IowaScaledEngineering/ckt-dingdong/doc/uss-teardrop.odt

Union Switch & Signal

Teardrop (Mechanical)

uss-teardrop.hex

Union Switch & Signal

Teardrop (Mechanical)

uss-teardrop.hex

Union Switch & Signal

Teardrop (Mechanical)

uss-teardrop.hex

Union Switch & Signal

Teardrop (Mechanical)

uss-teardrop.hex

Union Switch & Signal

Teardrop (Mechanical)

uss-teardrop.hex

Union Switch & Signal

Teardrop (Mechanical)

uss-teardrop.hex

Union Switch & Signal

Teardrop (Mechanical)

uss-teardrop.hex

Union Switch & Signal

Teardrop (Mechanical)

uss-teardrop.hex

Union Switch & Signal

Teardrop (Mechanical)

uss-teardrop.hex

Union Switch & Signal

Teardrop (Mechanical)

uss-teardrop.hex

Union Switch & Signal

Teardrop (Mechanical)

uss-teardrop.hex

Union Switch & Signal

Teardrop (Mechanical)

uss-teardrop.hex

Union Switch & Signal

Teardrop (Mechanical)

uss-teardrop.hex

Union Switch & Signal

Teardrop (Mechanical)

uss-teardrop.hex

Union Switch & Signal

Teardrop (Mechanical)

uss-teardrop.hex

Union Switch & Signal

Teardrop (Mechanical)

uss-teardrop.hex

Union Switch & Signal

Teardrop (Mechanical)

uss-teardrop.hex

Union Switch & Signal

Teardrop (Mechanical)

uss-teardrop.hex

Union Switch & Signal

Teardrop (Mechanical)

uss-teardrop.hex

Union Switch & Signal

Teardrop (Mechanical)

uss-teardrop.hex

Union Switch & Signal

Teardrop (Mechanical)

uss-teardrop.hex

Union Switch & Signal

Teardrop (Mechanical)

uss-teardrop.hex

Union Switch & Signal

Teardrop (Mechanical)

uss-teardrop.hex

Union Switch & Signal

Teardrop (Mechanical)

uss-teardrop.hex

Union Switch & Signal

Teardrop (Mechanical)

uss-teardrop.hex

Union Switch & Signal

Teardrop (Mechanical)

uss-teardrop.hex

Union Switch & Signal

Teardrop (Mechanical)

uss-teardrop.hex

Union Switch & Signal

Teardrop (Mechanical)

uss-teardrop.hex

Union Switch & Signal

Teardrop (Mechanical)

uss-teardrop.hex

Union Switch & Signal

Teardrop (Mechanical)

uss-teardrop.hex
