IowaScaledEngineering/ckt-dingdong/doc/wrs-222.odt

Western Railroad Supply

Type 222 (Mechanical)

wrs-222.hex

Western Railroad Supply

Type 222 (Mechanical)

wrs-222.hex

Western Railroad Supply

Type 222 (Mechanical)

wrs-222.hex

Western Railroad Supply

Type 222 (Mechanical)

wrs-222.hex

Western Railroad Supply

Type 222 (Mechanical)

wrs-222.hex

Western Railroad Supply

Type 222 (Mechanical)

wrs-222.hex

Western Railroad Supply

Type 222 (Mechanical)

wrs-222.hex

Western Railroad Supply

Type 222 (Mechanical)

wrs-222.hex

Western Railroad Supply

Type 222 (Mechanical)

wrs-222.hex

Western Railroad Supply

Type 222 (Mechanical)

wrs-222.hex

Western Railroad Supply

Type 222 (Mechanical)

wrs-222.hex

Western Railroad Supply

Type 222 (Mechanical)

wrs-222.hex

Western Railroad Supply

Type 222 (Mechanical)

wrs-222.hex

Western Railroad Supply

Type 222 (Mechanical)

wrs-222.hex

Western Railroad Supply

Type 222 (Mechanical)

wrs-222.hex

Western Railroad Supply

Type 222 (Mechanical)

wrs-222.hex

Western Railroad Supply

Type 222 (Mechanical)

wrs-222.hex

Western Railroad Supply

Type 222 (Mechanical)

wrs-222.hex

Western Railroad Supply

Type 222 (Mechanical)

wrs-222.hex

Western Railroad Supply

Type 222 (Mechanical)

wrs-222.hex

Western Railroad Supply

Type 222 (Mechanical)

wrs-222.hex

Western Railroad Supply

Type 222 (Mechanical)

wrs-222.hex

Western Railroad Supply

Type 222 (Mechanical)

wrs-222.hex

Western Railroad Supply

Type 222 (Mechanical)

wrs-222.hex

Western Railroad Supply

Type 222 (Mechanical)

wrs-222.hex

Western Railroad Supply

Type 222 (Mechanical)

wrs-222.hex

Western Railroad Supply

Type 222 (Mechanical)

wrs-222.hex

Western Railroad Supply

Type 222 (Mechanical)

wrs-222.hex

Western Railroad Supply

Type 222 (Mechanical)

wrs-222.hex

Western Railroad Supply

Type 222 (Mechanical)

wrs-222.hex
