IowaScaledEngineering/ckt-dingdong/doc/datasheets/drawing-13x18.png

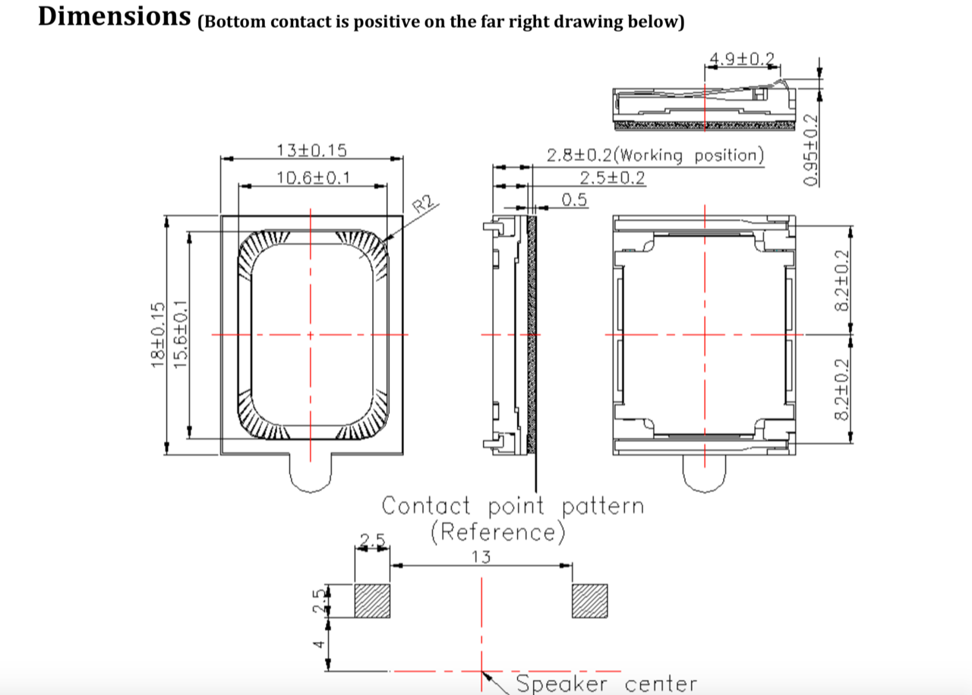
doc/datasheets/drawing-13x18.png
