IowaScaledEngineering/ckt-dingdong/doc/soundbytes-wiring.png

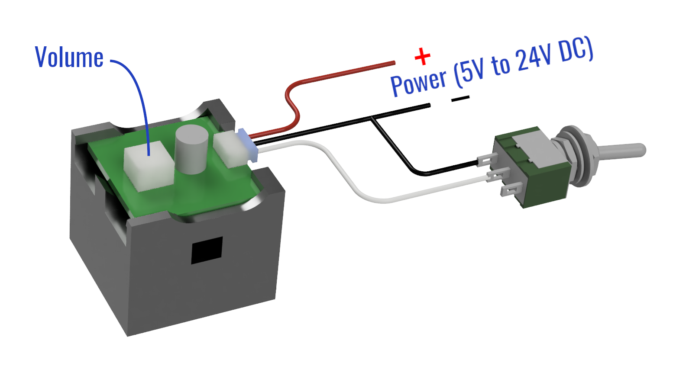
doc/soundbytes-wiring.png
