IowaScaledEngineering/ckt-dingdong/pg/ckt-dingdong-spk-array-v2.0-9ae124d/ckt-dingdong-spk.pdf

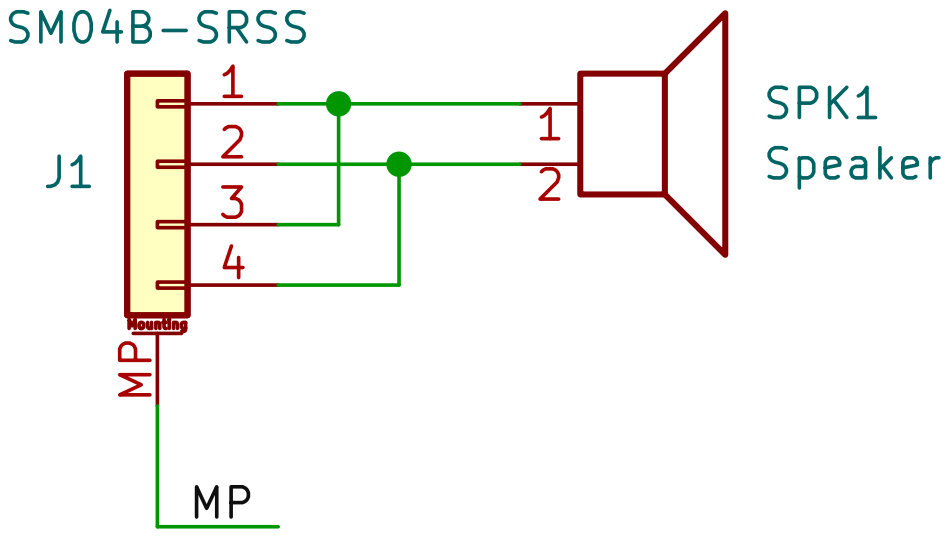
[picture p14: page 1]

File: ckt-dingdong-spk.kicad_sch Sheet: /
Id: 1/1 Title:
