IowaScaledEngineering/ckt-dingdong/pg/ckt-dingdong-prog-v1.2-79bff29/ckt-dingdong-prog.pdf

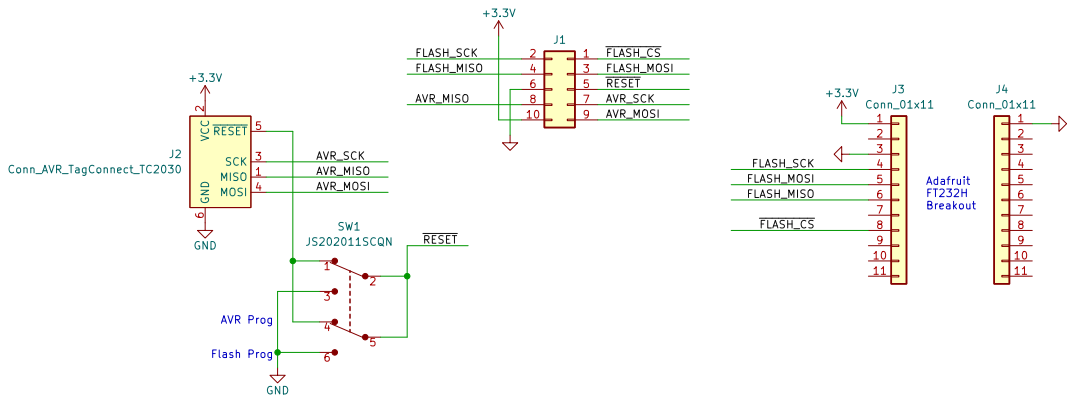
[picture p15: page 1]

2 SCK 3 MOSI 4 ~{RESET} 5 GND

File: ckt-dingdong-prog.kicad_sch Sheet: /
Id: 1/1 Title:
