IowaScaledEngineering/ckt-dingdong/pg/ckt-dingdong-flash-array-v1.0-cea9687/ckt-dingdong-flash.pdf

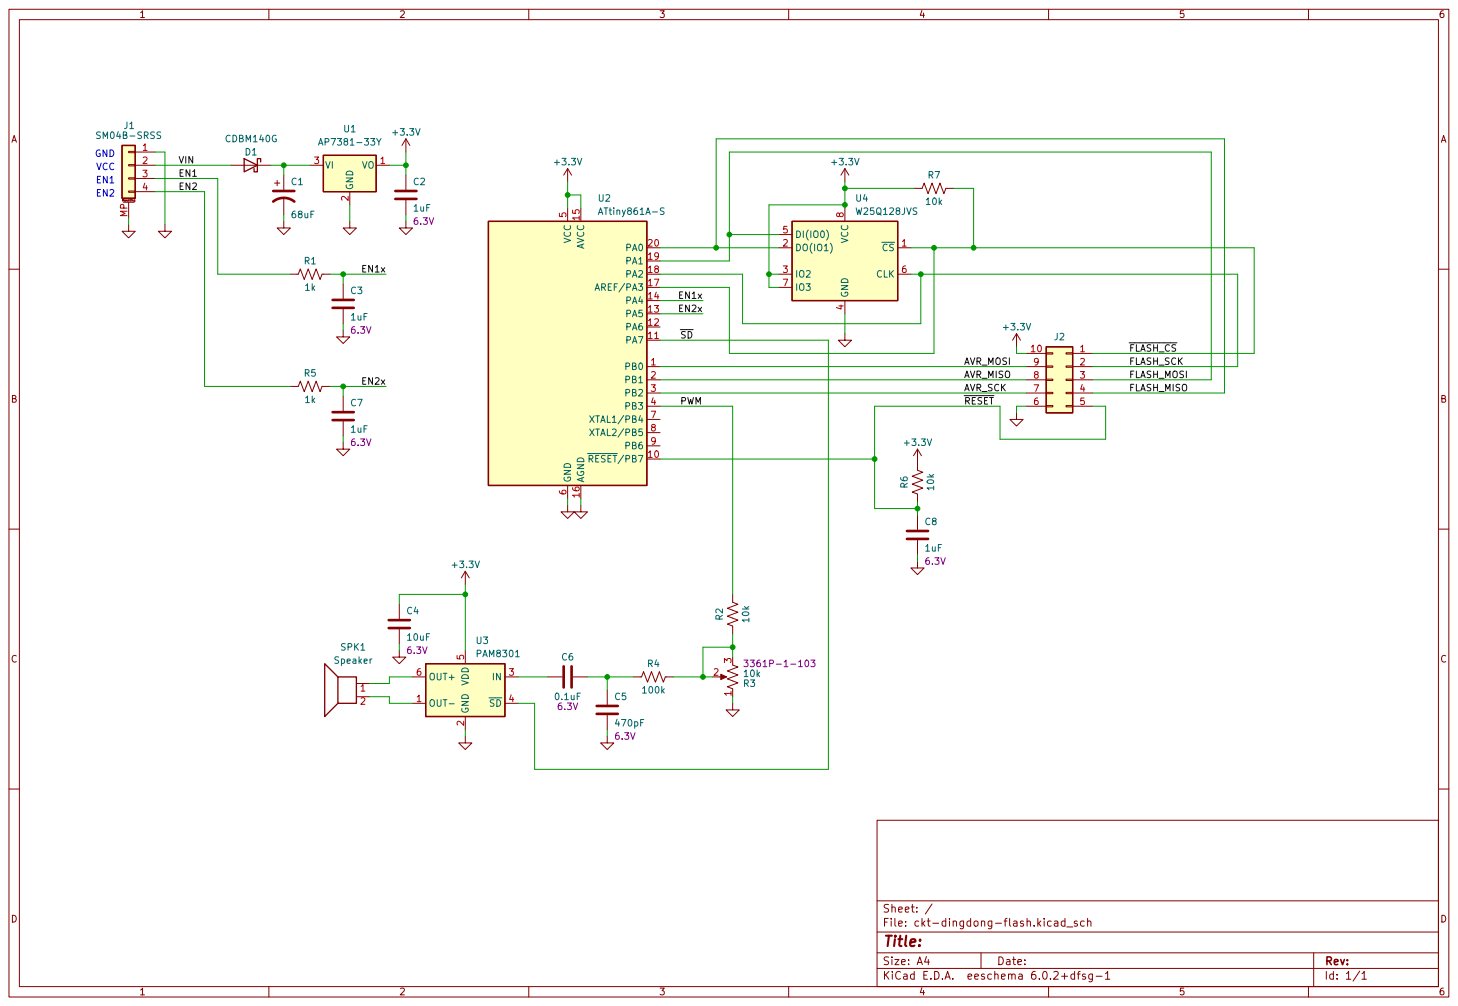
[picture p16: page 1]

AVR_MOSI AVR_SCK AVR_MISO 8 | 3

File: ckt-dingdong-flash.kicad_sch Sheet: / +3.3V C4
