IowaScaledEngineering/ckt-dingdong/pg/ckt-dingdong-v2.0-0ca3188/ckt-dingdong.pdf

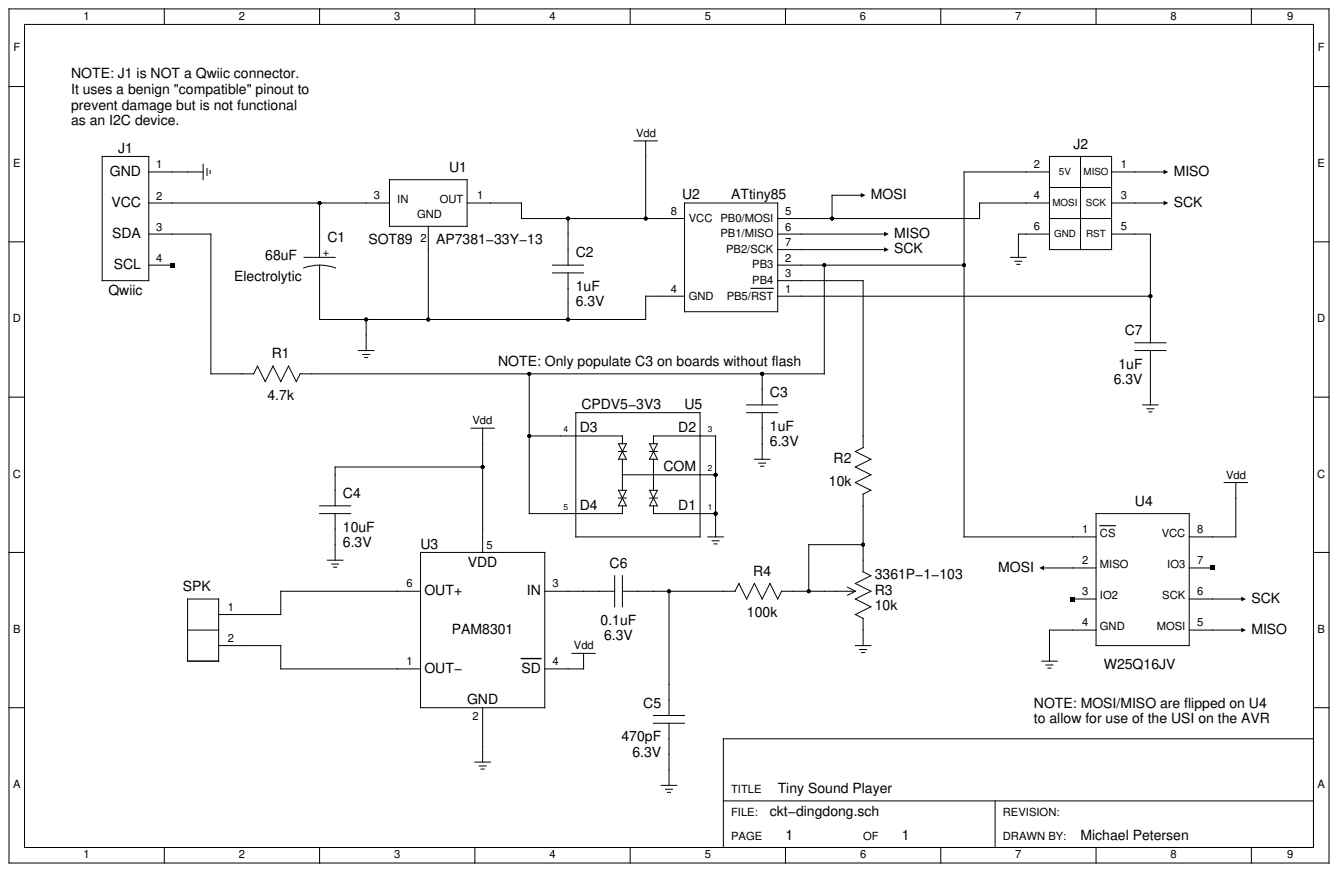
[picture p17: page 1]

NOTE: J1 is NOT a Qwiic connector.
It uses a benign "compatible" pinout to
prevent damage but is not functional
as an I2C device.

3 PB4
1 PB5/RST

NOTE: Only populate C3 on boards without flash

NOTE: MOSI/MISO are flipped on U4
to allow for use of the USI on the AVR
