IowaScaledEngineering/ckt-dingdong/pg/ckt-dingdong-flash-v1.0-e6c6ba8/ckt-dingdong-flash.pdf

AVR_MOSI AVR_SCK AVR_MISO 8 | 3

File: ckt-dingdong-flash.kicad_sch Sheet: / +3.3V C4
