IowaScaledEngineering/ckt-dingdong/pg/ckt-dingdong-array-v1.1-d16e484/ckt-dingdong-array-pcb.pdf

# ckt-dingdong-array.pcb

# 1. Table of Contents (This Page) Created on Sat May 14 21:11:04 2022

# 2. top 3. bottom 4. outline 5. plated-drill 6. unplated-drill 7. componentmask 8. soldermask 9. topsilk 10. bottomsilk 11. toppaste 12. bottompaste 13. topassembly 14. bottomassembly 15. fab

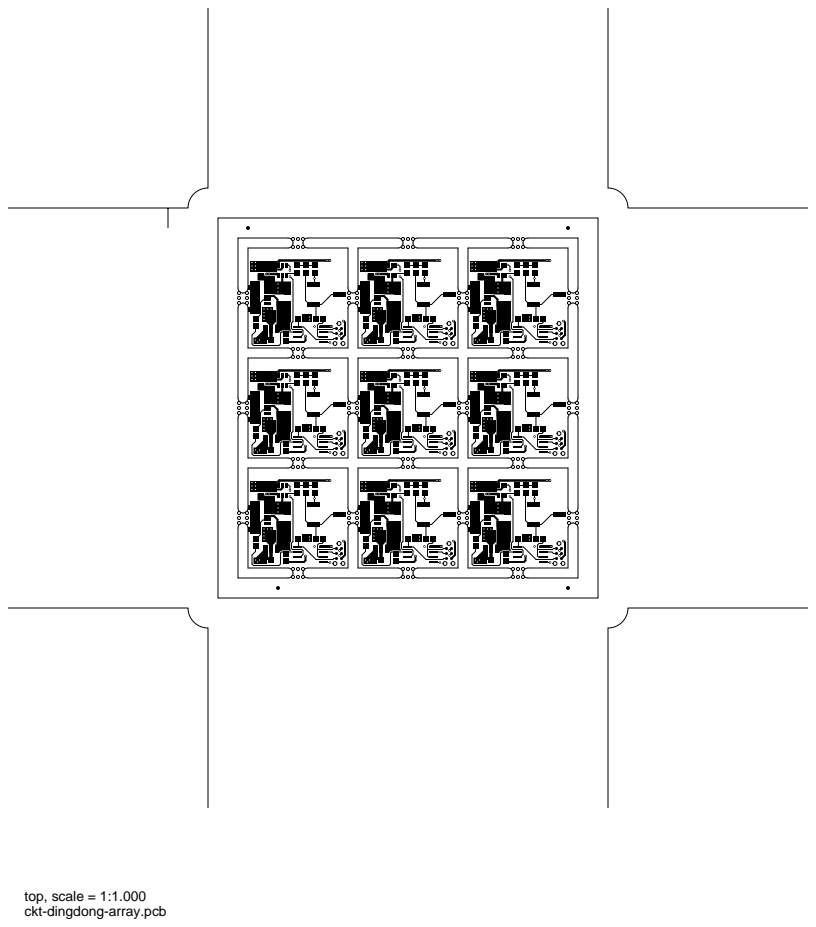
[picture p18: page 2]
top, scale = 1:1.000

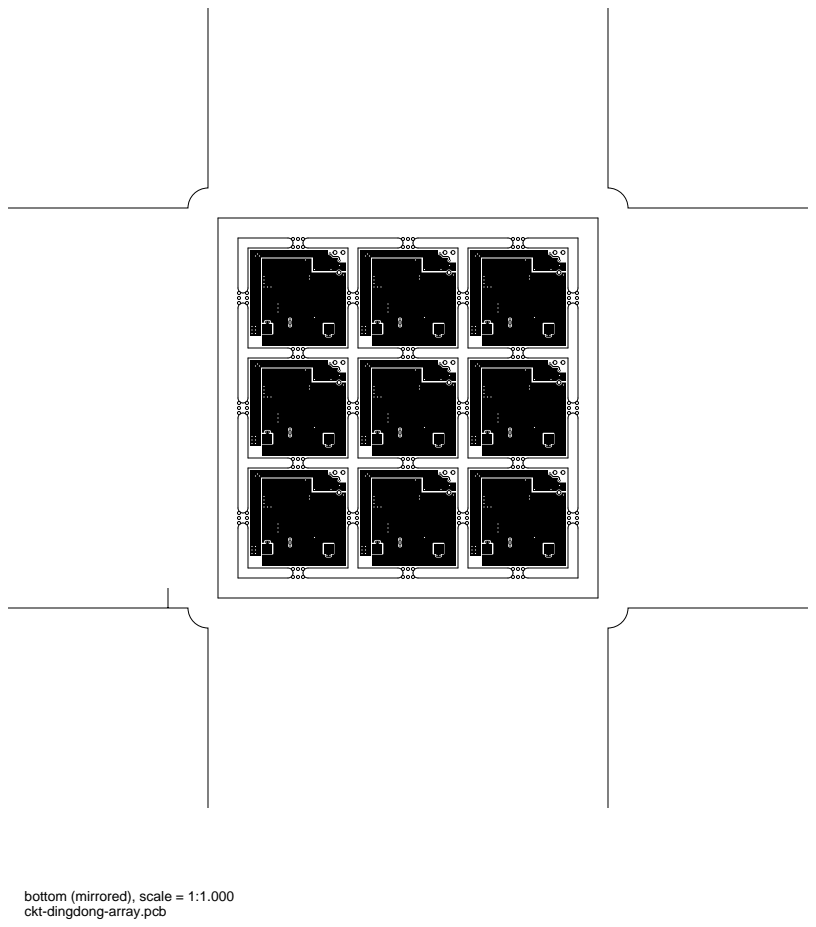
[picture p19: page 3]

bottom (mirrored), scale = 1:1.000

outline, scale = 1:1.000

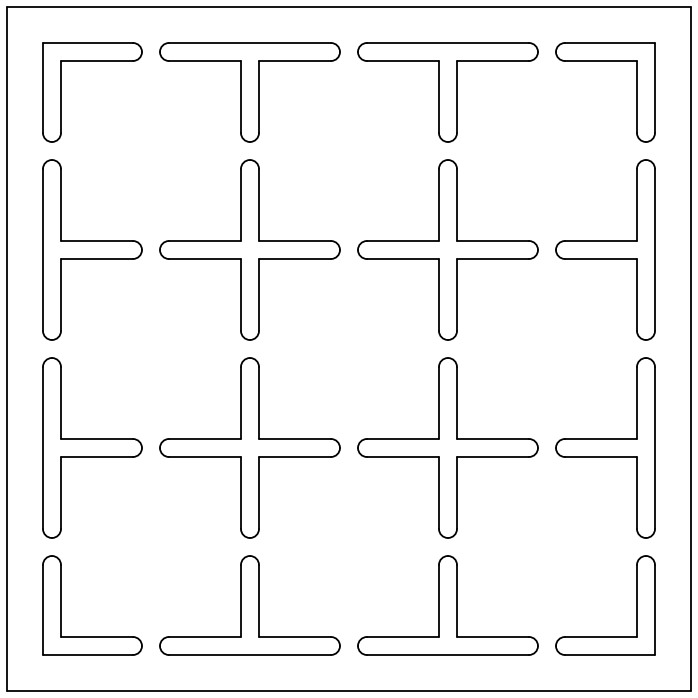
[picture p20: figure]
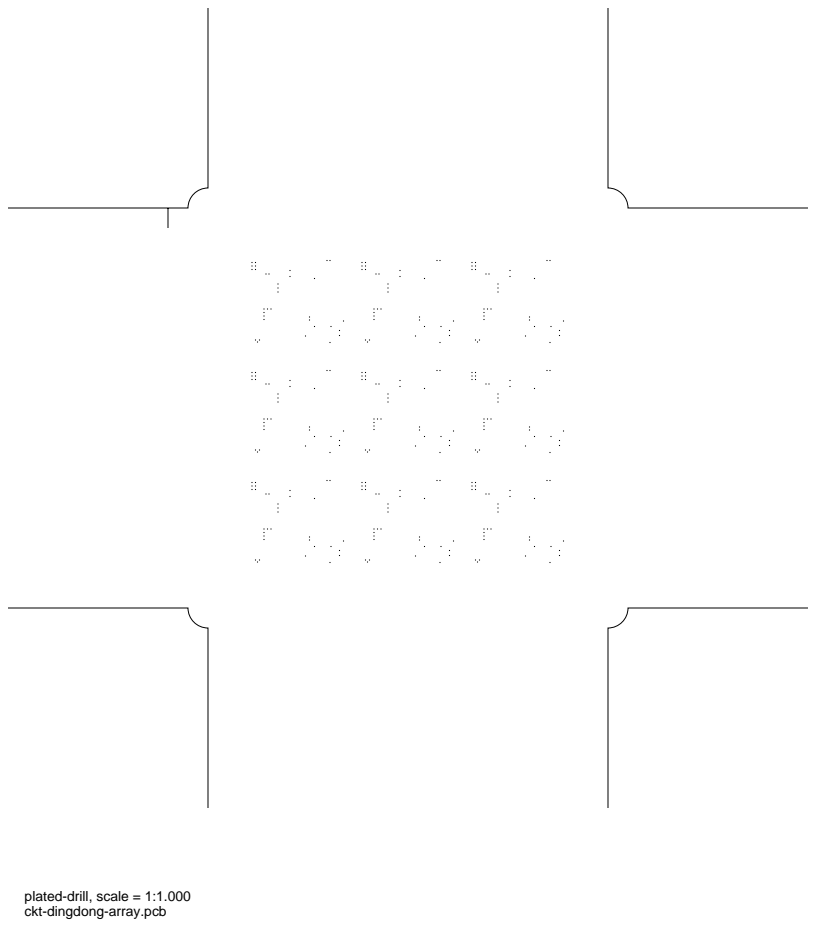
[picture p21: page 5]

plated-drill, scale = 1:1.000

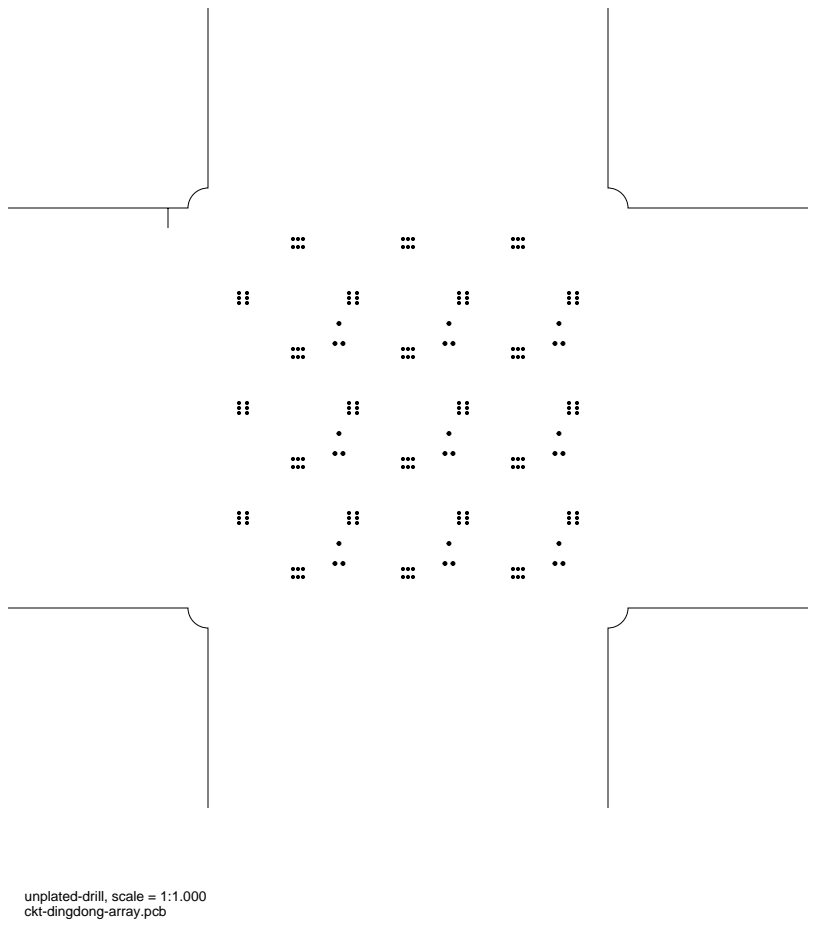
[picture p22: page 6]

unplated-drill, scale = 1:1.000

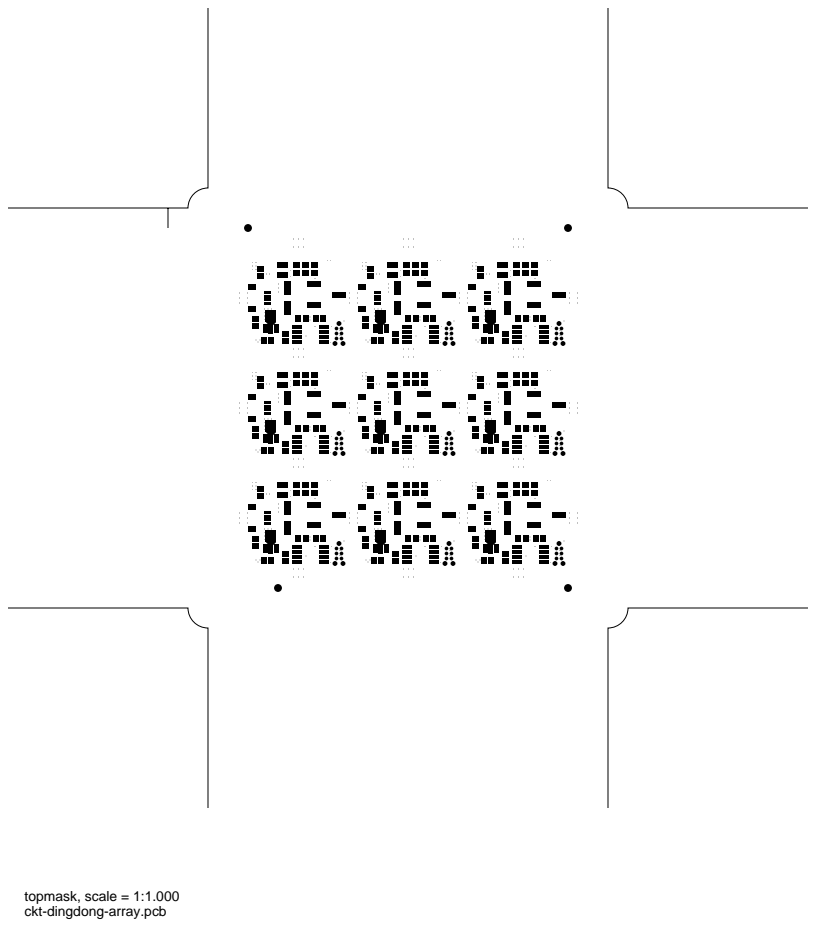
[picture p23: page 7]
topmask, scale = 1:1.000

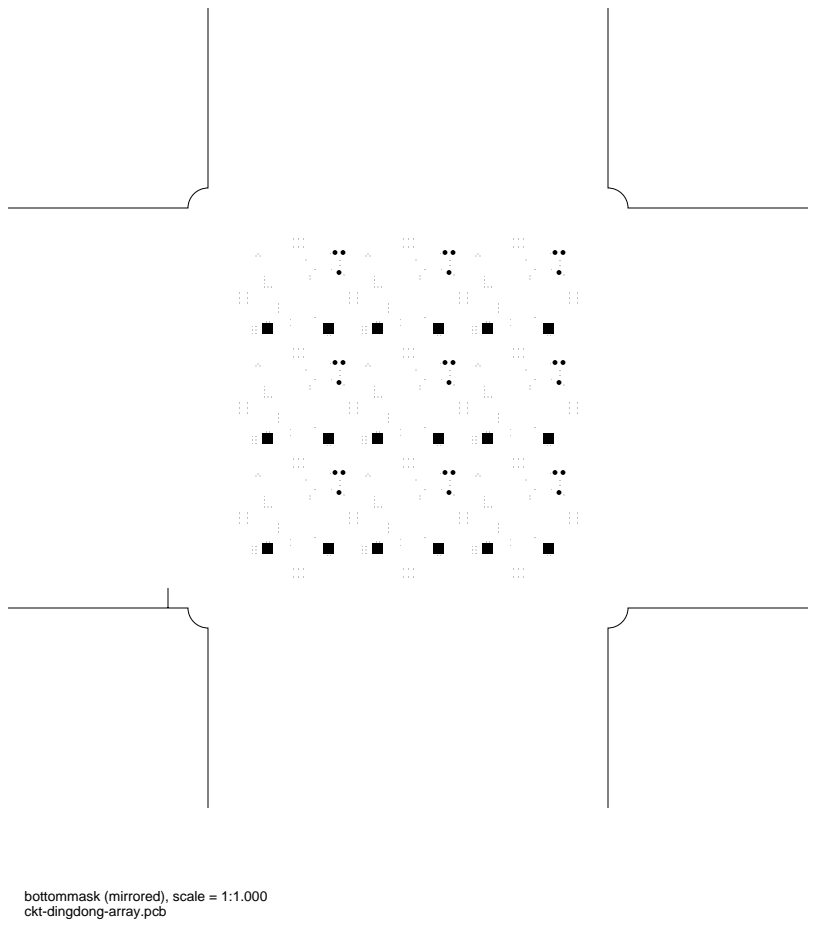
[picture p24: page 8]

bottommask (mirrored), scale = 1:1.000

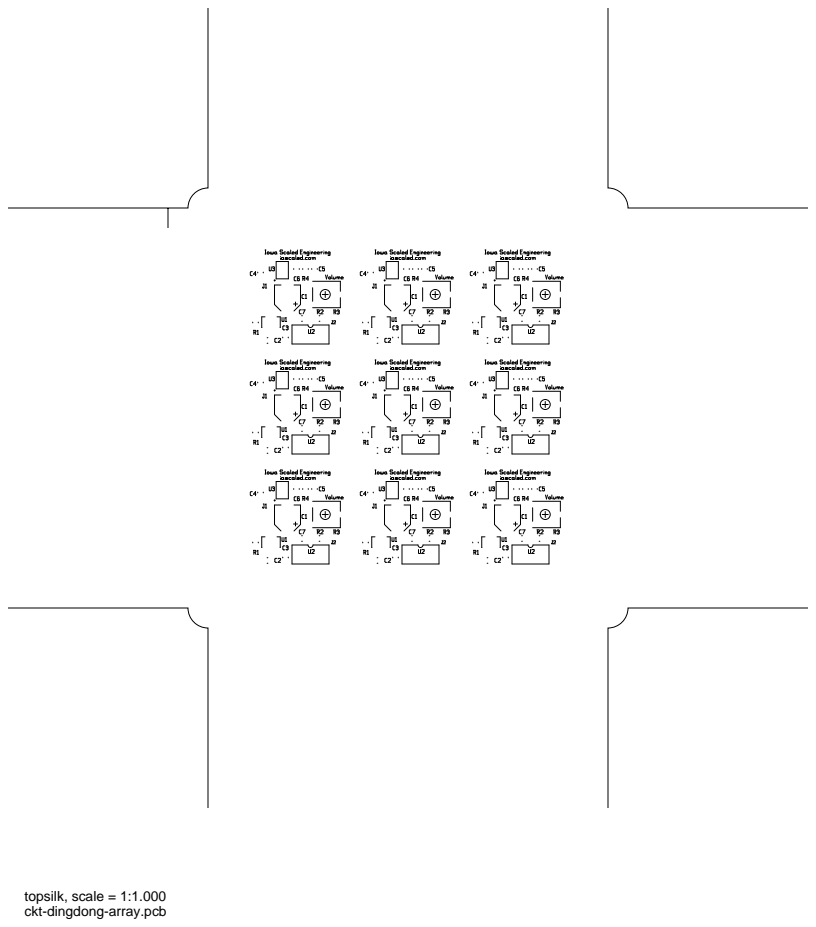
[picture p25: page 9]
topsilk, scale = 1:1.000

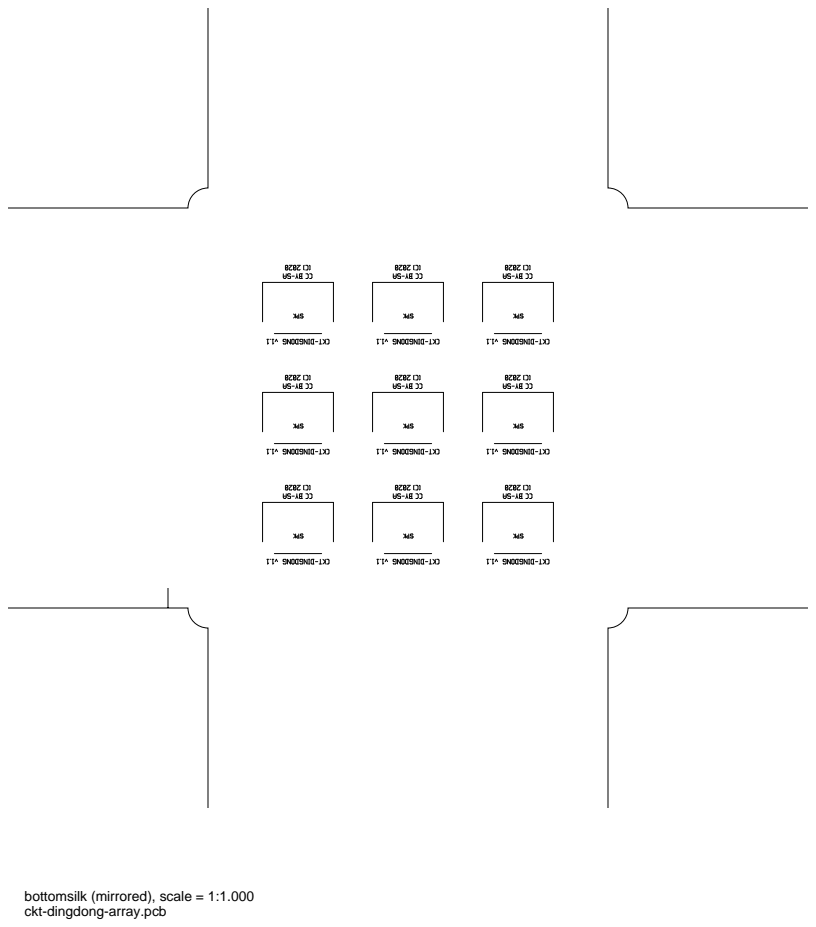
[picture p26: page 10]

bottomsilk (mirrored), scale = 1:1.000

toppaste, scale = 1:1.000 bottompaste (mirrored), scale = 1:1.000

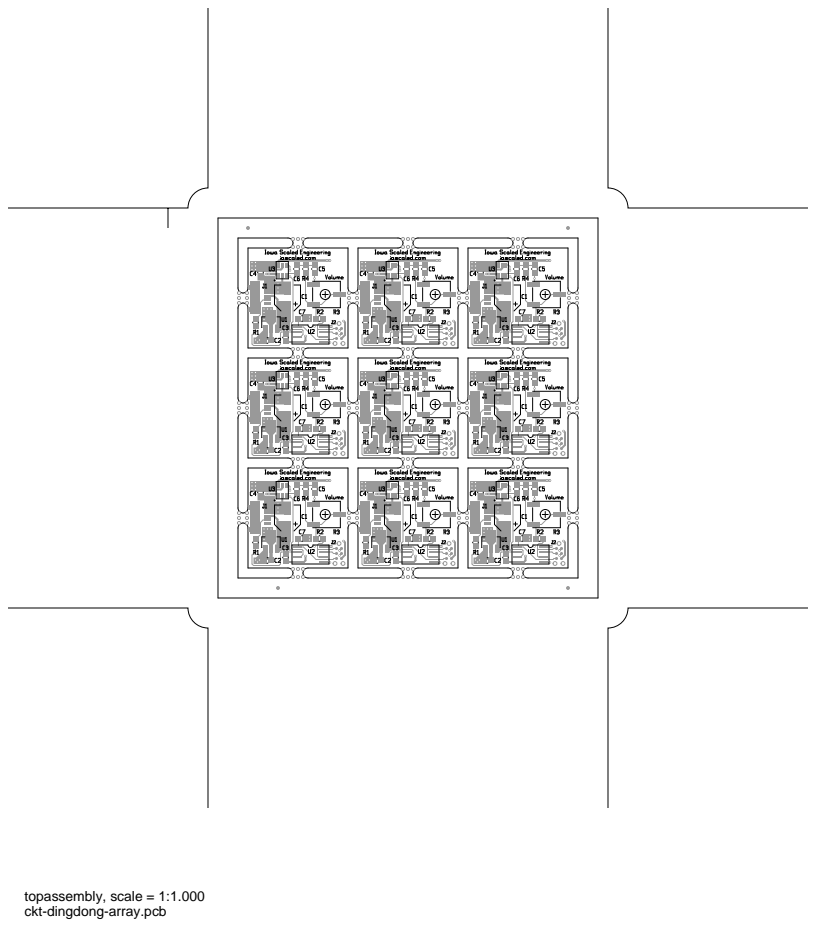
[picture p27: page 13]
topassembly, scale = 1:1.000

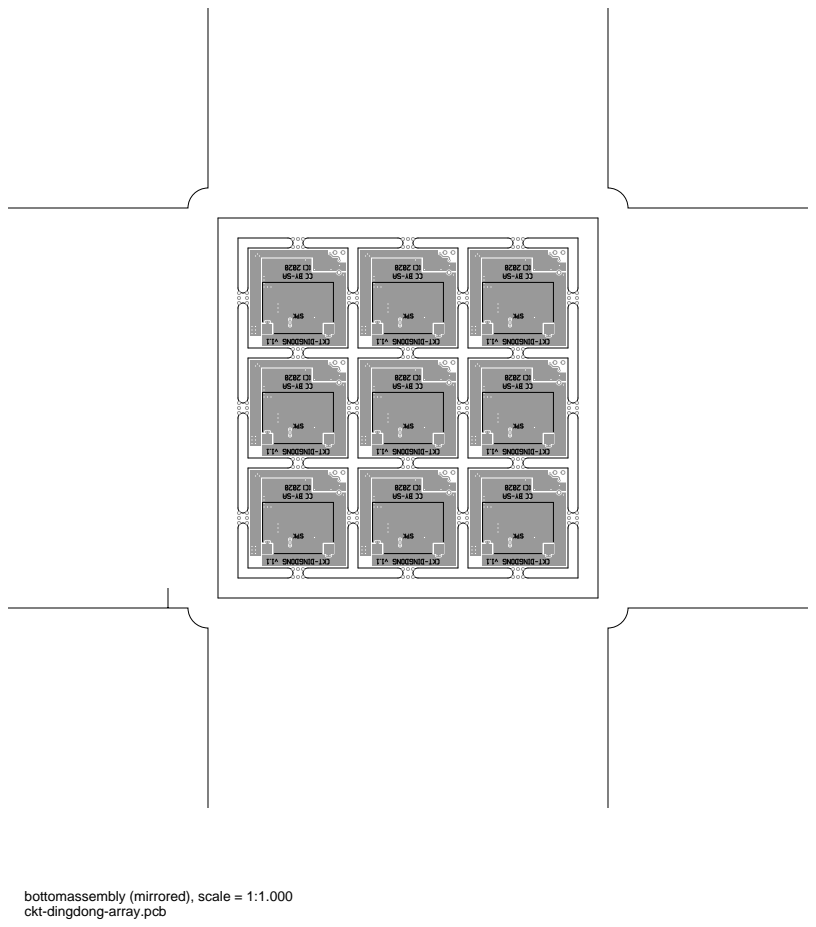
[picture p28: page 14]

bottomassembly (mirrored), scale = 1:1.000

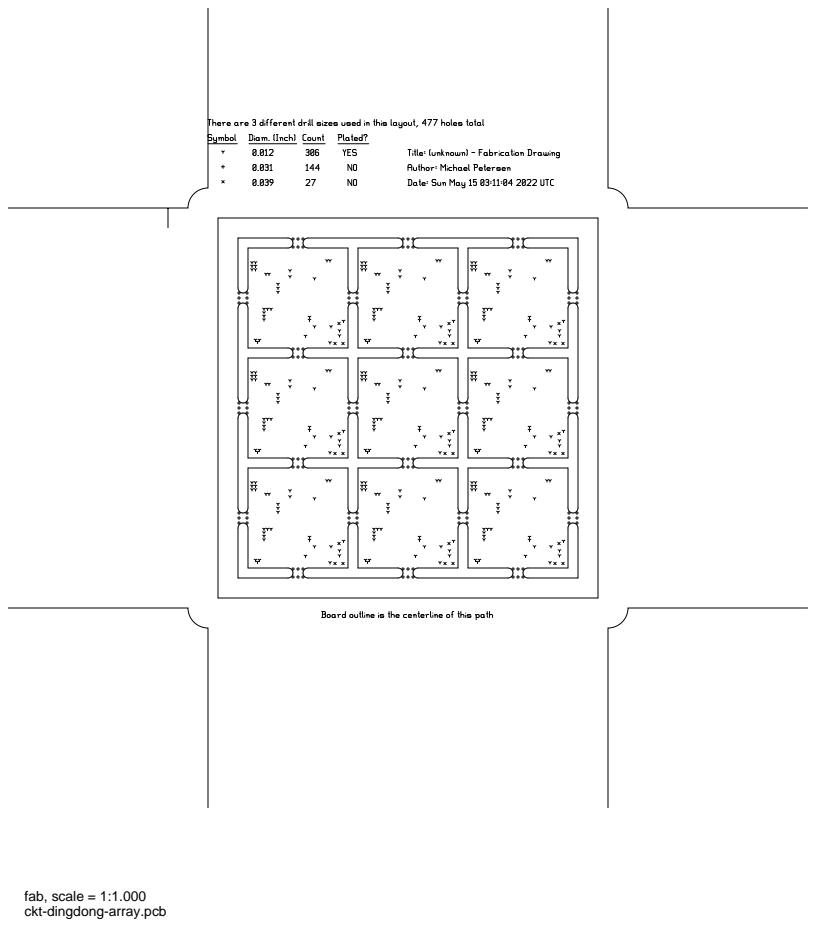
[picture p29: page 15]
fab, scale = 1:1.000
