IowaScaledEngineering/ckt-dingdong/pg/dingdong-demo-v1.0-1e173cf/dingdong-demo-pcb.pdf

# dingdong-demo.pcb

# 1. Table of Contents (This Page) Created on Tue Jun 15 20:35:32 2021

# 2. top 3. bottom 4. outline 5. plated-drill 6. componentmask 7. soldermask 8. topsilk 9. bottomsilk 10. bottompaste 11. topassembly 12. bottomassembly 13. fab

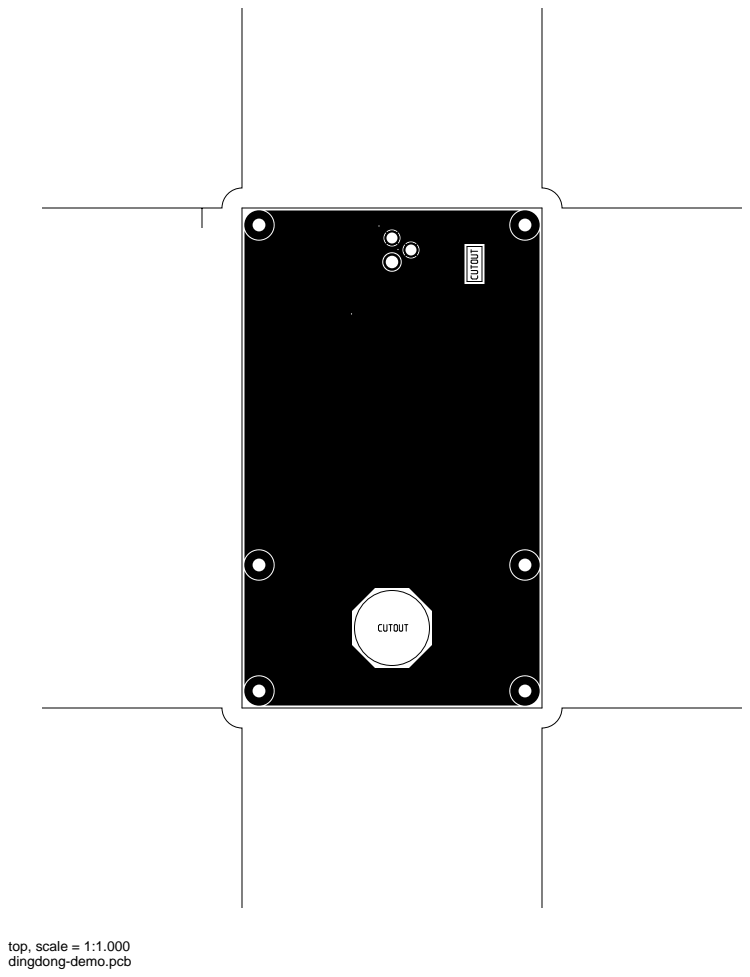
[picture p30: page 2]
top, scale = 1:1.000

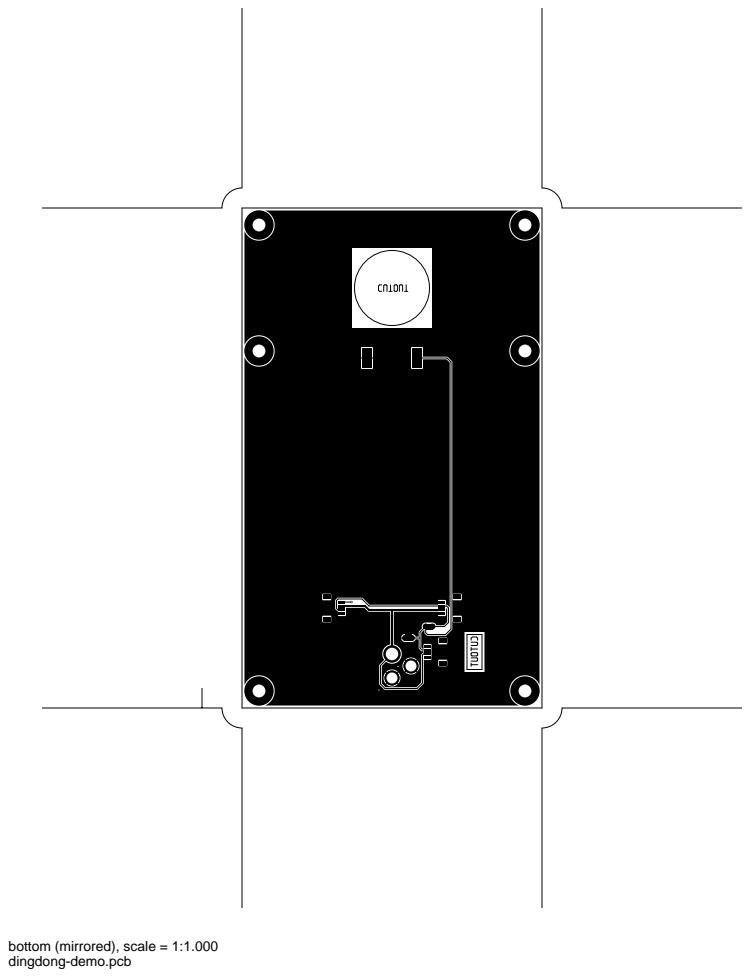
[picture p31: page 3]

bottom (mirrored), scale = 1:1.000

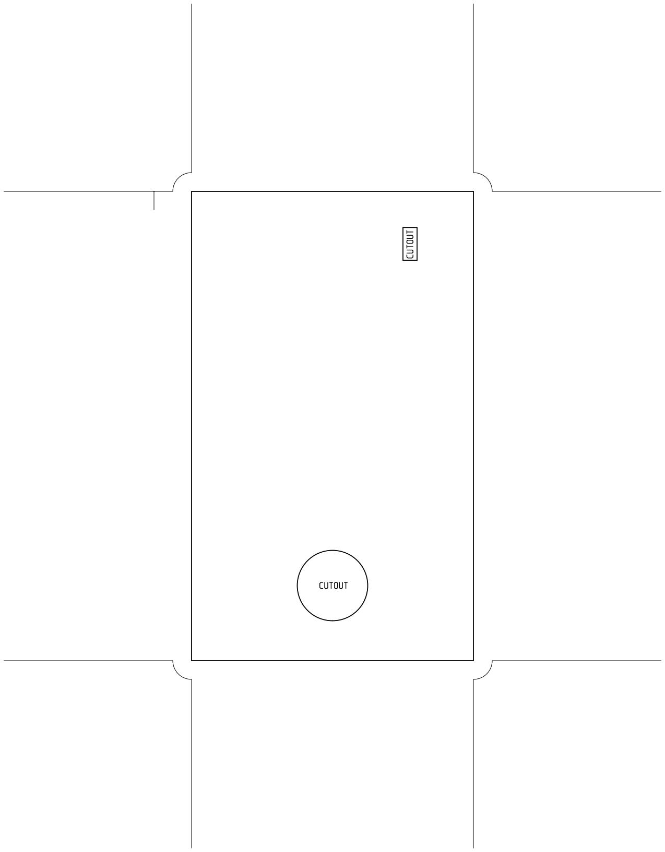
[picture p32: figure]

outline, scale = 1:1.000 plated-drill, scale = 1:1.000

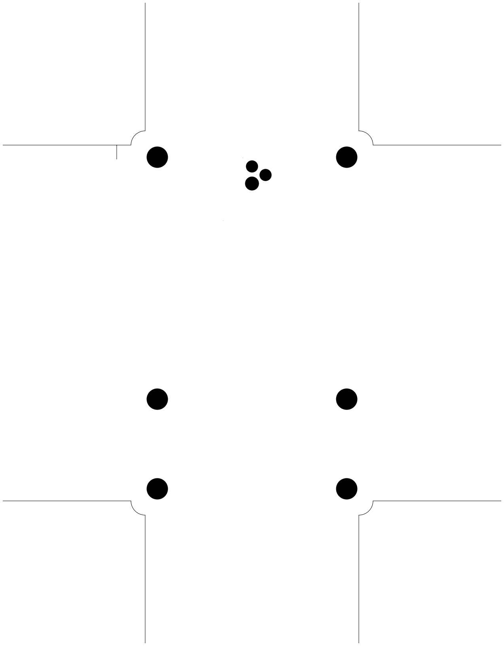
[picture p33: figure]

topmask, scale = 1:1.000

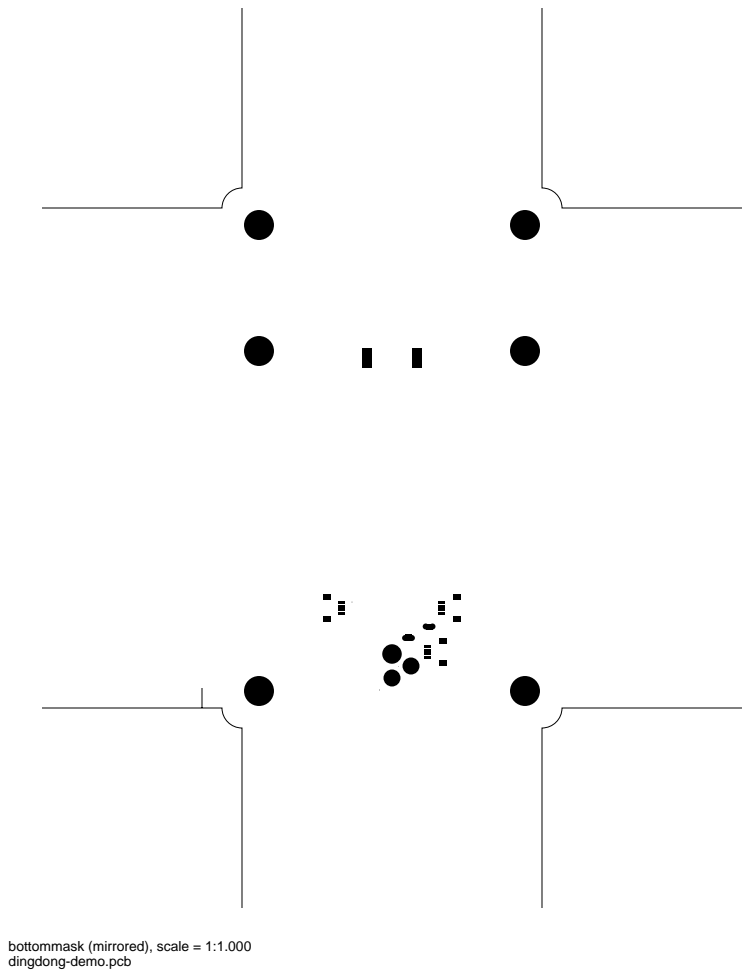
[picture p34: page 7]

bottommask (mirrored), scale = 1:1.000

topsilk, scale = 1:1.000

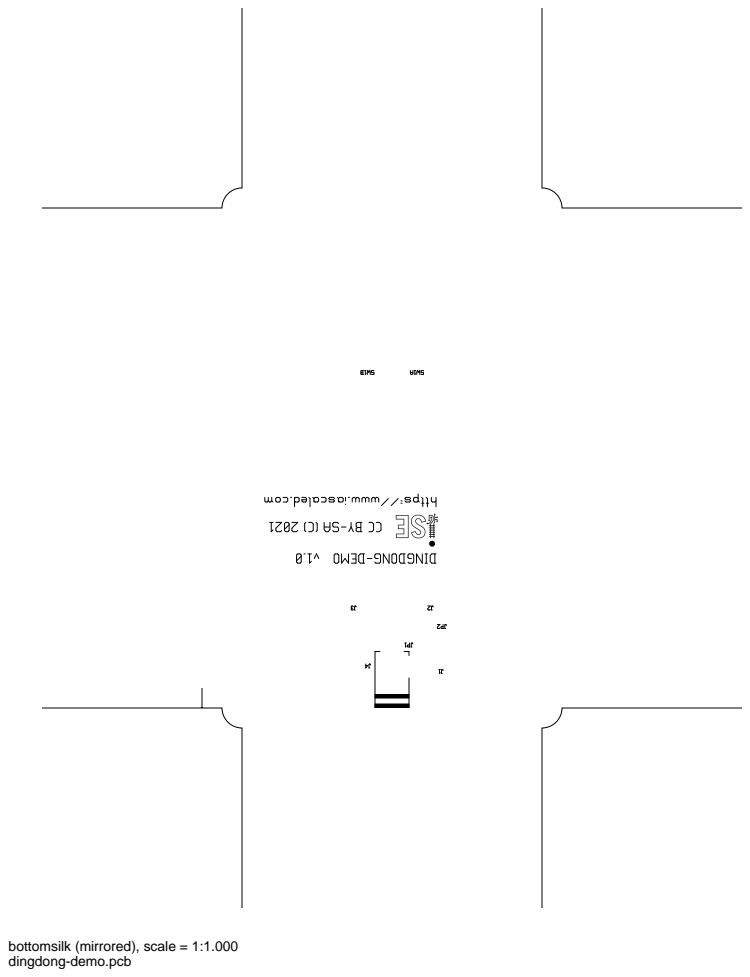
[picture p35: page 9]

bottomsilk (mirrored), scale = 1:1.000

bottompaste (mirrored), scale = 1:1.000

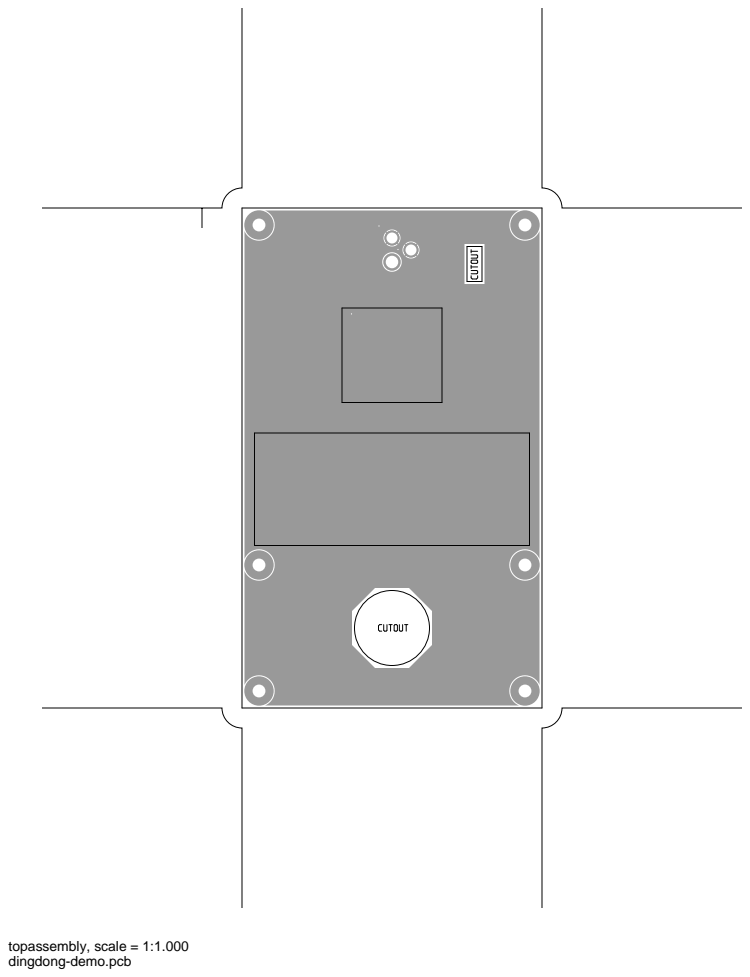
[picture p36: page 11]
topassembly, scale = 1:1.000

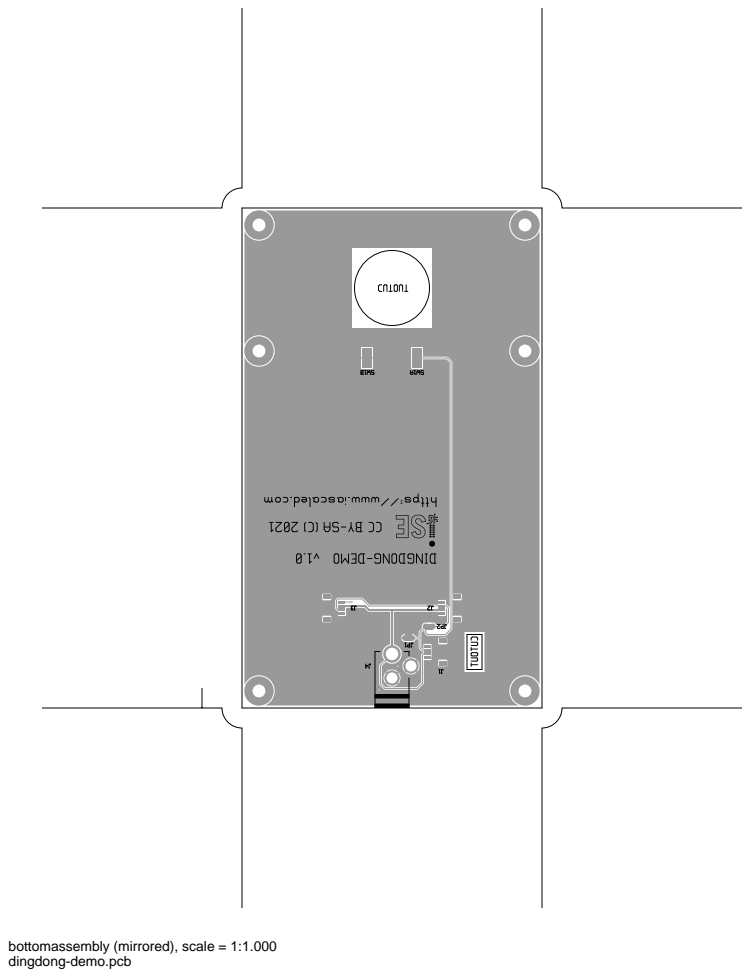
[picture p37: page 12]

bottomassembly (mirrored), scale = 1:1.000

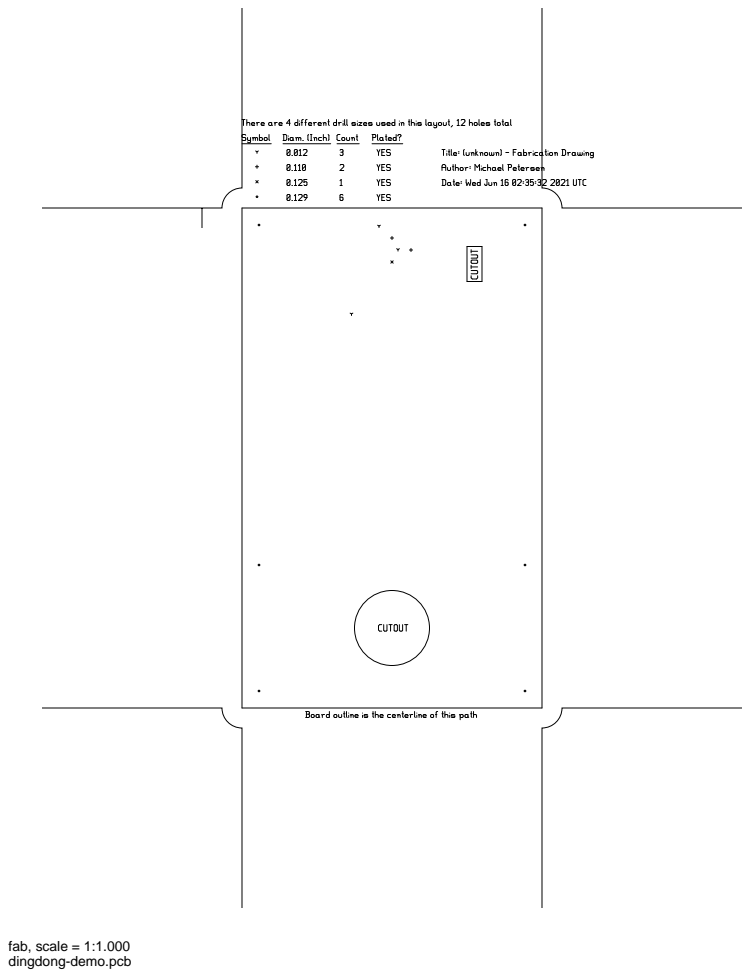
[picture p38: page 13]
fab, scale = 1:1.000
