IowaScaledEngineering/ckt-dingdong/pg/ckt-dingdong-panel-v1.1-abdfc51/ckt-dingdong-panel-pcb.pdf

# ckt-dingdong-panel.pcb

# 1. Table of Contents (This Page) Created on Sun Sep 13 11:46:48 2020

# 2. top 3. bottom 4. outline 5. plated-drill 6. unplated-drill 7. componentmask 8. soldermask 9. topsilk 10. bottomsilk 11. toppaste 12. bottompaste 13. topassembly 14. bottomassembly 15. fab

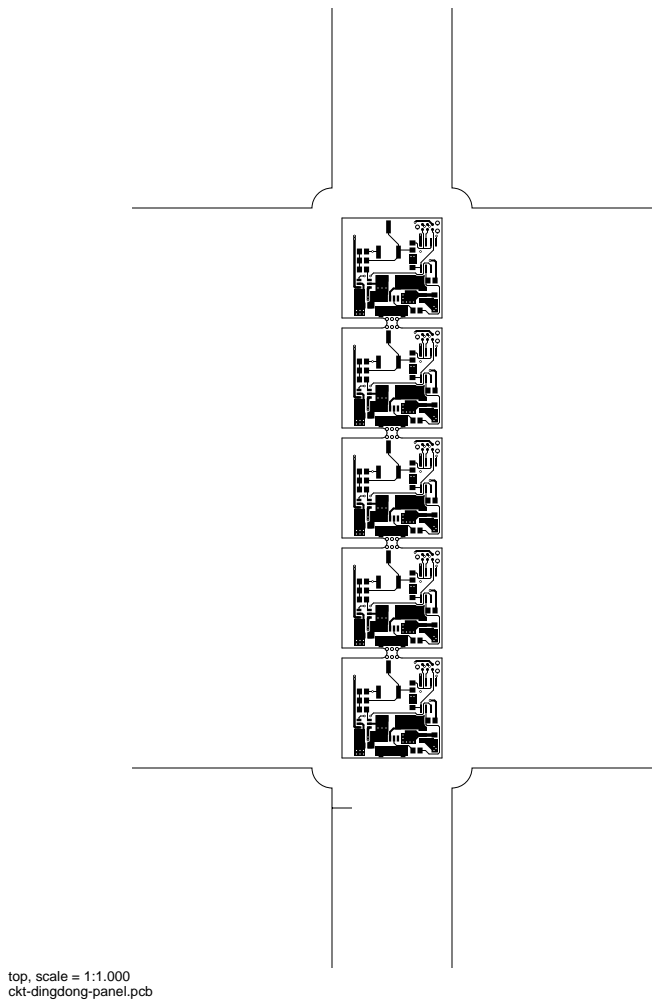
[picture p39: page 2]
top, scale = 1:1.000

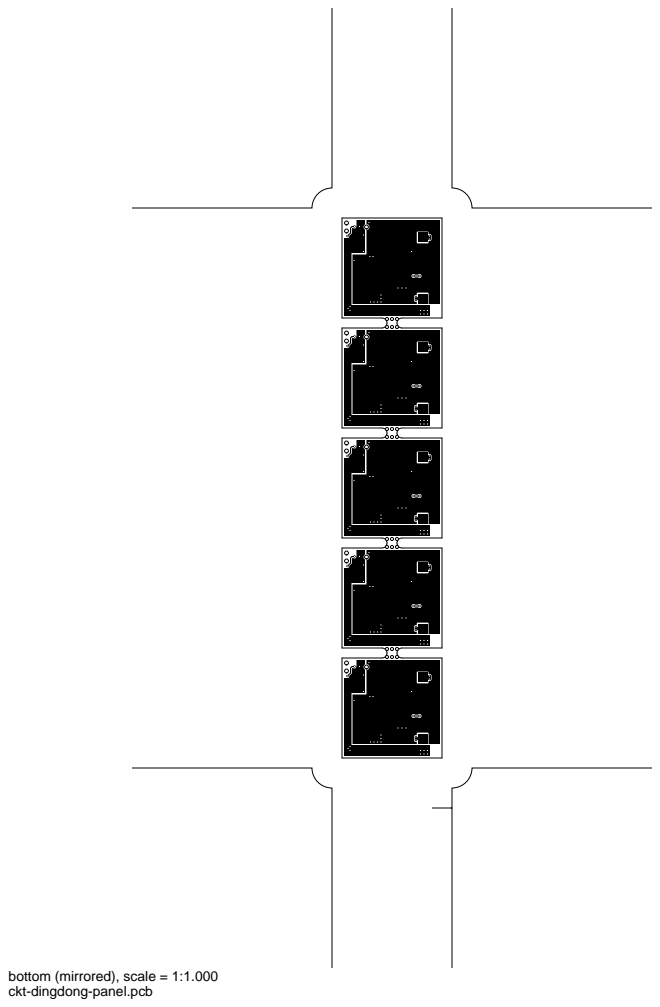
[picture p40: page 3]

bottom (mirrored), scale = 1:1.000

outline, scale = 1:1.000

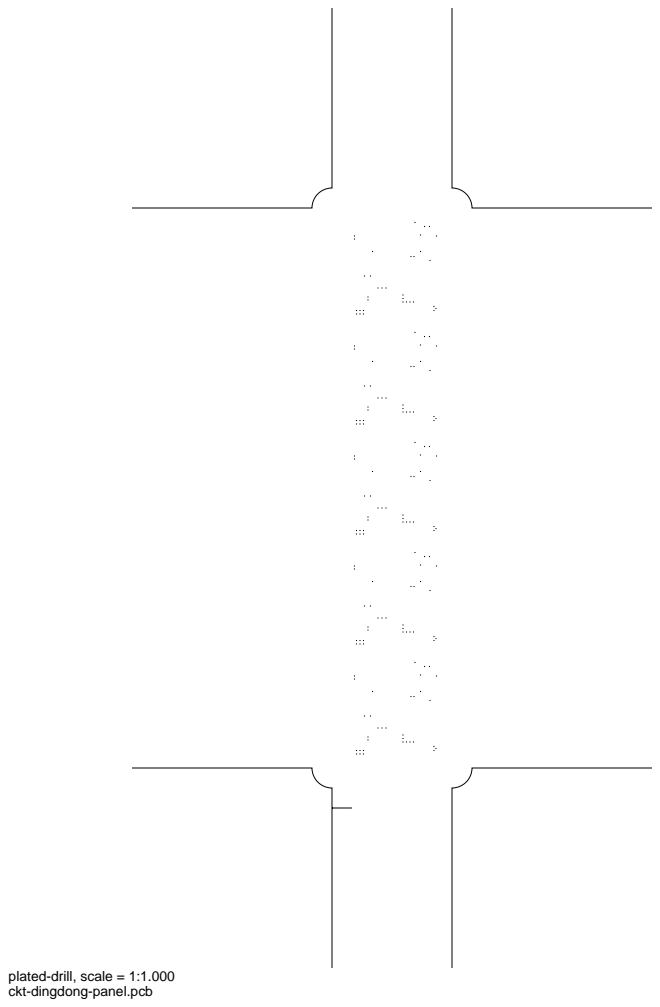
[picture p41: page 5]

plated-drill, scale = 1:1.000

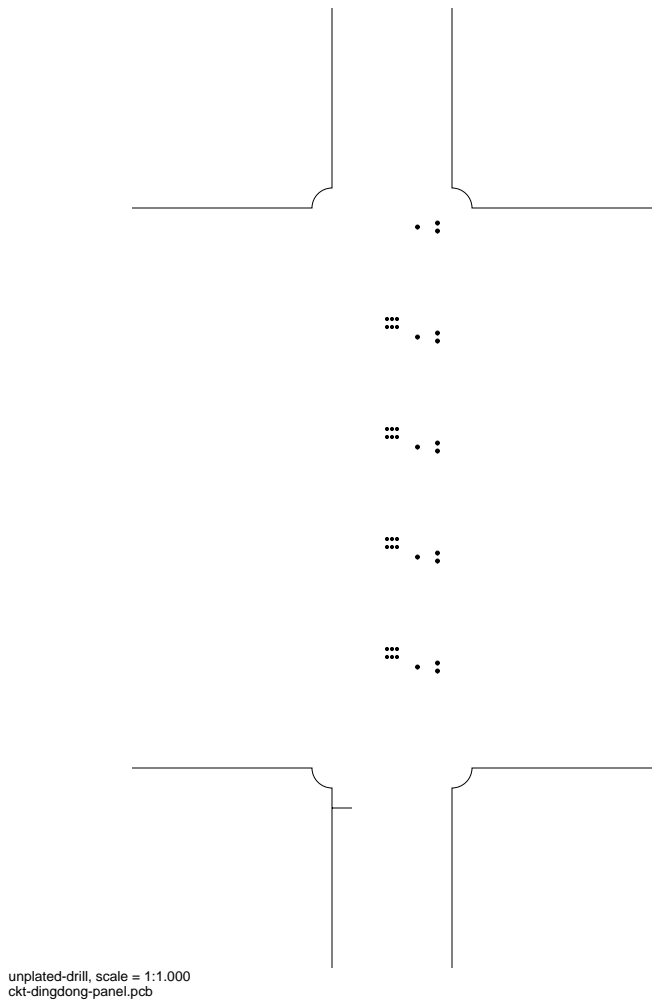
[picture p42: page 6]

unplated-drill, scale = 1:1.000

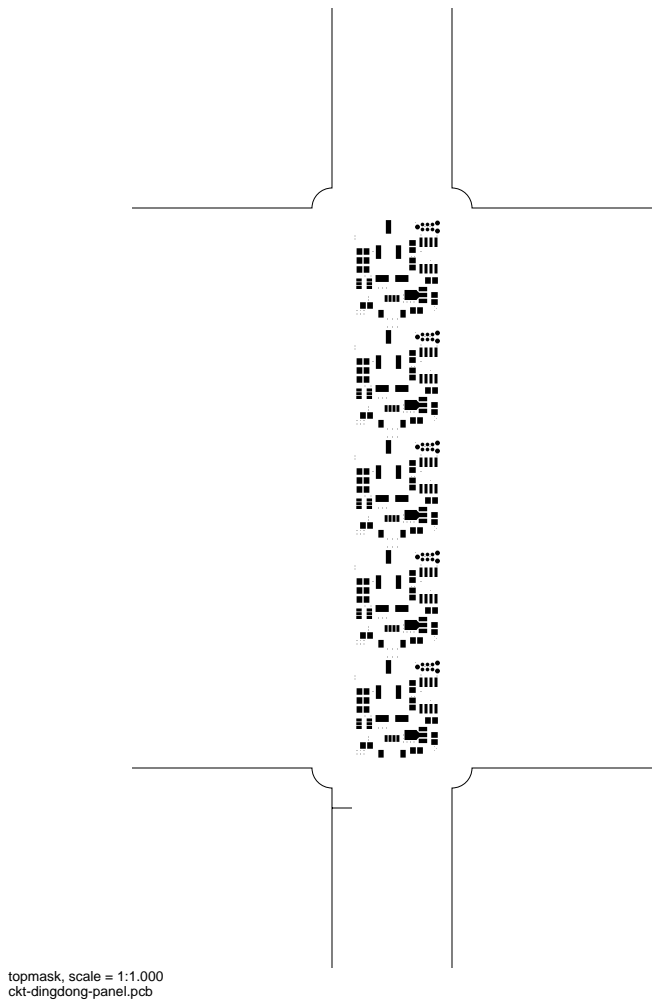
[picture p43: page 7]
topmask, scale = 1:1.000

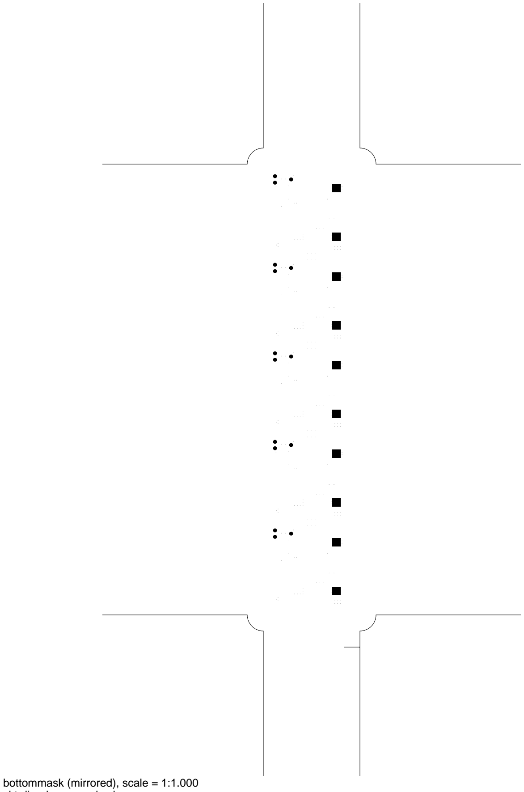
[picture p44: figure]
bottommask (mirrored), scale = 1:1.000
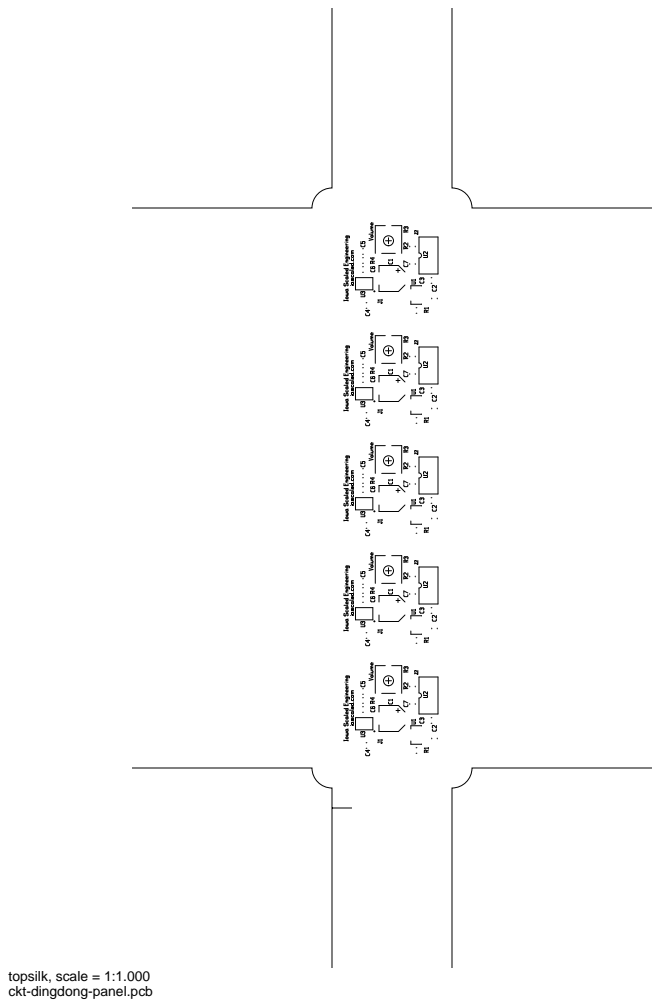
[picture p45: page 9]
topsilk, scale = 1:1.000

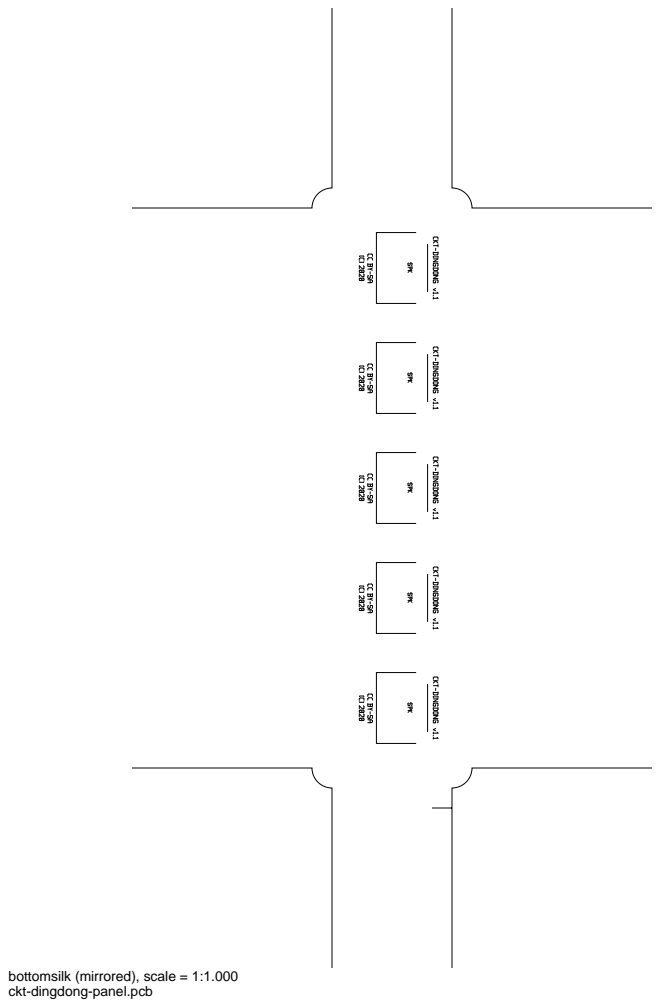
[picture p46: page 10]

bottomsilk (mirrored), scale = 1:1.000

toppaste, scale = 1:1.000 bottompaste (mirrored), scale = 1:1.000

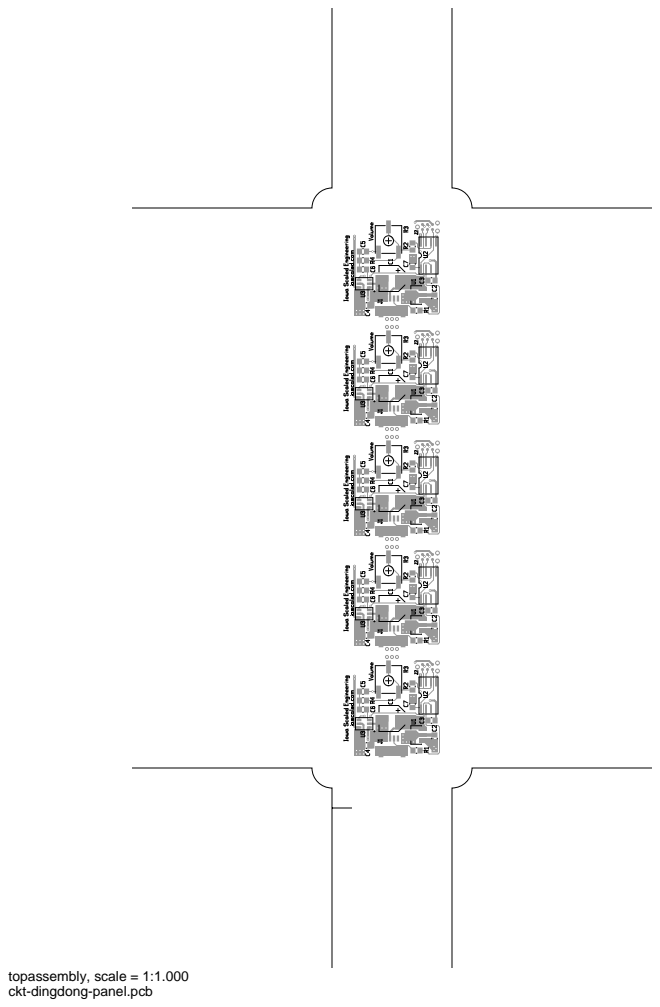
[picture p47: page 13]
topassembly, scale = 1:1.000

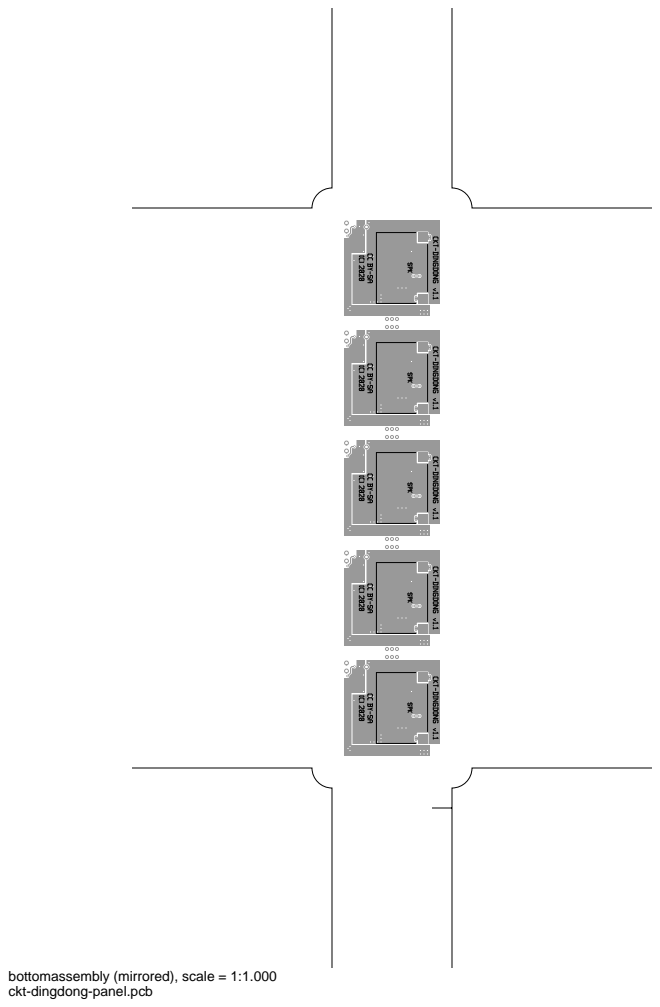
[picture p48: page 14]

bottomassembly (mirrored), scale = 1:1.000

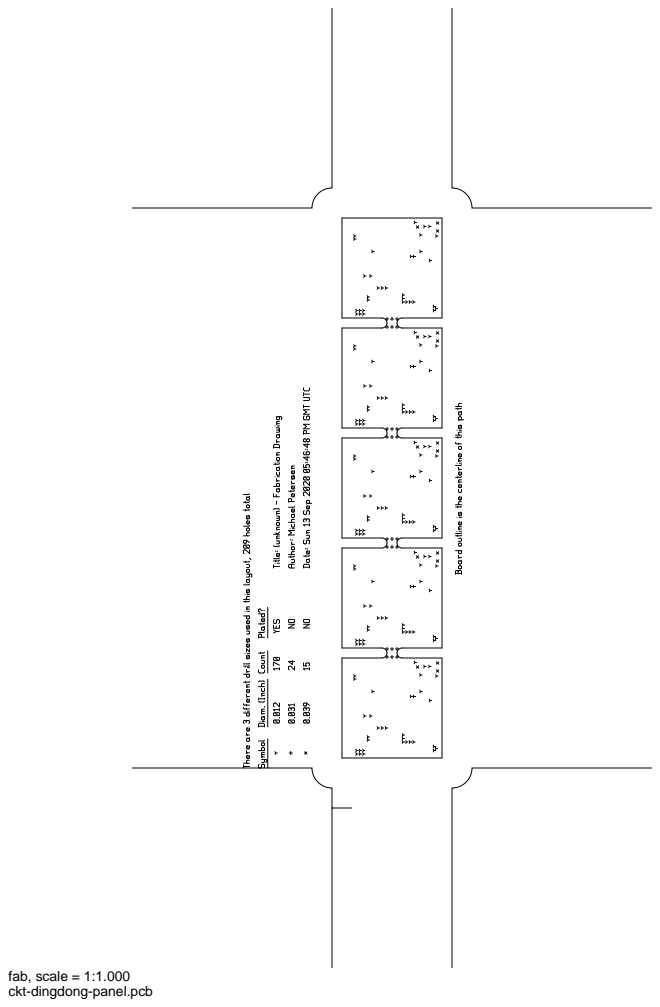
[picture p49: page 15]
fab, scale = 1:1.000
