IowaScaledEngineering/ckt-dingdong/pg/ckt-dingdong-spk-array-v2.0-9c060c7/ckt-dingdong-spk.pdf

File: ckt-dingdong-spk.kicad_sch Sheet: /
Id: 1/1 Title:
