IowaScaledEngineering/ckt-dingdong/pg/ckt-dingdong-spk-array-v1.0/ckt-dingdong-spk.pdf

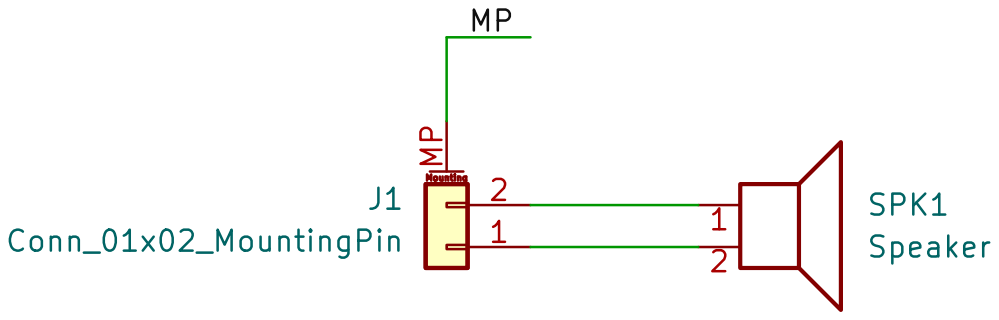
[picture p50: page 1]

File: ckt-dingdong-spk.kicad_sch Sheet: /
Id: 1/1 Title:
