IowaScaledEngineering/ckt-dingdong/pg/ckt-dingdong-panel-v1.0-f0d33bb/ckt-dingdong-panel-pcb.pdf

# ckt-dingdong-panel.pcb

# 1. Table of Contents (This Page) Created on Wed Aug 19 21:04:09 2020

# 2. top 3. bottom 4. outline 5. plated-drill 6. unplated-drill 7. componentmask 8. soldermask 9. topsilk 10. bottomsilk 11. toppaste 12. bottompaste 13. topassembly 14. bottomassembly 15. fab

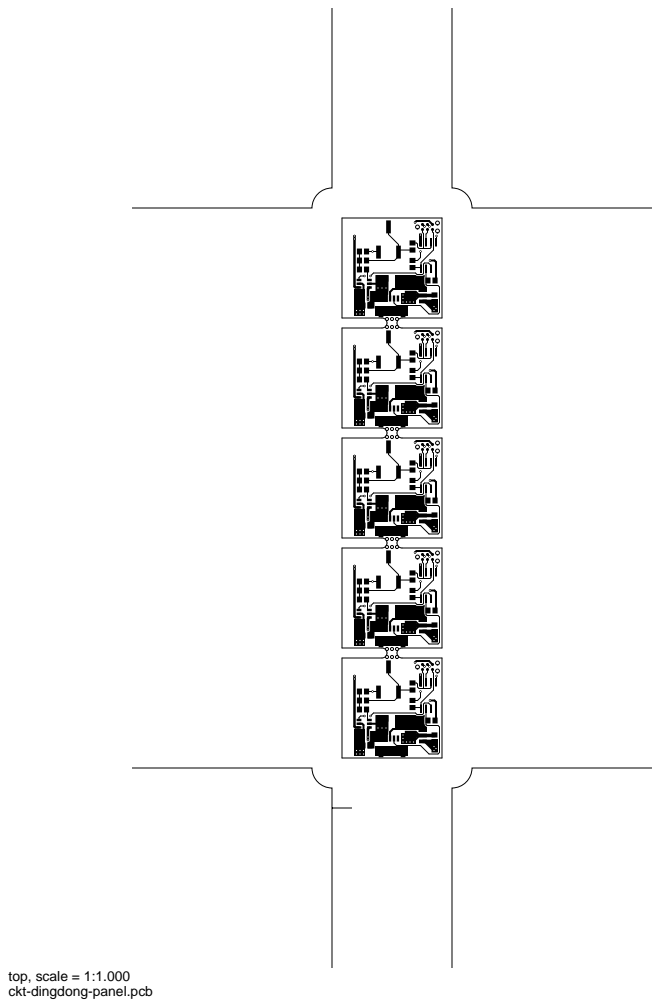
[picture p51: page 2]
top, scale = 1:1.000

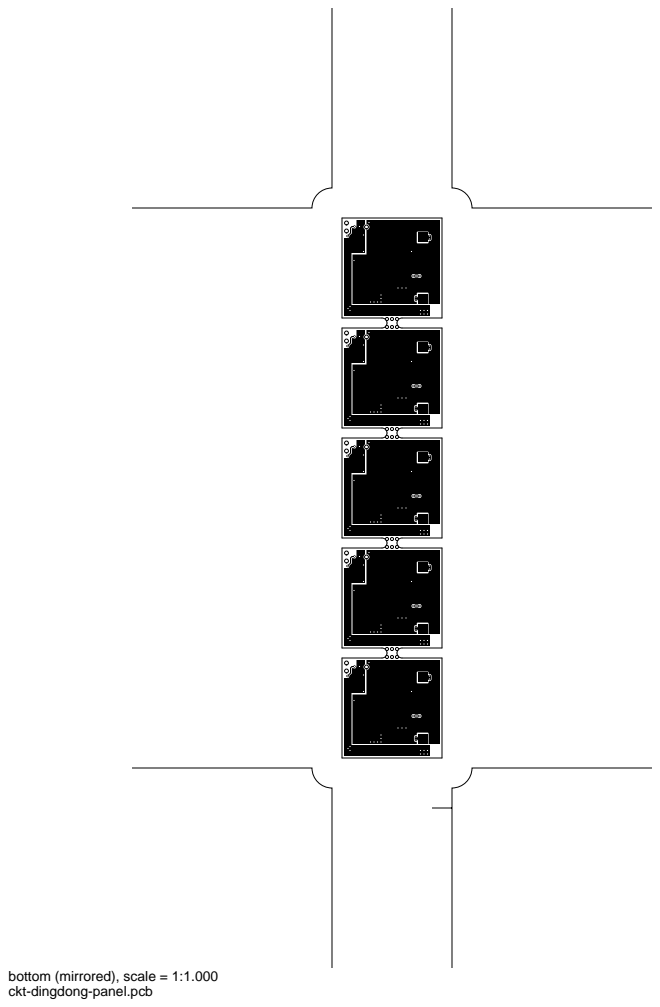
[picture p52: page 3]

bottom (mirrored), scale = 1:1.000

outline, scale = 1:1.000

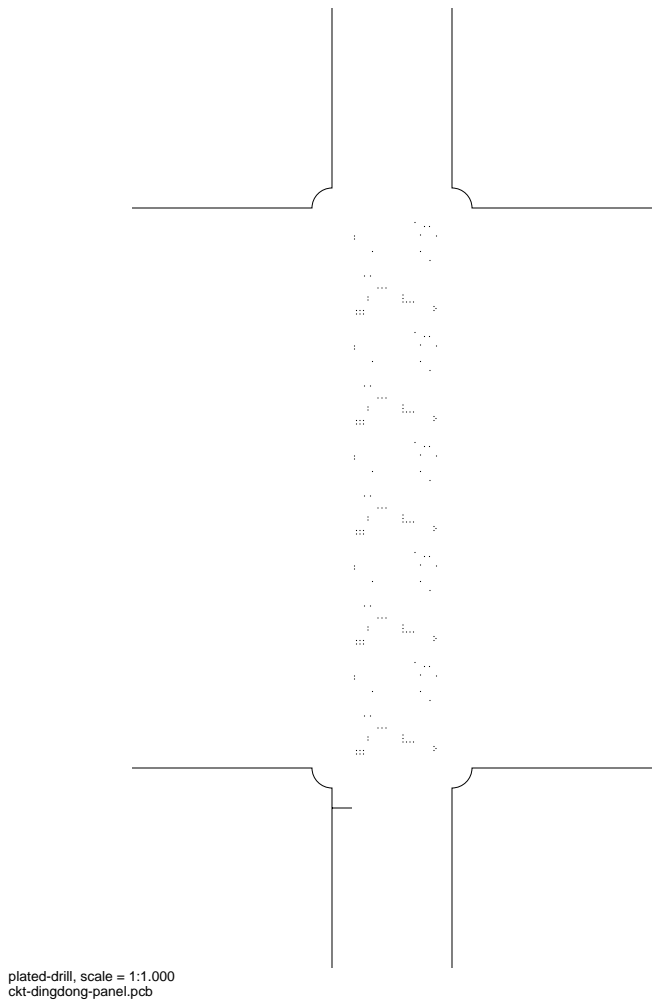
[picture p53: page 5]

plated-drill, scale = 1:1.000


unplated-drill, scale = 1:1.000

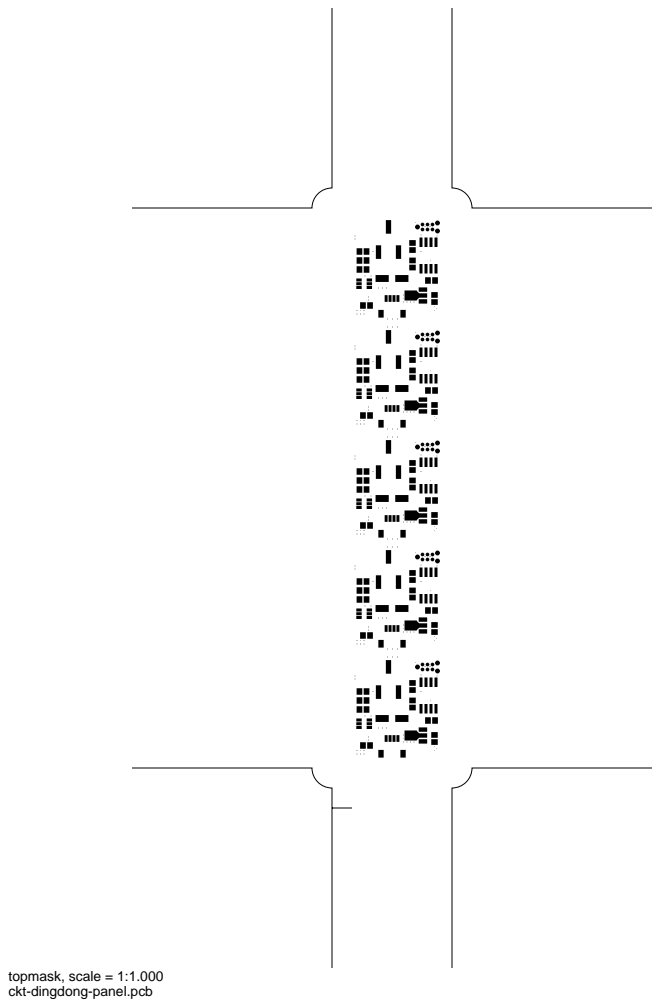
[picture p54: page 7]
topmask, scale = 1:1.000

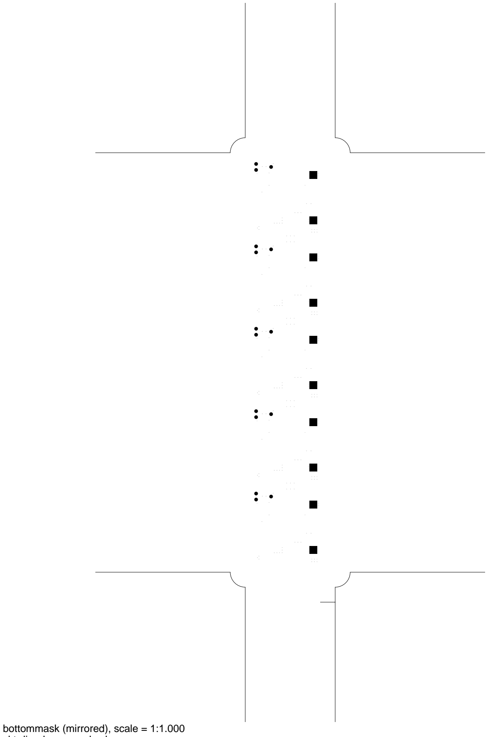
[picture p55: figure]
bottommask (mirrored), scale = 1:1.000
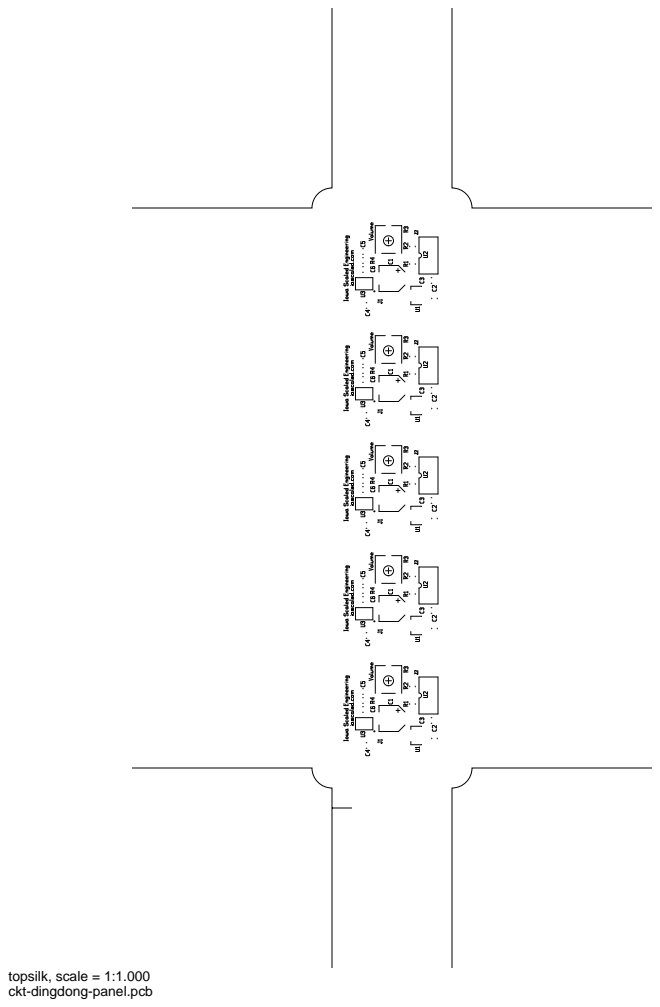
[picture p56: page 9]
topsilk, scale = 1:1.000

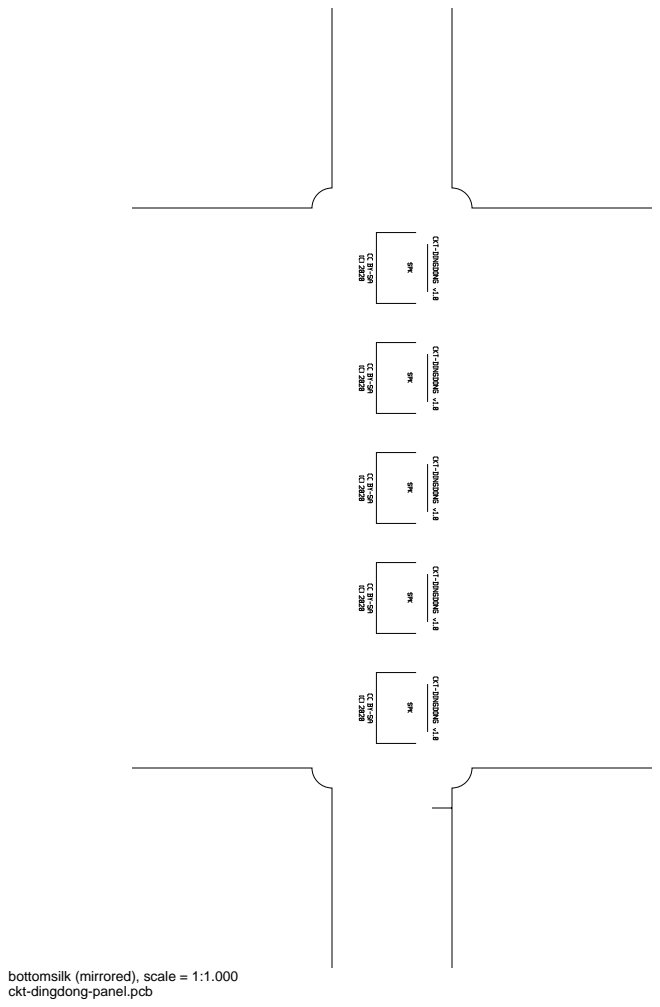
[picture p57: page 10]

bottomsilk (mirrored), scale = 1:1.000

toppaste, scale = 1:1.000 bottompaste (mirrored), scale = 1:1.000

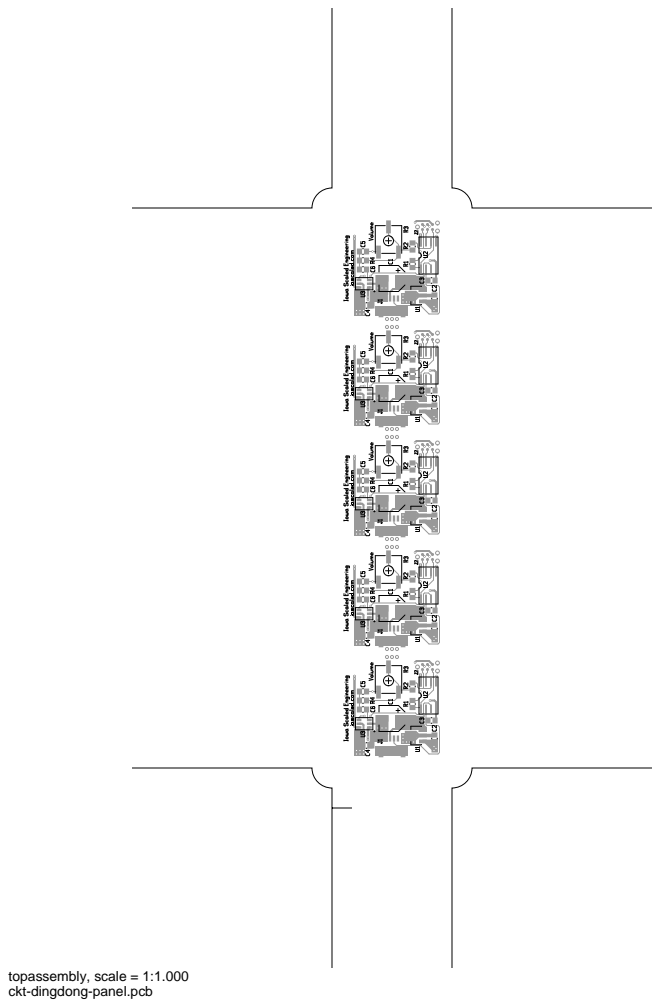
[picture p58: page 13]
topassembly, scale = 1:1.000

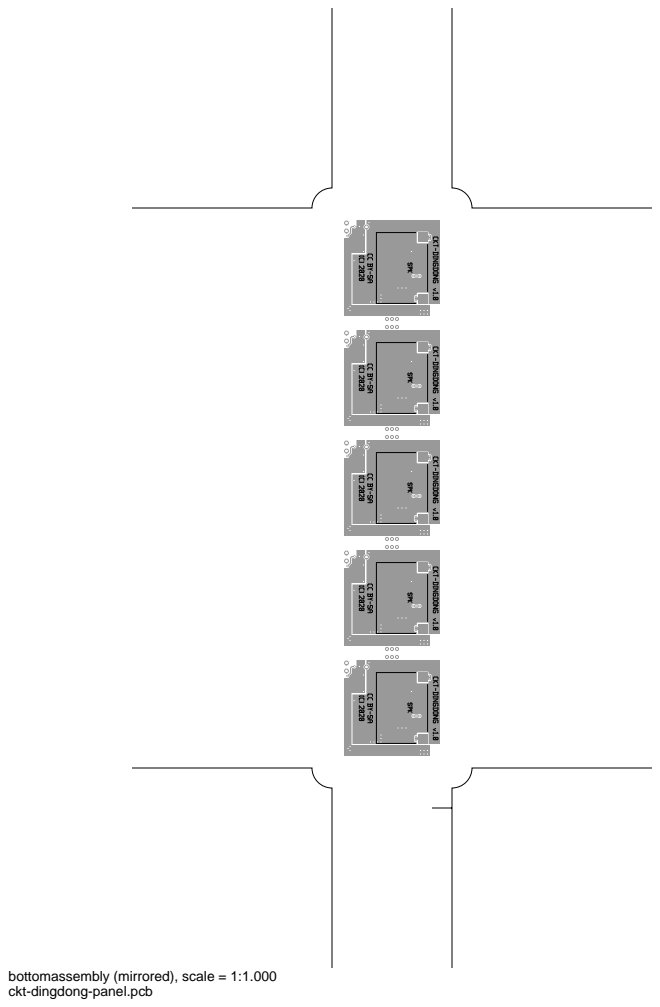
[picture p59: page 14]

bottomassembly (mirrored), scale = 1:1.000

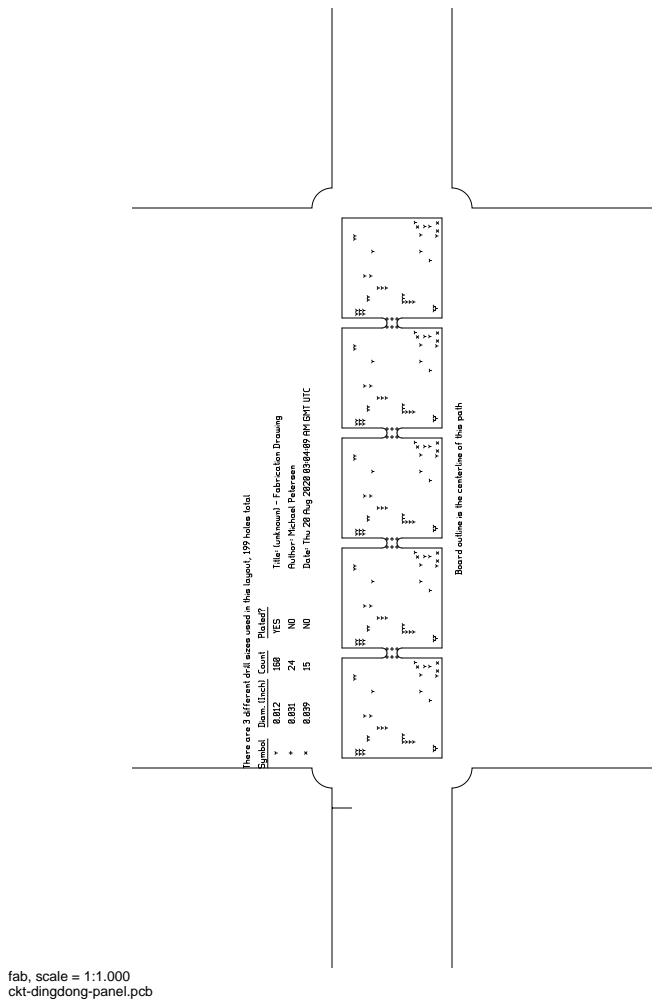
[picture p60: page 15]
fab, scale = 1:1.000
