IowaScaledEngineering/ckt-dingdong/(list of files, drawings)

Other design files:
pcb/ckt-dingdong-array.pcb
pcb/ckt-dingdong-panel.pcb
pcb/ckt-dingdong.pcb
pcb/dingdong-demo.pcb
pcb/spiflash-prog.pcb
