IowaScaledEngineering/ckt-dingdong/src/hum/hum-18k.h

#include <avr/pgmspace.h>

const uint8_t wav[] PROGMEM = {
  0x81, 0x83, 0x85, 0x88, 0x8a, 0x8c, 0x8f, 0x91, 0x93, 0x96, 0x98, 0x9b,
  0x9d, 0xa0, 0xa2, 0xa5, 0xa7, 0xaa, 0xac, 0xaf, 0xb2, 0xb4, 0xb7, 0xba,
  0xbc, 0xbf, 0xc2, 0xc4, 0xc7, 0xca, 0xcd, 0xcf, 0xd2, 0xd5, 0xd8, 0xdb,
  0xdd, 0xe0, 0xe3, 0xe6, 0xe9, 0xec, 0xef, 0xf2, 0xea, 0xe3, 0xdb, 0xd4,
  0xce, 0xc7, 0xc1, 0xbb, 0xb5, 0xaf, 0xa9, 0xa4, 0x9f, 0x9a, 0x95, 0x90,
  0x8c, 0x87, 0x83, 0x7f, 0x7b, 0x77, 0x74, 0x70, 0x6d, 0x6a, 0x67, 0x64,
  0x61, 0x5f, 0x5c, 0x5a, 0x58, 0x56, 0x53, 0x52, 0x50, 0x4e, 0x4c, 0x4b,
  0x4a, 0x48, 0x47, 0x46, 0x45, 0x44, 0x43, 0x43, 0x42, 0x41, 0x41, 0x41,
  0x40, 0x40, 0x40, 0x40, 0x40, 0x40, 0x40, 0x40, 0x40, 0x41, 0x41, 0x41,
  0x42, 0x43, 0x43, 0x44, 0x45, 0x45, 0x46, 0x47, 0x48, 0x49, 0x4a, 0x4b,
  0x4c, 0x4e, 0x4f, 0x50, 0x51, 0x53, 0x54, 0x56, 0x57, 0x59, 0x5a, 0x5c,
  0x5e, 0x5f, 0x61, 0x63, 0x65, 0x66, 0x68, 0x6a, 0x6c, 0x6e, 0x70, 0x72,
  0x74, 0x76, 0x78, 0x7a, 0x7d, 0x7f, 0x81, 0x83, 0x85, 0x88, 0x8a, 0x8c,
  0x8f, 0x91, 0x93, 0x96, 0x98, 0x9b, 0x9d, 0xa0, 0xa2, 0xa5, 0xa7, 0xaa,
  0xac, 0xaf, 0xb2, 0xb4, 0xb7, 0xba, 0xbc, 0xbf, 0xc2, 0xc4, 0xc7, 0xca,
  0xcd, 0xcf, 0xd2, 0xd5, 0xd8, 0xdb, 0xdd, 0xe0, 0xe3, 0xe6, 0xe9, 0xec,
  0xef, 0xf2, 0xea, 0xe3, 0xdb, 0xd4, 0xce, 0xc7, 0xc1, 0xbb, 0xb5, 0xaf,
  0xa9, 0xa4, 0x9f, 0x9a, 0x95, 0x90, 0x8c, 0x87, 0x83, 0x7f, 0x7b, 0x77,
  0x74, 0x70, 0x6d, 0x6a, 0x67, 0x64, 0x61, 0x5f, 0x5c, 0x5a, 0x58, 0x56,
  0x53, 0x52, 0x50, 0x4e, 0x4c, 0x4b, 0x4a, 0x48, 0x47, 0x46, 0x45, 0x44,
  0x43, 0x43, 0x42, 0x41, 0x41, 0x41, 0x40, 0x40, 0x40, 0x40, 0x40, 0x40,
  0x40, 0x40, 0x40, 0x41, 0x41, 0x41, 0x42, 0x43, 0x43, 0x44, 0x45, 0x45,
  0x46, 0x47, 0x48, 0x49, 0x4a, 0x4b, 0x4c, 0x4e, 0x4f, 0x50, 0x52, 0x53,
  0x54, 0x56, 0x57, 0x59, 0x5a, 0x5c, 0x5e, 0x5f, 0x61, 0x63, 0x65, 0x66,
  0x68, 0x6a, 0x6c, 0x6e, 0x70, 0x72, 0x74, 0x76, 0x78, 0x7a, 0x7d, 0x7f,
  0x81, 0x83, 0x85, 0x88, 0x8a, 0x8c, 0x8f, 0x91, 0x93, 0x96, 0x98, 0x9b,
  0x9d, 0xa0, 0xa2, 0xa5, 0xa7, 0xaa, 0xac, 0xaf, 0xb2, 0xb4, 0xb7, 0xba,
  0xbc, 0xbf, 0xc2, 0xc4, 0xc7, 0xca, 0xcd, 0xcf, 0xd2, 0xd5, 0xd8, 0xdb,
  0xdd, 0xe0, 0xe3, 0xe6, 0xe9, 0xec, 0xef, 0xf2, 0xea, 0xe3, 0xdb, 0xd4,
  0xce, 0xc7, 0xc1, 0xbb, 0xb5, 0xaf, 0xa9, 0xa4, 0x9f, 0x9a, 0x95, 0x90,
  0x8c, 0x87, 0x83, 0x7f, 0x7b, 0x77, 0x74, 0x70, 0x6d, 0x6a, 0x67, 0x64,
  0x61, 0x5f, 0x5c, 0x5a, 0x58, 0x56, 0x53, 0x52, 0x50, 0x4e, 0x4c, 0x4b,
  0x4a, 0x48, 0x47, 0x46, 0x45, 0x44, 0x43, 0x43, 0x42, 0x41, 0x41, 0x41,
  0x40, 0x40, 0x40, 0x40, 0x40, 0x40, 0x40, 0x40, 0x40, 0x41, 0x41, 0x41,
  0x42, 0x43, 0x43, 0x44, 0x45, 0x45, 0x46, 0x47, 0x48, 0x49, 0x4a, 0x4b,
  0x4c, 0x4e, 0x4f, 0x50, 0x52, 0x53, 0x54, 0x56, 0x57, 0x59, 0x5a, 0x5c,
  0x5e, 0x5f, 0x61, 0x63, 0x65, 0x66, 0x68, 0x6a, 0x6c, 0x6e, 0x70, 0x72,
  0x74, 0x76, 0x78, 0x7a, 0x7d, 0x7f, 0x81, 0x83, 0x85, 0x88, 0x8a, 0x8c,
  0x8f, 0x91, 0x93, 0x96, 0x98, 0x9b, 0x9d, 0xa0, 0xa2, 0xa5, 0xa7, 0xaa,
  0xac, 0xaf, 0xb2, 0xb4, 0xb7, 0xba, 0xbc, 0xbf, 0xc2, 0xc4, 0xc7, 0xca,
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
};
const uint16_t wav_len = 7500;
