IowaScaledEngineering/ckt-dingdong/src/ctcbell/end.h

#include <avr/pgmspace.h>

const uint8_t wav_end[] PROGMEM = {
  0xa0, 0x92, 0x7f, 0x7b, 0x7a, 0x80, 0x7a, 0x63, 0x67, 0x7e, 0x8b, 0x90,
  0x87, 0x80, 0x90, 0x98, 0x85, 0x72, 0x68, 0x6d, 0x80, 0x7d, 0x6f, 0x78,
  0x8a, 0x98, 0x9b, 0x85, 0x77, 0x82, 0x84, 0x79, 0x6c, 0x61, 0x72, 0x8d,
  0x8c, 0x83, 0x84, 0x8b, 0x98, 0x93, 0x75, 0x68, 0x71, 0x79, 0x7d, 0x74,
  0x6c, 0x83, 0x9a, 0x97, 0x8c, 0x7e, 0x7c, 0x8a, 0x82, 0x69, 0x63, 0x6d,
  0x80, 0x8f, 0x83, 0x7b, 0x8c, 0x98, 0x95, 0x83, 0x6b, 0x6c, 0x7e, 0x7c,
  0x70, 0x6e, 0x77, 0x92, 0x9f, 0x8c, 0x7f, 0x83, 0x88, 0x89, 0x75, 0x5e,
  0x68, 0x7f, 0x87, 0x85, 0x7c, 0x81, 0x9a, 0x9d, 0x85, 0x73, 0x6e, 0x78,
  0x83, 0x73, 0x64, 0x74, 0x8a, 0x99, 0x95, 0x7f, 0x7e, 0x90, 0x8d, 0x7a,
  0x66, 0x60, 0x77, 0x8a, 0x80, 0x77, 0x80, 0x91, 0xa0, 0x93, 0x74, 0x70,
  0x7c, 0x80, 0x78, 0x66, 0x66, 0x85, 0x99, 0x91, 0x85, 0x7f, 0x8a, 0x97,
  0x83, 0x66, 0x63, 0x71, 0x83, 0x85, 0x74, 0x76, 0x91, 0x9f, 0x97, 0x80,
  0x6e, 0x7a, 0x87, 0x79, 0x66, 0x65, 0x77, 0x94, 0x97, 0x82, 0x7e, 0x8c,
  0x95, 0x8e, 0x71, 0x5e, 0x6f, 0x82, 0x80, 0x76, 0x71, 0x84, 0xa1, 0x9d,
  0x83, 0x76, 0x79, 0x85, 0x84, 0x68, 0x5d, 0x73, 0x8b, 0x94, 0x88, 0x79,
  0x87, 0x9c, 0x93, 0x79, 0x65, 0x67, 0x7f, 0x85, 0x72, 0x6d, 0x7f, 0x98,
  0xa2, 0x8c, 0x74, 0x7b, 0x89, 0x85, 0x71, 0x5d, 0x67, 0x88, 0x93, 0x85,
  0x7c, 0x83, 0x98, 0x9e, 0x81, 0x66, 0x6a, 0x7a, 0x84, 0x78, 0x66, 0x74,
  0x95, 0xa0, 0x92, 0x7c, 0x77, 0x8a, 0x8f, 0x74, 0x5f, 0x63, 0x7c, 0x93,
  0x89, 0x76, 0x7f, 0x97, 0x9f, 0x8e, 0x6d, 0x64, 0x7b, 0x85, 0x77, 0x67,
  0x6b, 0x8a, 0xa3, 0x96, 0x7d, 0x7a, 0x88, 0x92, 0x81, 0x60, 0x5d, 0x78,
  0x8c, 0x8a, 0x79, 0x76, 0x92, 0xa5, 0x93, 0x75, 0x68, 0x75, 0x88, 0x7d,
  0x64, 0x66, 0x81, 0x9b, 0x9c, 0x82, 0x76, 0x89, 0x96, 0x87, 0x6a, 0x5a,
  0x6e, 0x8b, 0x89, 0x76, 0x74, 0x88, 0xa3, 0x9f, 0x7c, 0x69, 0x76, 0x85,
  0x82, 0x6a, 0x5d, 0x76, 0x97, 0x9a, 0x87, 0x78, 0x82, 0x9a, 0x93, 0x70,
  0x5d, 0x68, 0x82, 0x8c, 0x78, 0x6c, 0x82, 0x9e, 0xa2, 0x8a, 0x6d, 0x71,
  0x88, 0x87, 0x6e, 0x5d, 0x69, 0x8d, 0x9e, 0x8a, 0x78, 0x81, 0x96, 0x9b,
  0x7f, 0x5e, 0x62, 0x7d, 0x89, 0x7d, 0x6b, 0x75, 0x99, 0xa7, 0x90, 0x75,
  0x70, 0x83, 0x8e, 0x76, 0x5b, 0x63, 0x82, 0x99, 0x91, 0x78, 0x7a, 0x96,
  0x9f, 0x89, 0x67, 0x5e, 0x77, 0x8b, 0x7d, 0x69, 0x6e, 0x8d, 0xa7, 0x9a,
  0x79, 0x71, 0x84, 0x8f, 0x7f, 0x60, 0x59, 0x7a, 0x95, 0x90, 0x7b, 0x77,
  0x8f, 0xa5, 0x93, 0x6e, 0x60, 0x71, 0x88, 0x83, 0x68, 0x65, 0x86, 0xa2,
  0x9f, 0x82, 0x70, 0x81, 0x95, 0x86, 0x65, 0x58, 0x6e, 0x90, 0x93, 0x7a,
  0x73, 0x8a, 0xa3, 0x9d, 0x79, 0x60, 0x6f, 0x87, 0x84, 0x6c, 0x60, 0x78,
  0x9e, 0xa2, 0x87, 0x74, 0x7e, 0x95, 0x91, 0x6d, 0x56, 0x67, 0x87, 0x92,
  0x7f, 0x6e, 0x82, 0xa2, 0xa3, 0x84, 0x67, 0x6a, 0x85, 0x89, 0x6e, 0x5d,
  0x6e, 0x93, 0xa4, 0x8e, 0x75, 0x7d, 0x94, 0x97, 0x79, 0x59, 0x5f, 0x81,
  0x90, 0x80, 0x6e, 0x79, 0x9b, 0xaa, 0x8e, 0x6c, 0x6a, 0x80, 0x8c, 0x76,
  0x5a, 0x64, 0x8a, 0xa1, 0x94, 0x79, 0x78, 0x93, 0x9e, 0x83, 0x5f, 0x5a,
  0x77, 0x90, 0x83, 0x6b, 0x71, 0x93, 0xaa, 0x9a, 0x74, 0x68, 0x7f, 0x8f,
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
};
const uint16_t wav_len_end = 2432;
