IowaScaledEngineering/ckt-dingdong/src/ctcbell/start.h

#include <avr/pgmspace.h>

const uint8_t wav_start[] PROGMEM = {
  0x7b, 0x85, 0x76, 0x8c, 0x66, 0xb6, 0x4a, 0x7a, 0xd3, 0x0c, 0xb1, 0xbd,
  0x1e, 0xb1, 0xa1, 0x39, 0xb5, 0x65, 0x57, 0xc6, 0x6b, 0x53, 0xc3, 0x6f,
  0x5a, 0xc4, 0x55, 0x63, 0xb1, 0x5b, 0x80, 0xb2, 0x3b, 0x94, 0xb8, 0x3b,
  0x97, 0xa9, 0x4a, 0x92, 0x9b, 0x46, 0x84, 0x9b, 0x5b, 0x90, 0x98, 0x4a,
  0xa8, 0xa6, 0x4a, 0xa6, 0x7b, 0x4d, 0xb3, 0x7f, 0x52, 0xad, 0x75, 0x56,
  0xba, 0x6a, 0x56, 0xc0, 0x68, 0x69, 0xbe, 0x4a, 0x6c, 0xb2, 0x55, 0x7e,
  0xb6, 0x51, 0x85, 0xb1, 0x44, 0x90, 0x98, 0x3f, 0x96, 0x94, 0x48, 0xa4,
  0x9b, 0x58, 0x9f, 0x8d, 0x57, 0xa9, 0x89, 0x52, 0xa1, 0x7a, 0x5d, 0xa5,
  0x6d, 0x59, 0xaf, 0x7a, 0x72, 0xb4, 0x6c, 0x72, 0xb3, 0x5d, 0x68, 0xa6,
  0x56, 0x7c, 0xb3, 0x58, 0x80, 0xaa, 0x51, 0x8e, 0xa2, 0x43, 0x93, 0x9b,
  0x46, 0x94, 0x8f, 0x49, 0xa7, 0x92, 0x57, 0xa9, 0x85, 0x58, 0xa8, 0x75,
  0x53, 0xaa, 0x70, 0x61, 0xac, 0x6d, 0x6a, 0xb7, 0x66, 0x6f, 0xaa, 0x53,
  0x76, 0xab, 0x53, 0x81, 0xa9, 0x55, 0x8c, 0x9e, 0x52, 0x90, 0x9e, 0x57,
  0x94, 0x8e, 0x50, 0x93, 0x8e, 0x55, 0x9d, 0x90, 0x5f, 0xa8, 0x8a, 0x5b,
  0xa5, 0x82, 0x5c, 0xa8, 0x75, 0x63, 0xae, 0x74, 0x6b, 0xab, 0x69, 0x72,
  0xa8, 0x5f, 0x73, 0xa1, 0x60, 0x7c, 0xa3, 0x5b, 0x86, 0xa4, 0x60, 0x8b,
  0x95, 0x54, 0x90, 0x8e, 0x4e, 0x93, 0x85, 0x55, 0xa7, 0x87, 0x54, 0xa9,
  0x78, 0x56, 0xab, 0x69, 0x59, 0xb4, 0x68, 0x66, 0xb0, 0x5c, 0x76, 0xbb,
  0x5f, 0x7f, 0xad, 0x54, 0x87, 0xa2, 0x46, 0x89, 0xa1, 0x54, 0x9e, 0x9c,
  0x54, 0xa2, 0x99, 0x50, 0x9e, 0x80, 0x4d, 0xaf, 0x7d, 0x50, 0xb5, 0x77,
  0x61, 0xbe, 0x64, 0x5d, 0xb8, 0x5d, 0x6a, 0xb0, 0x4a, 0x77, 0xbb, 0x50,
  0x85, 0xb7, 0x4e, 0x96, 0xb1, 0x3d, 0x8c, 0xa0, 0x3f, 0xa2, 0x98, 0x3c,
  0xb4, 0x9d, 0x46, 0xba, 0x80, 0x3c, 0xc7, 0x77, 0x3f, 0xbb, 0x61, 0x4f,
  0xd0, 0x5d, 0x59, 0xcd, 0x5c, 0x6b, 0xc7, 0x3f, 0x67, 0xc3, 0x40, 0x75,
  0xb8, 0x3d, 0x92, 0xc3, 0x3b, 0x94, 0xae, 0x3b, 0xa1, 0x9a, 0x26, 0xa7,
  0x9b, 0x3f, 0xba, 0x8c, 0x3c, 0xcc, 0x8c, 0x41, 0xbb, 0x67, 0x46, 0xc8,
  0x5d, 0x45, 0xc9, 0x5d, 0x68, 0xd2, 0x4b, 0x66, 0xd0, 0x47, 0x71, 0xb9,
  0x32, 0x84, 0xc8, 0x3b, 0x8e, 0xb7, 0x3c, 0xac, 0xaf, 0x29, 0x9f, 0xa0,
  0x34, 0xb0, 0x88, 0x2f, 0xc2, 0x95, 0x46, 0xc3, 0x76, 0x4a, 0xd0, 0x67,
  0x3f, 0xbb, 0x5a, 0x5d, 0xcd, 0x4b, 0x63, 0xd2, 0x57, 0x78, 0xbe, 0x36,
  0x81, 0xc5, 0x3a, 0x84, 0xaa, 0x38, 0xaa, 0xb7, 0x32, 0xa6, 0xa7, 0x40,
  0xb6, 0x89, 0x27, 0xb8, 0x8d, 0x42, 0xbf, 0x72, 0x48, 0xdb, 0x7b, 0x4d,
  0xc6, 0x5b, 0x59, 0xcb, 0x48, 0x52, 0xc7, 0x51, 0x79, 0xc7, 0x3b, 0x7d,
  0xcb, 0x3f, 0x80, 0xab, 0x2c, 0x99, 0xb3, 0x2e, 0x98, 0xa4, 0x3e, 0xbc,
  0x9b, 0x2c, 0xb2, 0x92, 0x3c, 0xb5, 0x6d, 0x37, 0xcf, 0x82, 0x50, 0xc8,
  0x68, 0x5d, 0xda, 0x59, 0x50, 0xc0, 0x51, 0x70, 0xc8, 0x39, 0x71, 0xcd,
  0x4d, 0x8b, 0xb7, 0x34, 0x99, 0xbd, 0x2d, 0x8c, 0x9a, 0x35, 0xb6, 0xa5,
  0x31, 0xb3, 0x9b, 0x46, 0xbc, 0x73, 0x2d, 0xc1, 0x7e, 0x48, 0xbd, 0x60,
  0x57, 0xdc, 0x68, 0x58, 0xc6, 0x58, 0x6f, 0xc4, 0x3b, 0x63, 0xbf, 0x4b,
  0x87, 0xb7, 0x37, 0x96, 0xc5, 0x40, 0x8f, 0x9c, 0x34, 0xab, 0xa2, 0x2f,
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
};
const uint16_t wav_len_start = 3958;
