IowaScaledEngineering/ckt-dingdong/src/bell/safetran-mechanical-16k.h

#include <avr/pgmspace.h>

const uint8_t wav[] PROGMEM = {
  0x7e, 0x81, 0x7c, 0x80, 0x7a, 0x7e, 0x78, 0x7e, 0x78, 0x80, 0xa5, 0x7c,
  0xad, 0x4d, 0x64, 0x9b, 0x4f, 0x6f, 0x8c, 0x6f, 0x9b, 0x81, 0x6c, 0x85,
  0x52, 0x99, 0x64, 0xab, 0x85, 0x4d, 0x81, 0x71, 0x97, 0x40, 0x97, 0x7c,
  0x7c, 0xf8, 0x12, 0x9e, 0x93, 0x30, 0x8a, 0x8e, 0x8a, 0x34, 0xcb, 0x2b,
  0xb7, 0xa5, 0x15, 0xb2, 0x85, 0xb0, 0x4d, 0x6d, 0x93, 0x42, 0xbf, 0x40,
  0x52, 0xbb, 0x76, 0xa2, 0x1e, 0xea, 0x5f, 0x63, 0xcf, 0x42, 0xb0, 0x81,
  0x75, 0x6d, 0xd8, 0x61, 0x51, 0xe6, 0x4f, 0xa9, 0x99, 0x61, 0xd6, 0x46,
  0xc6, 0x6d, 0x63, 0xb9, 0x42, 0x8e, 0x9c, 0xa4, 0x64, 0xb6, 0x7f, 0x32,
  0xc9, 0x2d, 0x64, 0xc8, 0x5a, 0xb4, 0x64, 0x89, 0x7e, 0x7f, 0x54, 0x66,
  0xb2, 0x48, 0xc0, 0x7e, 0x6c, 0xae, 0x25, 0xc4, 0x93, 0x48, 0xc2, 0x5d,
  0x6f, 0x73, 0xa0, 0x52, 0xbb, 0xa0, 0x32, 0xd1, 0x4f, 0x64, 0x9c, 0x3d,
  0xa4, 0x80, 0x73, 0x93, 0x93, 0x66, 0x56, 0x6f, 0x27, 0xdd, 0x66, 0x5d,
  0xae, 0x49, 0xad, 0x66, 0x46, 0xa9, 0x71, 0x83, 0x63, 0x83, 0x6a, 0x9e,
  0x83, 0x3b, 0xe8, 0x54, 0x73, 0x95, 0x63, 0x81, 0x90, 0x76, 0x75, 0xc9,
  0x8e, 0x51, 0xa0, 0x4b, 0xa2, 0x64, 0x58, 0xb9, 0x54, 0xd6, 0x5a, 0x58,
  0xad, 0x6f, 0x6d, 0x78, 0x8c, 0x6f, 0x87, 0x93, 0x52, 0xad, 0x6a, 0x75,
  0x71, 0x78, 0x95, 0x39, 0xa7, 0x71, 0x8e, 0xa5, 0x5a, 0x95, 0x6c, 0x99,
  0x6f, 0x48, 0xc9, 0x58, 0xb7, 0x73, 0x71, 0x92, 0x81, 0x83, 0x64, 0xa7,
  0x58, 0xbf, 0x64, 0x71, 0xc6, 0x30, 0xad, 0x92, 0x64, 0xbf, 0x40, 0xa2,
  0x61, 0xa2, 0x7e, 0x52, 0xad, 0x6d, 0xab, 0x58, 0x87, 0x7c, 0x5f, 0xb6,
  0x5d, 0x78, 0x89, 0x87, 0x6c, 0x80, 0xb0, 0x0e, 0xe6, 0x6a, 0x5a, 0xc0,
  0x37, 0x9c, 0x7e, 0x78, 0x78, 0x78, 0x9c, 0x66, 0x90, 0x5f, 0x89, 0x7e,
  0x63, 0xd8, 0x34, 0xc0, 0x63, 0x63, 0xbd, 0x5a, 0x81, 0x66, 0xa7, 0x7a,
  0x78, 0x9b, 0x34, 0xb7, 0x78, 0x61, 0x9e, 0x6a, 0xa5, 0x5a, 0xb2, 0x54,
  0x83, 0x8c, 0x5b, 0xad, 0x6f, 0x7a, 0x6d, 0x6d, 0xa0, 0x5a, 0x8e, 0x7c,
  0x83, 0x90, 0x6a, 0x8e, 0x48, 0xbd, 0x52, 0x75, 0x9b, 0x5b, 0x97, 0x75,
  0x6f, 0x83, 0x68, 0x92, 0x73, 0x9c, 0x5f, 0x75, 0x8c, 0x4f, 0xc4, 0x58,
  0x7e, 0x93, 0x7e, 0x73, 0x81, 0x6d, 0x76, 0x89, 0x92, 0x6a, 0x97, 0x6a,
  0x99, 0x6c, 0x75, 0xa7, 0x36, 0xcd, 0x61, 0x75, 0x9b, 0x68, 0x76, 0x99,
  0x90, 0x76, 0x6d, 0x90, 0x63, 0x99, 0x66, 0x85, 0x81, 0x80, 0xbd, 0x30,
  0x9c, 0x85, 0x64, 0x7a, 0x9b, 0x76, 0x73, 0xb4, 0x66, 0x63, 0xb7, 0x39,
  0x9e, 0x76, 0x8c, 0x83, 0x4f, 0xb2, 0x6a, 0x95, 0x71, 0x83, 0x71, 0x99,
  0x89, 0x52, 0x92, 0x8a, 0x5f, 0xad, 0x64, 0x99, 0x66, 0x89, 0x73, 0x76,
  0xa2, 0x3d, 0xc0, 0x64, 0x9b, 0x7a, 0x51, 0xbb, 0x6c, 0x6a, 0x9c, 0x63,
  0x95, 0x7c, 0x87, 0x4f, 0xae, 0x83, 0x5f, 0xab, 0x61, 0x99, 0x4f, 0x87,
  0x93, 0x63, 0x85, 0x7c, 0x8c, 0x85, 0x80, 0x75, 0x37, 0xdb, 0x54, 0x78,
  0x9c, 0x5d, 0xa5, 0x76, 0x75, 0x63, 0x9e, 0x6d, 0x80, 0x76, 0x7c, 0xa0,
  0x5d, 0x89, 0xb0, 0x4d, 0xb2, 0x61, 0x76, 0xa0, 0x6d, 0x61, 0x7a, 0xad,
  0x6f, 0x95, 0x6a, 0x7a, 0x9b, 0x6a, 0x7c, 0x7c, 0x71, 0xb0, 0x54, 0x7c,
  0x90, 0x7e, 0x58, 0x99, 0x85, 0x68, 0xa0, 0x49, 0x8a, 0x92, 0x5d, 0x7e,
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
};
const uint16_t wav_len = 7860;

// 8MHz / 8 / 63 = 15.87kHz
#define OCR0A_DEFAULT 63
