IowaScaledEngineering/ckt-dingdong/src/bell/uss-teardrop-20k.h

#include <avr/pgmspace.h>

const uint8_t wav[] PROGMEM = {
  0x80, 0x7d, 0x80, 0x7d, 0x7f, 0x7d, 0x7f, 0x7d, 0x7f, 0x80, 0x7d, 0x80,
  0x7d, 0x7f, 0x7d, 0x7f, 0x7d, 0x80, 0x7d, 0x80, 0x7d, 0x80, 0x7d, 0x80,
  0x7d, 0x80, 0x7d, 0x80, 0x7d, 0x80, 0x7d, 0x7d, 0x80, 0x7d, 0x7d, 0x79,
  0x7d, 0x73, 0x7d, 0x6d, 0xba, 0x61, 0x2c, 0xeb, 0x90, 0x08, 0xa8, 0xd3,
  0x8c, 0x49, 0x5d, 0x96, 0x2a, 0xb6, 0x9a, 0x5b, 0xb8, 0x98, 0xb8, 0xa8,
  0x8c, 0x5f, 0x12, 0x63, 0x5f, 0x32, 0x80, 0xac, 0x61, 0x3e, 0xe3, 0xa8,
  0x53, 0x71, 0xd1, 0x69, 0x69, 0xef, 0xc9, 0xb4, 0x6f, 0xa4, 0x5d, 0x7b,
  0x9a, 0x5b, 0x75, 0x71, 0xae, 0xac, 0xac, 0x79, 0x02, 0x98, 0xb0, 0x0a,
  0x32, 0x9e, 0x98, 0x34, 0xae, 0xe1, 0x69, 0x30, 0x75, 0x73, 0x49, 0xbe,
  0xb2, 0x7d, 0x6f, 0xb0, 0xa0, 0x4b, 0x53, 0x5d, 0x2e, 0x36, 0xaa, 0x9c,
  0x6b, 0x8a, 0x7d, 0x79, 0x5b, 0x4b, 0x8a, 0x63, 0x63, 0x75, 0x90, 0xc1,
  0xae, 0x6d, 0x6b, 0xae, 0x57, 0x59, 0xbc, 0xa4, 0x36, 0x4b, 0xff, 0xb2,
  0x22, 0x5d, 0x98, 0x53, 0x4d, 0xb0, 0x69, 0x73, 0xbe, 0x9a, 0x65, 0x7f,
  0x84, 0x43, 0x75, 0x8e, 0x88, 0x88, 0x9c, 0xb6, 0x63, 0x5b, 0xc5, 0xaa,
  0x4b, 0x5d, 0x79, 0x67, 0x9a, 0xdb, 0xa8, 0x43, 0x8e, 0xb2, 0x5f, 0x67,
  0x86, 0xa6, 0x5b, 0x92, 0xb2, 0x5d, 0x9a, 0xac, 0x61, 0x2a, 0xa2, 0xa4,
  0xaa, 0x8c, 0x59, 0xb2, 0xa2, 0x96, 0x6f, 0x67, 0x3e, 0x88, 0x90, 0x5d,
  0xa8, 0x86, 0x86, 0x9a, 0x6f, 0x49, 0x67, 0x82, 0x5f, 0x49, 0x86, 0x8c,
  0x82, 0x88, 0x5d, 0x55, 0x63, 0xba, 0x69, 0x32, 0x86, 0x8c, 0x82, 0x98,
  0x88, 0x5b, 0x90, 0x4d, 0x63, 0x67, 0x5b, 0xb0, 0x9a, 0x6d, 0x79, 0xcf,
  0x6d, 0x77, 0x88, 0x32, 0x6b, 0xac, 0xac, 0x65, 0x8c, 0x8a, 0x9a, 0xb4,
  0x73, 0x6b, 0x92, 0xa4, 0x84, 0x77, 0x90, 0xbc, 0x98, 0x43, 0x61, 0x80,
  0x82, 0xa0, 0x8c, 0x67, 0x6f, 0xdd, 0xdb, 0x4d, 0x51, 0x8c, 0x6f, 0x61,
  0x80, 0x80, 0x6d, 0x9c, 0x9a, 0x6b, 0x6d, 0x79, 0x86, 0x59, 0x6d, 0x6d,
  0x69, 0x96, 0xa2, 0x73, 0x20, 0x6d, 0xb6, 0x4d, 0x43, 0x9c, 0x57, 0x9a,
  0xeb, 0x73, 0x5b, 0x9a, 0x96, 0x6b, 0x5b, 0x5d, 0x88, 0x8c, 0x84, 0x8c,
  0x6f, 0x86, 0xbc, 0x84, 0x4f, 0x71, 0x8a, 0x98, 0x80, 0x57, 0x5f, 0xa4,
  0xc7, 0x77, 0x49, 0x75, 0x98, 0x86, 0x6b, 0xae, 0xb6, 0x65, 0xa6, 0xb4,
  0x24, 0x5f, 0xa6, 0x63, 0x49, 0x49, 0x92, 0xa8, 0x9a, 0x8a, 0x71, 0x67,
  0x92, 0x96, 0x4f, 0x61, 0x79, 0x65, 0x7d, 0xa2, 0x67, 0x88, 0x8e, 0x6d,
  0x63, 0x73, 0xbe, 0x96, 0x75, 0x7d, 0x9c, 0x73, 0x65, 0x86, 0x38, 0x3e,
  0xa6, 0x8e, 0x6d, 0xa6, 0x86, 0x90, 0xcb, 0x86, 0x65, 0x84, 0x59, 0x6d,
  0xa2, 0x8e, 0x88, 0x94, 0x73, 0x5f, 0x7d, 0x71, 0x86, 0x98, 0x57, 0x73,
  0xb4, 0xa6, 0x88, 0x65, 0x47, 0x45, 0x63, 0x86, 0x77, 0x51, 0x96, 0xe3,
  0x9a, 0x77, 0x9a, 0x7f, 0x61, 0x5f, 0x5b, 0x73, 0x88, 0x8e, 0x90, 0x65,
  0x67, 0x96, 0x86, 0x65, 0x61, 0x5f, 0x9c, 0xe3, 0x73, 0x53, 0xae, 0x88,
  0x55, 0x65, 0x75, 0x53, 0x9a, 0xaa, 0x7b, 0xbc, 0xae, 0xa8, 0xa0, 0x59,
  0x3c, 0x7d, 0x8e, 0x6d, 0x86, 0x59, 0x7b, 0xaa, 0x88, 0x61, 0x57, 0x7b,
  0x7d, 0x92, 0x7d, 0x8e, 0x92, 0x84, 0x7d, 0x5d, 0x6b, 0x71, 0x63, 0x63,
  0x92, 0x7d, 0xa2, 0xd3, 0xa2, 0x4d, 0x55, 0x98, 0x86, 0x4b, 0x22, 0x90,
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
};
const uint16_t wav_len = 7524;

// 8MHz / 8 / 50 = 20kHz
#define OCR0A_DEFAULT 50
