IowaScaledEngineering/ckt-dingdong/src/bell/wchayes-333-25k.h

#include <avr/pgmspace.h>

const uint8_t wav[] PROGMEM = {
  0x7e, 0x7e, 0x81, 0x80, 0x7d, 0x7e, 0x7f, 0x80, 0x7e, 0x80, 0x7f, 0x7d,
  0x7c, 0x7f, 0x81, 0x81, 0x7e, 0x7c, 0x7c, 0x7e, 0x80, 0x7f, 0x7e, 0x7e,
  0x80, 0x81, 0x7e, 0x7c, 0x7d, 0x7f, 0x7e, 0x7e, 0x80, 0x7f, 0x80, 0x7e,
  0x7d, 0x7e, 0x82, 0x83, 0x7f, 0x7a, 0x7d, 0x81, 0x83, 0x87, 0x85, 0x81,
  0x80, 0x7f, 0x73, 0x74, 0x97, 0x9c, 0x70, 0x5e, 0x75, 0x94, 0x9d, 0x8b,
  0x70, 0x67, 0x83, 0x90, 0x86, 0x94, 0x94, 0x8c, 0x8b, 0x6f, 0x60, 0x74,
  0x8a, 0x94, 0x7d, 0x70, 0x7e, 0x8c, 0x8c, 0x7c, 0x70, 0x68, 0x63, 0x71,
  0x80, 0x86, 0x87, 0x89, 0x92, 0x95, 0x8e, 0x7f, 0x6a, 0x63, 0x73, 0x75,
  0x7e, 0x94, 0x90, 0x83, 0x79, 0x68, 0x64, 0x75, 0x8a, 0x87, 0x74, 0x78,
  0x8b, 0x7a, 0x6d, 0x81, 0x80, 0x6c, 0x6c, 0x75, 0x79, 0x85, 0x8e, 0x8f,
  0x8e, 0x86, 0x76, 0x7e, 0x8a, 0x85, 0x86, 0x86, 0x86, 0x86, 0x7d, 0x76,
  0x6d, 0x6d, 0x7e, 0x90, 0x9f, 0x97, 0x8a, 0x8a, 0x74, 0x66, 0x78, 0x80,
  0x8f, 0x9f, 0x7e, 0x6b, 0x85, 0x8e, 0x80, 0x6f, 0x70, 0x8b, 0x81, 0x6d,
  0x82, 0x82, 0x75, 0x7a, 0x81, 0x7d, 0x6c, 0x76, 0x9b, 0x98, 0x89, 0x7e,
  0x6d, 0x7d, 0x83, 0x5d, 0x41, 0x51, 0x82, 0xa0, 0x98, 0x87, 0x86, 0x8e,
  0x85, 0x6a, 0x56, 0x52, 0x6b, 0x95, 0xa8, 0xb2, 0x99, 0x71, 0x5f, 0x50,
  0x52, 0x63, 0x8a, 0x9b, 0x80, 0x78, 0x6f, 0x60, 0x81, 0x99, 0x98, 0x97,
  0x8a, 0x81, 0x7c, 0x89, 0x89, 0x76, 0x80, 0x8b, 0x9c, 0x94, 0x6a, 0x5f,
  0x75, 0x7c, 0x86, 0x93, 0x94, 0x80, 0x70, 0x95, 0x9d, 0x75, 0x82, 0xa8,
  0xab, 0x8b, 0x5f, 0x51, 0x59, 0x80, 0xa2, 0x82, 0x8f, 0xa8, 0x66, 0x44,
  0x62, 0x89, 0x86, 0x70, 0x76, 0x74, 0x6d, 0x76, 0x80, 0x9c, 0x9c, 0x74,
  0x75, 0x94, 0x97, 0x60, 0x68, 0x94, 0x86, 0x82, 0x74, 0x73, 0x7c, 0x6d,
  0x83, 0x8b, 0x74, 0x8f, 0xa6, 0x7c, 0x5f, 0x68, 0x8e, 0x9b, 0x92, 0x8b,
  0x7e, 0x9f, 0xa1, 0x66, 0x5f, 0x85, 0x87, 0x86, 0x97, 0x99, 0x6b, 0x3f,
  0x68, 0x6d, 0x78, 0xb8, 0x8e, 0x66, 0x89, 0x78, 0x73, 0xaa, 0x87, 0x56,
  0x5e, 0x6b, 0xa0, 0xa8, 0x82, 0x3b, 0x81, 0xc1, 0x3c, 0x4c, 0xa1, 0x92,
  0x4a, 0x2f, 0x73, 0x64, 0x60, 0xc5, 0x95, 0x45, 0x67, 0xb2, 0xfc, 0x7c,
  0x3a, 0xc4, 0xd2, 0x6a, 0x38, 0x75, 0x57, 0x44, 0xaa, 0xd4, 0xaa, 0x21,
  0x15, 0xd5, 0xf4, 0x64, 0x50, 0xa5, 0x85, 0x3f, 0x82, 0xce, 0x64, 0x3f,
  0xb3, 0xd0, 0x73, 0x29, 0xa9, 0xfd, 0x94, 0x0e, 0x29, 0xbb, 0xcd, 0x6b,
  0x16, 0x6a, 0xb7, 0x78, 0x6a, 0xa1, 0x4e, 0x1d, 0xa8, 0xd6, 0x89, 0x0f,
  0x25, 0x8b, 0x7d, 0x7e, 0xbe, 0x7c, 0x03, 0x3c, 0xb5, 0xb5, 0x50, 0x5e,
  0x8e, 0x74, 0x56, 0x60, 0x9b, 0xaa, 0x5a, 0x37, 0x8c, 0x93, 0x7e, 0x7d,
  0x66, 0x52, 0x37, 0x6d, 0xd5, 0xc7, 0x51, 0x49, 0x9c, 0xae, 0x81, 0x86,
  0x8e, 0x5a, 0x3e, 0x9f, 0xff, 0x9c, 0x59, 0x78, 0xa9, 0xaf, 0x87, 0x97,
  0x86, 0x5a, 0x5b, 0x89, 0x9f, 0x87, 0x83, 0x79, 0x6a, 0x73, 0x8c, 0xbb,
  0xad, 0x45, 0x32, 0xa0, 0xcc, 0x86, 0x86, 0xbc, 0x62, 0x49, 0xb7, 0xbe,
  0xa1, 0x68, 0x51, 0xa1, 0xb5, 0x71, 0x83, 0xaf, 0x60, 0x57, 0x80, 0x90,
  0xa5, 0x8e, 0x71, 0x90, 0xa1, 0x54, 0x57, 0xae, 0x86, 0x2a, 0x90, 0xd6,
  0x7c, 0x4a, 0x5f, 0x89, 0x86, 0x8f, 0xa5, 0xaa, 0x5b, 0x3b, 0x9d, 0xa2,
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
};
const uint16_t wav_len = 7860;

// 8MHz / 8 / 50 = 25kHz
#define OCR0A_DEFAULT 40
