IowaScaledEngineering/ckt-dingdong/src/bell/wchayes-777-21k.h

#include <avr/pgmspace.h>

const uint8_t wav[] PROGMEM = {
  0x80, 0x80, 0x81, 0x82, 0x82, 0x82, 0x82, 0x85, 0x89, 0x8b, 0x8a, 0x87,
  0x80, 0x75, 0x69, 0x60, 0x5b, 0x5f, 0x72, 0x8c, 0xa0, 0xaa, 0xab, 0xa1,
  0x8f, 0x7d, 0x69, 0x53, 0x45, 0x4a, 0x65, 0x88, 0xa8, 0xbf, 0xc6, 0xbb,
  0xa2, 0x80, 0x5b, 0x3d, 0x35, 0x4a, 0x6d, 0x8e, 0xa3, 0xa3, 0x8d, 0x72,
  0x65, 0x67, 0x77, 0x94, 0xb2, 0xc4, 0xc3, 0xa8, 0x75, 0x40, 0x25, 0x2c,
  0x48, 0x6e, 0x90, 0xa7, 0xb5, 0xbb, 0xb4, 0x9b, 0x74, 0x50, 0x3d, 0x3f,
  0x52, 0x73, 0x9a, 0xb7, 0xc4, 0xc6, 0xb7, 0x93, 0x6c, 0x56, 0x51, 0x56,
  0x65, 0x74, 0x79, 0x7b, 0x7f, 0x7a, 0x6b, 0x61, 0x68, 0x81, 0xa6, 0xc5,
  0xce, 0xbe, 0x9f, 0x7c, 0x5e, 0x4b, 0x44, 0x48, 0x54, 0x66, 0x7f, 0x9a,
  0xad, 0xb0, 0xa9, 0x9b, 0x83, 0x68, 0x55, 0x4c, 0x4f, 0x68, 0x8d, 0xa9,
  0xb4, 0xb6, 0xb0, 0x9a, 0x7a, 0x5f, 0x4e, 0x4c, 0x5c, 0x75, 0x84, 0x84,
  0x7b, 0x74, 0x73, 0x7a, 0x8a, 0x99, 0xa1, 0xa6, 0xac, 0xad, 0xa2, 0x8a,
  0x6a, 0x4d, 0x3e, 0x41, 0x4c, 0x59, 0x6c, 0x8b, 0xad, 0xc0, 0xbe, 0xad,
  0x8d, 0x6a, 0x52, 0x48, 0x4a, 0x5c, 0x83, 0xb1, 0xd0, 0xd5, 0xc2, 0x99,
  0x66, 0x40, 0x35, 0x40, 0x55, 0x6f, 0x87, 0x95, 0x91, 0x81, 0x72, 0x69,
  0x6c, 0x82, 0xa1, 0xb9, 0xc6, 0xc9, 0xbc, 0x9b, 0x6b, 0x3a, 0x18, 0x15,
  0x33, 0x62, 0x92, 0xbc, 0xd2, 0xcd, 0xb3, 0x8d, 0x5f, 0x39, 0x2e, 0x43,
  0x6f, 0xa0, 0xc6, 0xd0, 0xbe, 0x9d, 0x81, 0x6e, 0x62, 0x5c, 0x63, 0x73,
  0x7d, 0x7b, 0x72, 0x64, 0x57, 0x59, 0x6c, 0x82, 0x97, 0xae, 0xc1, 0xc3,
  0xb6, 0xa1, 0x85, 0x6a, 0x59, 0x53, 0x4f, 0x4e, 0x54, 0x62, 0x7a, 0x9b,
  0xb8, 0xbf, 0xac, 0x8f, 0x73, 0x5b, 0x4a, 0x48, 0x57, 0x72, 0x96, 0xb6,
  0xc4, 0xbc, 0xaa, 0x95, 0x7d, 0x62, 0x4d, 0x46, 0x4c, 0x5e, 0x76, 0x8a,
  0x8d, 0x81, 0x74, 0x6d, 0x72, 0x87, 0xa2, 0xba, 0xcb, 0xd3, 0xc5, 0x9c,
  0x62, 0x28, 0x05, 0x03, 0x27, 0x65, 0xa2, 0xd3, 0xec, 0xe2, 0xb1, 0x70,
  0x39, 0x21, 0x2f, 0x5c, 0x96, 0xc3, 0xd3, 0xca, 0xb0, 0x87, 0x5d, 0x47,
  0x47, 0x59, 0x79, 0x9b, 0xa8, 0x94, 0x73, 0x57, 0x47, 0x47, 0x57, 0x71,
  0x90, 0xb6, 0xd9, 0xe8, 0xda, 0xb3, 0x7f, 0x4d, 0x29, 0x1d, 0x2b, 0x4a,
  0x72, 0x9b, 0xb6, 0xb7, 0xa4, 0x8b, 0x74, 0x69, 0x6f, 0x7d, 0x82, 0x80,
  0x84, 0x8c, 0x8f, 0x8b, 0x87, 0x84, 0x86, 0x8e, 0x90, 0x81, 0x68, 0x56,
  0x55, 0x63, 0x74, 0x81, 0x83, 0x7d, 0x77, 0x77, 0x7b, 0x88, 0xa2, 0xc0,
  0xd4, 0xd2, 0xb4, 0x7e, 0x41, 0x1b, 0x18, 0x2f, 0x54, 0x7e, 0xa0, 0xb4,
  0xb9, 0xb0, 0x96, 0x71, 0x57, 0x58, 0x6a, 0x7f, 0x92, 0xa1, 0xa6, 0xa2,
  0x9b, 0x8e, 0x76, 0x61, 0x5b, 0x61, 0x6f, 0x7f, 0x8a, 0x8b, 0x84, 0x77,
  0x64, 0x50, 0x48, 0x59, 0x81, 0xb5, 0xe1, 0xf2, 0xe0, 0xb2, 0x7d, 0x50,
  0x2c, 0x1a, 0x23, 0x42, 0x6d, 0x9a, 0xb7, 0xb3, 0x99, 0x83, 0x7c, 0x7b,
  0x7c, 0x7e, 0x80, 0x82, 0x89, 0x94, 0x98, 0x92, 0x88, 0x81, 0x78, 0x6a,
  0x60, 0x62, 0x6e, 0x81, 0x94, 0x9a, 0x85, 0x61, 0x48, 0x44, 0x55, 0x79,
  0xa3, 0xc6, 0xdf, 0xe5, 0xd0, 0xa0, 0x67, 0x3a, 0x26, 0x2b, 0x45, 0x67,
  0x80, 0x8d, 0x96, 0x98, 0x8f, 0x83, 0x7c, 0x7b, 0x7d, 0x83, 0x8c, 0x90,
  0x8e, 0x92, 0x9c, 0x9d, 0x91, 0x7a, 0x61, 0x52, 0x59, 0x71, 0x89, 0x93,
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
};
const uint16_t wav_len = 7526;

// 8MHz / 8 / 48 = 21kHz
#define OCR0A_DEFAULT 48
