IowaScaledEngineering/ckt-dingdong/src/bell/wrs-222-26k.h

#include <avr/pgmspace.h>

const uint8_t wav[] PROGMEM = {
  0x80, 0x7e, 0x7f, 0x7c, 0x80, 0x7d, 0x7f, 0x7e, 0x7e, 0x7e, 0x7e, 0x7e,
  0x7d, 0x80, 0x7c, 0x80, 0x7c, 0x7f, 0x7d, 0x7f, 0x7d, 0x80, 0x7c, 0x80,
  0x7c, 0x80, 0x7d, 0x80, 0x7c, 0x80, 0x7c, 0x80, 0x7c, 0x80, 0x7c, 0x7e,
  0x7e, 0x7e, 0x7e, 0x7e, 0x7f, 0x7d, 0x7f, 0x7c, 0x7f, 0x7b, 0x7e, 0x7a,
  0x80, 0x76, 0x7e, 0x76, 0x8e, 0x98, 0x32, 0x84, 0x9d, 0x95, 0xe8, 0x29,
  0x4b, 0xfa, 0x5b, 0x35, 0x79, 0x38, 0x7b, 0xdd, 0x79, 0x78, 0x7b, 0x19,
  0x64, 0xe9, 0x88, 0x33, 0x8f, 0x70, 0x6d, 0x7b, 0x8f, 0xfe, 0x85, 0x32,
  0x67, 0xa4, 0xf3, 0x9f, 0x65, 0xcd, 0xad, 0x14, 0x3f, 0x70, 0x8d, 0xc2,
  0xc4, 0x90, 0x3d, 0x29, 0x50, 0xe8, 0xca, 0x11, 0x70, 0xcb, 0x7e, 0x24,
  0x25, 0xc3, 0xd4, 0x4f, 0x2b, 0x63, 0x77, 0x61, 0x7a, 0xc4, 0xa7, 0x54,
  0x5b, 0x7f, 0x68, 0x43, 0x95, 0xcb, 0x97, 0x5f, 0x45, 0x78, 0x87, 0x31,
  0x48, 0xb6, 0xd2, 0x6f, 0x0e, 0x7a, 0xd7, 0x8f, 0x69, 0x74, 0x54, 0x59,
  0x62, 0xa3, 0xd1, 0x78, 0x2d, 0x77, 0x83, 0x42, 0x85, 0xcf, 0xaf, 0x6c,
  0x4f, 0x6e, 0x9d, 0x67, 0x4e, 0x8a, 0xa3, 0x98, 0x68, 0x40, 0x8e, 0xa7,
  0x68, 0x76, 0x94, 0x96, 0x79, 0x5a, 0x57, 0x93, 0xa7, 0x8b, 0x86, 0x75,
  0x34, 0x69, 0xac, 0x77, 0x65, 0x87, 0xa6, 0xa6, 0x65, 0x3e, 0x84, 0xac,
  0x65, 0x4d, 0xab, 0xb1, 0x71, 0x65, 0x81, 0x8f, 0x78, 0x55, 0x97, 0xc4,
  0x81, 0x47, 0x50, 0x8f, 0x90, 0x85, 0x9f, 0x99, 0x66, 0x60, 0x86, 0x9a,
  0x83, 0x66, 0x5e, 0xa3, 0xc9, 0x5d, 0x44, 0x99, 0x96, 0x79, 0x8d, 0x7d,
  0x79, 0x72, 0x70, 0x86, 0x8e, 0x6c, 0x7d, 0xb3, 0x6f, 0x50, 0xaa, 0xa9,
  0x6c, 0x63, 0x7e, 0x93, 0x66, 0x44, 0x8f, 0xcc, 0xaf, 0x70, 0x3f, 0x5e,
  0xa3, 0xa7, 0x7a, 0x7d, 0x8f, 0x75, 0x63, 0x5a, 0x90, 0xad, 0x6c, 0x6f,
  0x9e, 0x7e, 0x5d, 0x65, 0x80, 0x97, 0x95, 0x8e, 0x75, 0x51, 0x68, 0x81,
  0x6f, 0x83, 0xa0, 0x8f, 0x6a, 0x5b, 0x5f, 0x9a, 0xb5, 0x70, 0x7a, 0x92,
  0x68, 0x6b, 0x71, 0x6d, 0x89, 0x98, 0x78, 0x56, 0x76, 0x87, 0x64, 0x75,
  0xa6, 0x9b, 0x84, 0x70, 0x45, 0x5a, 0xa0, 0x9f, 0x7b, 0x88, 0x66, 0x5f,
  0xad, 0x80, 0x5b, 0x89, 0x8c, 0x84, 0x90, 0x75, 0x73, 0x91, 0x89, 0x7e,
  0x7a, 0x57, 0x5b, 0x7c, 0x8e, 0x95, 0x9a, 0x88, 0x72, 0x56, 0x5a, 0xb7,
  0xac, 0x77, 0x81, 0x6f, 0x68, 0x7a, 0x6f, 0x88, 0xb4, 0x8c, 0x64, 0x69,
  0x68, 0x9b, 0xbf, 0x7c, 0x52, 0x6d, 0x7d, 0x87, 0x94, 0x67, 0x69, 0x7f,
  0x87, 0x90, 0x76, 0x74, 0x8b, 0x6b, 0x6e, 0xa6, 0xa6, 0x7e, 0x54, 0x5b,
  0x91, 0x9c, 0x76, 0x69, 0x62, 0x72, 0x90, 0xb7, 0x8e, 0x59, 0x76, 0x87,
  0x77, 0x6a, 0x96, 0x8d, 0x57, 0x55, 0x6c, 0x8a, 0xa9, 0x84, 0x70, 0x80,
  0x6c, 0x7a, 0x92, 0x6f, 0x80, 0x9c, 0x7e, 0x70, 0x69, 0x7c, 0x80, 0x87,
  0x7d, 0x7d, 0x7f, 0x77, 0x91, 0x88, 0x6f, 0x88, 0x6c, 0x64, 0x9d, 0x92,
  0x81, 0x76, 0x4e, 0x6f, 0x96, 0x77, 0x8b, 0x83, 0x69, 0x7c, 0xb4, 0x99,
  0x6f, 0x83, 0x6e, 0x7c, 0x91, 0x74, 0x7e, 0x7b, 0x64, 0x89, 0x95, 0xa4,
  0x87, 0x61, 0x5c, 0x5f, 0x75, 0xb1, 0xa6, 0x83, 0x75, 0x79, 0x75, 0x60,
  0x7a, 0x7b, 0x9c, 0xa4, 0x75, 0x7d, 0x80, 0x6e, 0x84, 0x77, 0x80, 0x95,
  0x96, 0x91, 0x6c, 0x6e, 0x80, 0x57, 0x5a, 0x95, 0xa1, 0x9a, 0x60, 0x68,
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
};
const uint16_t wav_len = 7863;

// 8MHz / 8 / 38 = 26kHz
#define OCR0A_DEFAULT 38
