IowaScaledEngineering/ckt-dingdong/src/bell/bell-26k.h

#include <avr/pgmspace.h>

const uint8_t wav[] PROGMEM = {
  0x80, 0x7f, 0x80, 0x80, 0x81, 0x7e, 0x7b, 0x7e, 0x88, 0x89, 0x7b, 0x78,
  0x84, 0x86, 0x73, 0x71, 0x80, 0x8e, 0x86, 0x76, 0x6d, 0x7a, 0x8d, 0x84,
  0x6b, 0x6c, 0xa3, 0xa4, 0x7c, 0x79, 0x7b, 0x82, 0x8f, 0x97, 0x8b, 0x7b,
  0x92, 0x92, 0x51, 0x45, 0x89, 0x89, 0x67, 0x71, 0x85, 0x83, 0x9d, 0x99,
  0x6b, 0x60, 0x75, 0xa4, 0x9d, 0x86, 0x86, 0x72, 0x60, 0x83, 0x85, 0x82,
  0x9b, 0xab, 0x98, 0x73, 0x8b, 0xa0, 0x6b, 0x3c, 0x58, 0x71, 0x9c, 0xca,
  0xa8, 0x5b, 0x5d, 0x85, 0x74, 0x66, 0x6d, 0x7e, 0x8b, 0x96, 0x9c, 0x6f,
  0x6b, 0x79, 0x53, 0x25, 0x6e, 0xcb, 0xba, 0x79, 0x69, 0xa4, 0xa0, 0x8e,
  0x8d, 0x70, 0x4f, 0x8b, 0xb8, 0x75, 0x40, 0x73, 0xb3, 0x9b, 0x79, 0x8b,
  0xa8, 0xac, 0x82, 0x3d, 0x42, 0x7b, 0x95, 0x6c, 0x52, 0x99, 0xc8, 0x83,
  0x5b, 0x7c, 0x92, 0x78, 0x6a, 0x72, 0x84, 0xb1, 0xb0, 0x71, 0x25, 0x39,
  0xaa, 0xee, 0xa9, 0x47, 0x31, 0x7d, 0xb8, 0x97, 0x71, 0x6a, 0x75, 0x8c,
  0xaf, 0xa6, 0x80, 0x32, 0x1a, 0x63, 0x82, 0x85, 0xbd, 0xcc, 0x7d, 0x71,
  0x98, 0xa3, 0x5d, 0x22, 0x56, 0x89, 0xc0, 0xc7, 0x75, 0x3f, 0x88, 0x96,
  0x5a, 0x67, 0x83, 0x95, 0x7d, 0x70, 0x58, 0x53, 0x88, 0xe0, 0xb4, 0x21,
  0x3b, 0xc0, 0xc8, 0x70, 0x63, 0x76, 0x76, 0x5d, 0xaa, 0xed, 0xab, 0x90,
  0x5a, 0x14, 0x41, 0xa0, 0x6e, 0x49, 0x7d, 0xa3, 0xbc, 0xc0, 0xa4, 0x46,
  0x30, 0x5b, 0x70, 0x70, 0xb4, 0xbe, 0x5c, 0x3d, 0x76, 0xa3, 0xa6, 0x8e,
  0x65, 0x79, 0x91, 0xa4, 0x83, 0x52, 0x5e, 0x88, 0xa3, 0xb0, 0xc7, 0x73,
  0x15, 0x4f, 0x9d, 0x88, 0x6e, 0xaa, 0xb2, 0x83, 0x99, 0xac, 0x63, 0x4c,
  0x7a, 0x4c, 0x0e, 0x56, 0xe0, 0xda, 0x92, 0x6b, 0x71, 0x95, 0x9e, 0x96,
  0x77, 0x62, 0x78, 0x97, 0x82, 0x6f, 0x80, 0x68, 0x5b, 0x92, 0xcf, 0xac,
  0x74, 0x55, 0x51, 0x5a, 0x83, 0xaf, 0x80, 0x90, 0xbc, 0xa3, 0x50, 0x3d,
  0x63, 0x7b, 0x81, 0x69, 0x89, 0xe4, 0xf5, 0x93, 0x41, 0x1b, 0x52, 0x7b,
  0x87, 0x9d, 0x6a, 0x4c, 0x7e, 0xc7, 0xba, 0x7b, 0x6d, 0x8f, 0x77, 0x5a,
  0x86, 0x94, 0x68, 0x65, 0x8c, 0x54, 0x5e, 0xa6, 0xc1, 0xab, 0x74, 0x5c,
  0x54, 0x73, 0xaa, 0x97, 0x41, 0x65, 0xd7, 0xe3, 0x7f, 0x3e, 0x25, 0x22,
  0x5d, 0xc9, 0xfb, 0x84, 0x3f, 0x7e, 0x94, 0x85, 0x80, 0x4e, 0x2e, 0x7c,
  0xc0, 0x9e, 0x52, 0x4f, 0x87, 0xb6, 0xbb, 0x94, 0x7b, 0x87, 0xa6, 0x5f,
  0x22, 0x62, 0x95, 0xa6, 0x8d, 0x62, 0x78, 0xa5, 0xb0, 0x88, 0x55, 0x48,
  0x68, 0x8c, 0x9d, 0xc4, 0xba, 0x61, 0x5a, 0x89, 0x76, 0x45, 0x43, 0x81,
  0x8a, 0xb8, 0xe8, 0x95, 0x33, 0x62, 0x9d, 0x71, 0x71, 0x9e, 0xa0, 0x83,
  0x71, 0x45, 0x4a, 0x94, 0xe5, 0xcb, 0x79, 0x67, 0x76, 0x83, 0x7a, 0x70,
  0x46, 0x35, 0x7e, 0xf0, 0xe5, 0x70, 0x38, 0x62, 0x8c, 0x8b, 0x85, 0x64,
  0x84, 0xa9, 0x9d, 0x84, 0x8a, 0x86, 0x53, 0x57, 0x52, 0x4e, 0x82, 0xc0,
  0xbc, 0x82, 0x74, 0x86, 0x7a, 0x7a, 0x99, 0x8a, 0x4f, 0x45, 0x8e, 0xbe,
  0x98, 0x48, 0x39, 0x8a, 0xe8, 0xf3, 0x88, 0x10, 0x20, 0x8f, 0x9a, 0x81,
  0x7f, 0x7c, 0x8c, 0xa4, 0x9f, 0x56, 0x35, 0x70, 0xa6, 0xa0, 0x88, 0xa3,
  0x92, 0x60, 0x73, 0x7b, 0x6e, 0x57, 0x68, 0x9d, 0x8b, 0x5e, 0x70, 0x9b,
  0xae, 0xa8, 0x90, 0x63, 0x73, 0xac, 0xa6, 0x82, 0x54, 0x4d, 0x61, 0x80,
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
};
const uint16_t wav_len = 7824;

// 8MHz / 8 / 42 = 23.81kHz
#define OCR0A_DEFAULT 42
