IowaScaledEngineering/ckt-dingdong/src/bell/safetran-hybrid-16k.h

#include <avr/pgmspace.h>

const uint8_t wav[] PROGMEM = {
  0x7e, 0x80, 0x7e, 0x80, 0x7c, 0x80, 0x7c, 0x7e, 0x80, 0x7a, 0x7e, 0x7e,
  0x7c, 0x7e, 0x7c, 0x7e, 0x7e, 0x7c, 0x7f, 0x7a, 0x80, 0x7a, 0x7f, 0x7c,
  0x7e, 0x7c, 0x7c, 0x7c, 0x7a, 0x7e, 0x7e, 0x7c, 0x8a, 0x80, 0x6d, 0x7e,
  0x7c, 0x8a, 0x72, 0x77, 0x7e, 0x7c, 0x83, 0x79, 0x7e, 0x72, 0x74, 0x6f,
  0x8d, 0x92, 0x7a, 0x6b, 0x72, 0x7c, 0x86, 0x7a, 0x7e, 0x81, 0x7c, 0xa3,
  0x80, 0x4d, 0x57, 0x9a, 0x72, 0x50, 0xb0, 0x99, 0x8d, 0x99, 0x70, 0x74,
  0x61, 0xa6, 0x6d, 0x41, 0xda, 0x72, 0x57, 0x8d, 0x4d, 0x8b, 0xa1, 0x35,
  0x4f, 0x9f, 0x4b, 0xa8, 0x46, 0x4b, 0xe3, 0x5c, 0x70, 0x97, 0x66, 0x7a,
  0xcf, 0x43, 0x50, 0x90, 0x95, 0x99, 0x68, 0x6a, 0xb7, 0x75, 0x61, 0x8b,
  0x52, 0xb4, 0xb4, 0x65, 0x66, 0xf0, 0x4a, 0x9a, 0xab, 0x2a, 0xb0, 0x8d,
  0x70, 0xa3, 0x5c, 0x77, 0xd4, 0x20, 0x61, 0xd9, 0x2f, 0xa6, 0x95, 0x37,
  0xcb, 0x72, 0x1a, 0x9a, 0xc1, 0x3f, 0x68, 0x63, 0x75, 0x97, 0x54, 0x7e,
  0x72, 0x54, 0x9c, 0x9a, 0x1a, 0x6a, 0x97, 0x70, 0x9c, 0x66, 0x46, 0xd2,
  0x8a, 0x15, 0xa1, 0x88, 0x61, 0x6b, 0x6f, 0xb7, 0x60, 0x5e, 0x88, 0x70,
  0x25, 0xaf, 0xa1, 0x08, 0xbf, 0x80, 0x75, 0x90, 0x68, 0x5a, 0xaa, 0x99,
  0x1a, 0x8b, 0x97, 0xa1, 0x5c, 0x6a, 0xcf, 0x72, 0x54, 0x9e, 0xa3, 0x2d,
  0x9c, 0xc1, 0x45, 0x94, 0xb0, 0x90, 0x68, 0x86, 0x6b, 0xad, 0x6b, 0x50,
  0xaf, 0x8d, 0x9a, 0x80, 0x57, 0xaf, 0xa8, 0x3e, 0x97, 0x9a, 0x4f, 0x85,
  0xaf, 0x4f, 0x7e, 0x8b, 0x6b, 0x85, 0x7e, 0x74, 0x8b, 0x8a, 0x52, 0x75,
  0x83, 0x81, 0x6b, 0x50, 0x9e, 0x9f, 0x2a, 0x97, 0x99, 0x3a, 0x70, 0xba,
  0x4b, 0x54, 0xaf, 0x72, 0x83, 0x70, 0x7c, 0x83, 0x77, 0x72, 0x77, 0x72,
  0x92, 0x65, 0x3e, 0xa5, 0x9f, 0x5a, 0x85, 0x9f, 0x6f, 0x79, 0x8b, 0x81,
  0x4d, 0xab, 0x97, 0x65, 0x88, 0x75, 0x9c, 0x70, 0x6b, 0x75, 0x81, 0x88,
  0x6d, 0x72, 0xa5, 0xa3, 0x39, 0x6a, 0xa6, 0x6f, 0x75, 0x6f, 0x6d, 0x7c,
  0x70, 0x9a, 0x65, 0x5a, 0xa6, 0x90, 0x74, 0x7c, 0x6b, 0x7c, 0xcd, 0x63,
  0x55, 0xb2, 0x7a, 0x63, 0x7c, 0x97, 0x7e, 0x55, 0x6d, 0xa8, 0x8a, 0x72,
  0x9c, 0x66, 0x4f, 0xcb, 0x6b, 0x2f, 0x97, 0x8b, 0x8d, 0x7a, 0x74, 0x5c,
  0x9f, 0x83, 0x65, 0x54, 0x79, 0xc5, 0x5c, 0x4d, 0xba, 0x8f, 0x48, 0x97,
  0x61, 0x55, 0xc6, 0x52, 0x46, 0xb4, 0x57, 0x92, 0x8a, 0x54, 0xa1, 0xa3,
  0x5f, 0x66, 0x7a, 0x6b, 0xe6, 0x37, 0x4b, 0xca, 0x66, 0x74, 0x72, 0x7c,
  0x7e, 0xaa, 0x60, 0x61, 0xb2, 0x77, 0x8f, 0x6f, 0x5f, 0xa6, 0x72, 0x70,
  0x99, 0x5a, 0x83, 0xa8, 0x48, 0x6a, 0xa0, 0x7a, 0x8a, 0x70, 0x5a, 0xbc,
  0x80, 0x77, 0x7f, 0x81, 0x9a, 0x60, 0x5f, 0x6a, 0xc1, 0x50, 0x70, 0xa0,
  0x50, 0x97, 0x88, 0x8d, 0x5e, 0x75, 0x99, 0x5e, 0x92, 0x50, 0x7e, 0xa6,
  0x75, 0x79, 0x54, 0x9e, 0x88, 0x59, 0x7a, 0xaa, 0x66, 0x52, 0xb5, 0x74,
  0x77, 0x83, 0x81, 0x79, 0x43, 0x9c, 0x8f, 0x55, 0x7c, 0x83, 0x8f, 0x77,
  0x7c, 0x70, 0x8f, 0x9c, 0x48, 0x6d, 0x9c, 0x94, 0x5e, 0x92, 0x8f, 0x45,
  0x9e, 0x70, 0x7e, 0x72, 0x81, 0xba, 0x59, 0x68, 0x94, 0xa3, 0x57, 0x70,
  0x81, 0x83, 0x9c, 0x3e, 0x90, 0x8b, 0x68, 0x86, 0x63, 0x75, 0x8f, 0x7e,
  0x85, 0x7e, 0x68, 0x77, 0xa5, 0x61, 0x68, 0xa3, 0x85, 0x86, 0x4a, 0x90,
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
};
const uint16_t wav_len = 7511;

// 8MHz / 8 / 63 = 15.87kHz
#define OCR0A_DEFAULT 63
