IowaScaledEngineering/ckt-dingdong/src/cicada/end.h

#include <avr/pgmspace.h>

const uint8_t end_wav[] PROGMEM = {
  0x7d, 0x7c, 0xa5, 0x49, 0x6c, 0xd6, 0x6c, 0x3d, 0xa3, 0xa3, 0x4c, 0x96,
  0x95, 0x57, 0x83, 0x9f, 0x76, 0x66, 0x90, 0x8b, 0x6a, 0x86, 0x8e, 0x6e,
  0x7f, 0x8c, 0x7f, 0x77, 0x76, 0x90, 0x94, 0x57, 0x83, 0x9c, 0x66, 0x92,
  0x7d, 0x67, 0x9a, 0x7a, 0x77, 0x8b, 0x77, 0x7c, 0x8b, 0x7d, 0x78, 0x83,
  0x7e, 0x84, 0x7f, 0x79, 0x86, 0x7d, 0x7f, 0x82, 0x7f, 0x7b, 0x84, 0x7c,
  0x84, 0x99, 0x41, 0x8b, 0xc8, 0x57, 0x51, 0xad, 0x8c, 0x52, 0xaa, 0x7e,
  0x55, 0x9b, 0x94, 0x68, 0x79, 0x8f, 0x7d, 0x76, 0x88, 0x86, 0x6c, 0x88,
  0x8c, 0x75, 0x7c, 0x78, 0x95, 0x87, 0x57, 0x97, 0x85, 0x6e, 0x9b, 0x67,
  0x7b, 0x97, 0x70, 0x86, 0x80, 0x74, 0x89, 0x84, 0x76, 0x82, 0x85, 0x75,
  0x87, 0x80, 0x7b, 0x82, 0x7e, 0x82, 0x7e, 0x80, 0x7e, 0x80, 0x81, 0x7e,
  0x77, 0xa9, 0x57, 0x55, 0xd8, 0x80, 0x34, 0x97, 0xb0, 0x4e, 0x89, 0xa1,
  0x58, 0x7c, 0xa1, 0x7b, 0x65, 0x8c, 0x90, 0x6a, 0x81, 0x93, 0x6f, 0x7b,
  0x8c, 0x82, 0x78, 0x74, 0x8d, 0x99, 0x5a, 0x79, 0xa4, 0x64, 0x8d, 0x87,
  0x60, 0x99, 0x7f, 0x73, 0x8e, 0x76, 0x7a, 0x8e, 0x7d, 0x76, 0x88, 0x7c,
  0x7f, 0x84, 0x7a, 0x85, 0x7c, 0x7e, 0x83, 0x80, 0x72, 0x9e, 0x82, 0x37,
  0xb5, 0xb2, 0x3f, 0x69, 0xb9, 0x6e, 0x66, 0xae, 0x64, 0x68, 0xa5, 0x83,
  0x62, 0x88, 0x8f, 0x72, 0x7b, 0x92, 0x78, 0x6d, 0x95, 0x81, 0x71, 0x81,
  0x7e, 0x99, 0x71, 0x60, 0xa5, 0x77, 0x78, 0x92, 0x64, 0x8d, 0x8a, 0x70,
  0x8b, 0x79, 0x7a, 0x8a, 0x7e, 0x78, 0x86, 0x80, 0x77, 0x87, 0x7e, 0x7f,
  0x7e, 0x7e, 0x84, 0x7b, 0x81, 0x7e, 0x80, 0x7f, 0x81, 0x74, 0xa4, 0x66,
  0x48, 0xcf, 0x91, 0x34, 0x88, 0xb8, 0x55, 0x7c, 0xa5, 0x5e, 0x76, 0x9e,
  0x80, 0x67, 0x87, 0x90, 0x70, 0x7b, 0x95, 0x72, 0x76, 0x8e, 0x81, 0x78,
  0x76, 0x87, 0x9c, 0x61, 0x6c, 0xa9, 0x6c, 0x7f, 0x93, 0x5e, 0x8f, 0x8d,
  0x6f, 0x87, 0x7d, 0x78, 0x8a, 0x83, 0x73, 0x83, 0x83, 0x7e, 0x83, 0x7a,
  0x7f, 0x84, 0x7e, 0x81, 0x7d, 0x80, 0x82, 0x80, 0x73, 0xa4, 0x68, 0x49,
  0xcc, 0x8f, 0x3a, 0x85, 0xb5, 0x57, 0x7d, 0xa9, 0x55, 0x7a, 0xa5, 0x76,
  0x6a, 0x8e, 0x86, 0x73, 0x7f, 0x90, 0x74, 0x75, 0x92, 0x7a, 0x79, 0x7e,
  0x82, 0x99, 0x60, 0x78, 0xa1, 0x68, 0x8b, 0x82, 0x67, 0x99, 0x7a, 0x78,
  0x8c, 0x72, 0x80, 0x8b, 0x7c, 0x75, 0x8a, 0x7f, 0x79, 0x85, 0x7f, 0x80,
  0x7f, 0x7f, 0x83, 0x7b, 0x82, 0x80, 0x7e, 0x7d, 0x85, 0x74, 0x91, 0x90,
  0x37, 0xa3, 0xc3, 0x43, 0x5b, 0xbc, 0x77, 0x5d, 0xaa, 0x74, 0x61, 0x96,
  0x94, 0x68, 0x75, 0x97, 0x7b, 0x70, 0x92, 0x7e, 0x6e, 0x8a, 0x8a, 0x79,
  0x72, 0x7e, 0x9f, 0x79, 0x57, 0xa3, 0x7f, 0x6e, 0x9d, 0x65, 0x7e, 0x96,
  0x6f, 0x87, 0x84, 0x6e, 0x88, 0x8e, 0x71, 0x7a, 0x8b, 0x79, 0x85, 0x7d,
  0x79, 0x85, 0x81, 0x7e, 0x80, 0x7e, 0x82, 0x7c, 0x7f, 0xa2, 0x45, 0x77,
  0xd2, 0x60, 0x48, 0xa9, 0x96, 0x4d, 0xa5, 0x89, 0x4e, 0x98, 0x9b, 0x67,
  0x76, 0x90, 0x7e, 0x75, 0x88, 0x88, 0x6a, 0x86, 0x90, 0x72, 0x7d, 0x7a,
  0x92, 0x87, 0x57, 0x99, 0x88, 0x69, 0x9e, 0x69, 0x77, 0x9b, 0x6f, 0x83,
  0x84, 0x74, 0x85, 0x89, 0x78, 0x7a, 0x83, 0x81, 0x82, 0x7a, 0x80, 0x84,
  0x78, 0x86, 0x80, 0x7c, 0x7f, 0x85, 0x77, 0x8a, 0x98, 0x3a, 0x91, 0xcd,
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
};
const uint16_t end_wav_len = 4776;
