IowaScaledEngineering/ckt-dingdong/src/cicada/start.h

#include <avr/pgmspace.h>

const uint8_t start_wav[] PROGMEM = {
  0x80, 0x85, 0x77, 0x7e, 0x8c, 0x7c, 0x76, 0x82, 0x88, 0x76, 0x87, 0x8c,
  0x61, 0x77, 0xa3, 0x93, 0x60, 0x63, 0x8f, 0xa0, 0x86, 0x60, 0x6e, 0x92,
  0x98, 0x77, 0x69, 0x81, 0x90, 0x83, 0x74, 0x7b, 0x86, 0x86, 0x7a, 0x7b,
  0x83, 0x85, 0x7e, 0x7b, 0x7f, 0x83, 0x7a, 0x86, 0x8d, 0x66, 0x79, 0x9c,
  0x7b, 0x71, 0x87, 0x81, 0x7c, 0x82, 0x83, 0x7a, 0x7c, 0x8a, 0x7e, 0x79,
  0x7f, 0x87, 0x7f, 0x79, 0x81, 0x82, 0x7c, 0x84, 0x8e, 0x67, 0x6c, 0x9b,
  0x9f, 0x6c, 0x55, 0x86, 0xa6, 0x8b, 0x61, 0x6c, 0x8e, 0x99, 0x7c, 0x68,
  0x7d, 0x91, 0x86, 0x73, 0x79, 0x87, 0x87, 0x7b, 0x78, 0x82, 0x86, 0x81,
  0x79, 0x7c, 0x80, 0x87, 0x8f, 0x68, 0x72, 0x9e, 0x7f, 0x6d, 0x88, 0x80,
  0x7a, 0x88, 0x81, 0x76, 0x7c, 0x8f, 0x7e, 0x74, 0x84, 0x84, 0x7c, 0x80,
  0x82, 0x7a, 0x7f, 0x87, 0x77, 0x8c, 0x84, 0x5b, 0x84, 0xa8, 0x89, 0x55,
  0x6a, 0x9f, 0x9e, 0x72, 0x60, 0x7e, 0x99, 0x8d, 0x6b, 0x73, 0x8d, 0x88,
  0x78, 0x7a, 0x82, 0x85, 0x7f, 0x78, 0x81, 0x87, 0x80, 0x7c, 0x7a, 0x80,
  0x84, 0x91, 0x73, 0x63, 0x98, 0x91, 0x68, 0x7e, 0x8c, 0x75, 0x82, 0x87,
  0x7c, 0x78, 0x84, 0x86, 0x78, 0x7f, 0x81, 0x7e, 0x80, 0x82, 0x7f, 0x7a,
  0x83, 0x84, 0x7e, 0x7c, 0x80, 0x80, 0x7d, 0x96, 0x73, 0x58, 0x97, 0xaa,
  0x77, 0x4e, 0x79, 0xac, 0x92, 0x60, 0x68, 0x90, 0x96, 0x79, 0x6d, 0x82,
  0x8b, 0x81, 0x76, 0x7f, 0x89, 0x80, 0x75, 0x7d, 0x8b, 0x84, 0x77, 0x79,
  0x7e, 0x87, 0x96, 0x69, 0x68, 0x9c, 0x88, 0x6f, 0x85, 0x7d, 0x77, 0x8d,
  0x81, 0x77, 0x7c, 0x88, 0x81, 0x77, 0x85, 0x7f, 0x7b, 0x83, 0x80, 0x7c,
  0x82, 0x83, 0x78, 0x80, 0x86, 0x7f, 0x75, 0x8d, 0x90, 0x54, 0x7b, 0xae,
  0x8d, 0x55, 0x62, 0xa5, 0x9f, 0x6d, 0x5e, 0x85, 0x9b, 0x83, 0x6a, 0x7a,
  0x8d, 0x85, 0x75, 0x79, 0x89, 0x86, 0x78, 0x76, 0x86, 0x8a, 0x7b, 0x76,
  0x7f, 0x7f, 0x97, 0x79, 0x5b, 0x95, 0x94, 0x6c, 0x81, 0x85, 0x72, 0x8a,
  0x8a, 0x74, 0x77, 0x8c, 0x84, 0x74, 0x85, 0x83, 0x78, 0x81, 0x86, 0x7e,
  0x7b, 0x81, 0x83, 0x7e, 0x80, 0x7f, 0x80, 0x81, 0x81, 0x76, 0x91, 0x88,
  0x50, 0x88, 0xad, 0x85, 0x4e, 0x70, 0xae, 0x8d, 0x66, 0x6e, 0x8d, 0x8d,
  0x7c, 0x74, 0x83, 0x89, 0x78, 0x7b, 0x86, 0x84, 0x79, 0x7c, 0x81, 0x85,
  0x81, 0x78, 0x7c, 0x80, 0x96, 0x7a, 0x5e, 0x92, 0x92, 0x6d, 0x83, 0x83,
  0x6f, 0x90, 0x87, 0x6f, 0x80, 0x86, 0x82, 0x79, 0x83, 0x80, 0x7c, 0x84,
  0x7e, 0x7f, 0x83, 0x7e, 0x7b, 0x84, 0x84, 0x79, 0x7d, 0x86, 0x7f, 0x7d,
  0x79, 0x94, 0x82, 0x50, 0x8f, 0xad, 0x7f, 0x4b, 0x76, 0xb0, 0x8a, 0x64,
  0x6b, 0x93, 0x90, 0x74, 0x74, 0x8a, 0x85, 0x73, 0x7f, 0x8c, 0x80, 0x72,
  0x7e, 0x87, 0x86, 0x7b, 0x76, 0x7d, 0x84, 0x9a, 0x6b, 0x5f, 0xa1, 0x8a,
  0x69, 0x8a, 0x7d, 0x71, 0x96, 0x81, 0x70, 0x7f, 0x89, 0x81, 0x78, 0x84,
  0x7c, 0x7e, 0x87, 0x7c, 0x7b, 0x83, 0x82, 0x7b, 0x82, 0x82, 0x7b, 0x7f,
  0x83, 0x7e, 0x80, 0x7f, 0x7e, 0x78, 0x93, 0x8b, 0x4b, 0x88, 0xb2, 0x81,
  0x4d, 0x72, 0xb2, 0x85, 0x64, 0x73, 0x94, 0x86, 0x73, 0x7c, 0x8a, 0x81,
  0x6e, 0x84, 0x91, 0x79, 0x6f, 0x87, 0x89, 0x7e, 0x79, 0x7d, 0x7c, 0x93,
  0x84, 0x59, 0x8d, 0x97, 0x70, 0x7d, 0x88, 0x6f, 0x87, 0x91, 0x6a, 0x82,
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
};
const uint16_t start_wav_len = 1590;
