IowaScaledEngineering/ckt-dingdong/src/ctcbell/middle.h

#include <avr/pgmspace.h>

const uint8_t wav_middle[] PROGMEM = {
  0x63, 0x3f, 0x96, 0x85, 0x7f, 0xa7, 0x63, 0x73, 0xc2, 0x80, 0x6b, 0x85,
  0x4f, 0x7f, 0xaa, 0x53, 0x68, 0x9a, 0x77, 0xa9, 0xa2, 0x4c, 0x86, 0xa2,
  0x66, 0x85, 0x6c, 0x44, 0xa2, 0x9f, 0x60, 0x92, 0x82, 0x77, 0xbf, 0x7e,
  0x48, 0x8d, 0x76, 0x71, 0x9e, 0x56, 0x5e, 0xb8, 0x8a, 0x81, 0x9b, 0x5a,
  0x83, 0xb5, 0x5b, 0x5f, 0x84, 0x5e, 0x9a, 0xa4, 0x4f, 0x85, 0xaa, 0x79,
  0x9e, 0x7e, 0x41, 0x94, 0x97, 0x59, 0x84, 0x6f, 0x66, 0xc0, 0x92, 0x5a,
  0x97, 0x7f, 0x7a, 0xaa, 0x57, 0x4a, 0x9f, 0x7c, 0x7c, 0x9c, 0x59, 0x81,
  0xc4, 0x75, 0x72, 0x88, 0x55, 0x8f, 0xa2, 0x46, 0x6f, 0x97, 0x74, 0xa9,
  0x93, 0x4b, 0x98, 0xa3, 0x67, 0x8a, 0x65, 0x4c, 0xac, 0x8f, 0x59, 0x92,
  0x7b, 0x80, 0xc0, 0x70, 0x50, 0x99, 0x76, 0x78, 0x98, 0x4a, 0x68, 0xb9,
  0x7e, 0x80, 0x95, 0x5a, 0x94, 0xb3, 0x53, 0x69, 0x85, 0x60, 0xa0, 0x94,
  0x46, 0x8e, 0xa6, 0x78, 0xa1, 0x75, 0x49, 0xa5, 0x90, 0x57, 0x86, 0x68,
  0x6d, 0xc1, 0x80, 0x5a, 0x9d, 0x7c, 0x84, 0xa9, 0x4e, 0x58, 0xa6, 0x74,
  0x7d, 0x93, 0x51, 0x8e, 0xc0, 0x6a, 0x78, 0x88, 0x5a, 0x9d, 0x99, 0x40,
  0x7a, 0x94, 0x72, 0xaa, 0x82, 0x4c, 0xa6, 0x9d, 0x68, 0x8e, 0x60, 0x59,
  0xb5, 0x80, 0x56, 0x93, 0x75, 0x87, 0xbd, 0x62, 0x5a, 0xa2, 0x75, 0x80,
  0x92, 0x42, 0x76, 0xb7, 0x72, 0x81, 0x8c, 0x5a, 0xa3, 0xac, 0x4e, 0x73,
  0x83, 0x65, 0xa7, 0x84, 0x43, 0x97, 0x9e, 0x79, 0xa1, 0x69, 0x54, 0xb1,
  0x89, 0x5b, 0x87, 0x60, 0x78, 0xc0, 0x70, 0x5e, 0x9d, 0x79, 0x8f, 0xa4,
  0x46, 0x66, 0xa9, 0x71, 0x83, 0x87, 0x4d, 0x9b, 0xb8, 0x62, 0x7e, 0x83,
  0x61, 0xaa, 0x8d, 0x3e, 0x84, 0x8f, 0x75, 0xaa, 0x71, 0x50, 0xb0, 0x95,
  0x6b, 0x8f, 0x59, 0x69, 0xba, 0x73, 0x5a, 0x93, 0x6f, 0x92, 0xb5, 0x54,
  0x66, 0xa4, 0x73, 0x89, 0x8a, 0x40, 0x87, 0xb2, 0x6a, 0x84, 0x82, 0x5c,
  0xaf, 0x9f, 0x4a, 0x7f, 0x81, 0x6d, 0xac, 0x74, 0x47, 0xa1, 0x94, 0x78,
  0x9e, 0x5e, 0x61, 0xb8, 0x7d, 0x60, 0x8a, 0x5e, 0x85, 0xba, 0x60, 0x66,
  0x9e, 0x74, 0x96, 0x9a, 0x41, 0x78, 0xa8, 0x6c, 0x88, 0x7f, 0x50, 0xa6,
  0xab, 0x5c, 0x84, 0x7d, 0x67, 0xb0, 0x7f, 0x43, 0x8f, 0x89, 0x7a, 0xa9,
  0x64, 0x5a, 0xb4, 0x89, 0x6e, 0x8e, 0x55, 0x77, 0xb9, 0x68, 0x63, 0x92,
  0x6d, 0x9a, 0xaa, 0x4c, 0x72, 0xa1, 0x70, 0x90, 0x81, 0x42, 0x96, 0xab,
  0x67, 0x89, 0x7a, 0x62, 0xb5, 0x90, 0x4a, 0x86, 0x7d, 0x75, 0xae, 0x68,
  0x4f, 0xa9, 0x8d, 0x7c, 0x99, 0x54, 0x6e, 0xba, 0x72, 0x65, 0x88, 0x5e,
  0x95, 0xb4, 0x55, 0x6e, 0x9c, 0x74, 0x9c, 0x8b, 0x3d, 0x87, 0xa6, 0x6c,
  0x8c, 0x74, 0x57, 0xb4, 0x9f, 0x57, 0x85, 0x76, 0x72, 0xb5, 0x6f, 0x47,
  0x98, 0x87, 0x83, 0xa3, 0x56, 0x66, 0xba, 0x7f, 0x70, 0x86, 0x51, 0x8a,
  0xb7, 0x5c, 0x6a, 0x91, 0x70, 0xa7, 0x9c, 0x42, 0x7e, 0xa0, 0x70, 0x92,
  0x71, 0x47, 0xa8, 0xa4, 0x64, 0x8a, 0x71, 0x6f, 0xbd, 0x7d, 0x48, 0x8a,
  0x7a, 0x81, 0xab, 0x57, 0x5c, 0xb2, 0x88, 0x81, 0x8f, 0x4b, 0x80, 0xb8,
  0x65, 0x68, 0x82, 0x62, 0xa7, 0xaa, 0x4c, 0x7a, 0x9b, 0x78, 0xa1, 0x77,
  0x3b, 0x96, 0x9f, 0x6b, 0x8d, 0x68, 0x65, 0xc2, 0x91, 0x57, 0x86, 0x6f,
  0x7f, 0xb3, 0x5a, 0x4d, 0x9e, 0x85, 0x8e, 0x9c, 0x4b, 0x78, 0xbd, 0x77,
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
};
const uint16_t wav_len_middle = 1000;
