IowaScaledEngineering/ckt-dingdong/src/cicada/mid.h

#include <avr/pgmspace.h>

const uint8_t mid_wav[] PROGMEM = {
  0x80, 0x74, 0x9f, 0x74, 0x43, 0xbc, 0xa4, 0x44, 0x68, 0xbb, 0x73, 0x5c,
  0xa9, 0x76, 0x61, 0x96, 0x94, 0x67, 0x78, 0x92, 0x7f, 0x71, 0x8a, 0x88,
  0x6e, 0x81, 0x8d, 0x7a, 0x77, 0x7d, 0x98, 0x79, 0x60, 0x9d, 0x80, 0x6f,
  0x95, 0x6e, 0x7c, 0x93, 0x6f, 0x8a, 0x7f, 0x72, 0x8b, 0x83, 0x79, 0x7d,
  0x86, 0x7a, 0x80, 0x84, 0x7d, 0x80, 0x7a, 0x85, 0x81, 0x7a, 0x81, 0x82,
  0x7d, 0x7e, 0x81, 0x82, 0x7b, 0x82, 0x77, 0x91, 0x8e, 0x3c, 0x9a, 0xc4,
  0x53, 0x4b, 0xb3, 0x94, 0x52, 0x92, 0x90, 0x65, 0x79, 0x9f, 0x7e, 0x60,
  0x8a, 0x99, 0x69, 0x79, 0x95, 0x78, 0x74, 0x87, 0x88, 0x79, 0x73, 0x93,
  0x88, 0x5b, 0x94, 0x8d, 0x67, 0x96, 0x77, 0x70, 0x99, 0x74, 0x7b, 0x8b,
  0x75, 0x7f, 0x8e, 0x75, 0x79, 0x8d, 0x79, 0x7d, 0x86, 0x79, 0x81, 0x85,
  0x78, 0x83, 0x81, 0x7c, 0x79, 0xa2, 0x63, 0x52, 0xc7, 0x90, 0x40, 0x7b,
  0xba, 0x62, 0x6b, 0xaa, 0x6c, 0x68, 0x9b, 0x8a, 0x66, 0x80, 0x8f, 0x7b,
  0x74, 0x8d, 0x81, 0x6f, 0x88, 0x89, 0x77, 0x7a, 0x80, 0x97, 0x73, 0x66,
  0x9e, 0x78, 0x7a, 0x92, 0x65, 0x89, 0x8e, 0x6e, 0x8b, 0x7c, 0x78, 0x88,
  0x84, 0x77, 0x7c, 0x89, 0x7c, 0x80, 0x7d, 0x7f, 0x85, 0x7d, 0x80, 0x7c,
  0x81, 0x83, 0x7e, 0x7b, 0x83, 0x80, 0x82, 0x73, 0x96, 0x8a, 0x3a, 0xa4,
  0xbe, 0x4b, 0x53, 0xb9, 0x88, 0x55, 0x9a, 0x87, 0x67, 0x81, 0x9a, 0x77,
  0x67, 0x91, 0x8e, 0x67, 0x83, 0x93, 0x73, 0x77, 0x88, 0x87, 0x78, 0x71,
  0x97, 0x89, 0x56, 0x97, 0x8f, 0x61, 0x98, 0x7b, 0x6c, 0x96, 0x78, 0x7c,
  0x87, 0x78, 0x7d, 0x8a, 0x7d, 0x77, 0x89, 0x7b, 0x80, 0x84, 0x79, 0x82,
  0x84, 0x79, 0x82, 0x80, 0x7f, 0x7d, 0x84, 0x75, 0x92, 0x8c, 0x3b, 0xa5,
  0xb9, 0x4d, 0x5c, 0xb2, 0x83, 0x57, 0xa4, 0x7f, 0x5d, 0x90, 0x99, 0x6a,
  0x73, 0x94, 0x80, 0x6f, 0x8a, 0x8b, 0x6f, 0x7c, 0x8e, 0x80, 0x76, 0x78,
  0x95, 0x85, 0x59, 0x96, 0x8b, 0x69, 0x96, 0x74, 0x72, 0x97, 0x73, 0x83,
  0x80, 0x75, 0x8b, 0x7f, 0x7c, 0x7e, 0x86, 0x79, 0x82, 0x85, 0x77, 0x82,
  0x81, 0x80, 0x7e, 0x7e, 0x84, 0x7b, 0x81, 0x7f, 0x82, 0x7c, 0x80, 0x78,
  0x98, 0x82, 0x3b, 0xad, 0xb8, 0x47, 0x57, 0xbc, 0x7f, 0x59, 0x9f, 0x81,
  0x65, 0x84, 0x9d, 0x74, 0x68, 0x8d, 0x91, 0x6b, 0x7e, 0x94, 0x71, 0x77,
  0x8d, 0x84, 0x77, 0x72, 0x9a, 0x84, 0x58, 0x9b, 0x86, 0x68, 0x9a, 0x73,
  0x70, 0x99, 0x75, 0x7d, 0x87, 0x76, 0x80, 0x8b, 0x7a, 0x78, 0x89, 0x79,
  0x82, 0x86, 0x75, 0x83, 0x85, 0x7a, 0x81, 0x82, 0x7a, 0x82, 0x84, 0x77,
  0x85, 0x80, 0x7e, 0x77, 0xa0, 0x6f, 0x47, 0xc0, 0x9d, 0x42, 0x70, 0xb9,
  0x6b, 0x67, 0xa9, 0x6b, 0x69, 0x9b, 0x8b, 0x66, 0x7e, 0x91, 0x7c, 0x72,
  0x8b, 0x87, 0x6d, 0x85, 0x8c, 0x76, 0x78, 0x83, 0x96, 0x6d, 0x6d, 0xa0,
  0x72, 0x7b, 0x94, 0x64, 0x88, 0x90, 0x6d, 0x8a, 0x7c, 0x7a, 0x88, 0x7e,
  0x7b, 0x81, 0x85, 0x75, 0x86, 0x83, 0x78, 0x80, 0x82, 0x82, 0x7c, 0x7e,
  0x82, 0x7f, 0x80, 0x7c, 0x83, 0x7e, 0x81, 0x7a, 0x83, 0xa1, 0x45, 0x75,
  0xd1, 0x6e, 0x3a, 0xa0, 0xa8, 0x52, 0x89, 0x94, 0x6a, 0x73, 0x99, 0x8a,
  0x61, 0x7e, 0x9d, 0x73, 0x6d, 0x97, 0x7e, 0x70, 0x85, 0x89, 0x7d, 0x71,
  0x8e, 0x91, 0x58, 0x8d, 0x95, 0x62, 0x96, 0x7c, 0x67, 0x9c, 0x7c, 0x70,
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
};
const uint16_t mid_wav_len = 745;
