IowaScaledEngineering/ckt-dingdong/src/sbplus/sbp-demo/src/i2c.c

/*************************************************************************
Title:    Big-Bang I2C Library
Authors:  Michael Petersen <railfan@drgw.net>
          Nathan D. Holmes <maverick@drgw.net>
File:     i2c.h
License:  GNU General Public License v3

LICENSE:
    Copyright (C) 2024 Michael Petersen & Nathan Holmes

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
*************************************************************************/

#include "i2c.h"

static inline void sda_low() { DDRA |= _BV(SDA); PORTA &= ~_BV(SDA); _delay_us(1); }
static inline void sda_high() { DDRA &= ~_BV(SDA); PORTA |= _BV(SDA); _delay_us(1); }
static inline void scl_low() { PORTA &= ~_BV(SCL); _delay_us(1); }
static inline void scl_high() { PORTA |= _BV(SCL); _delay_us(1); }


void i2cStart(void)
{
	scl_high();
	sda_low();
	scl_low();
	sda_high();
}

void i2cStop(void)
{
	scl_low();
	sda_low();
	scl_high();
	sda_high();
}

uint8_t i2cWriteByte(uint8_t byte)
{
	uint8_t i = 0x80, ack;

	do
	{
		if(byte & i)
		{
			sda_high();
		}
		else
		{
			sda_low();
		}
		
		scl_high();
		scl_low();
		
		i >>= 1;
	} while(i);

	sda_high();  // Release SDA
	
	scl_high();
	if(PINA & _BV(SDA))
		ack = 0;
	else
		ack = 1;
	scl_low();

	return ack;
}

uint8_t i2cReadByte(uint8_t ack)
{
	uint8_t i=0, data = 0;

	for(i=0; i<8; i++)
	{
		data<<=1;
		scl_high();
		if (PINA & _BV(SDA))
			data |= 0x01;
		scl_low();
	}
	
	if(ack)
		sda_low();
	scl_high();
	scl_low();
	sda_high();

	return data;
}

uint8_t writeByte(uint8_t addr, uint8_t cmd, uint8_t writeVal)
{
	uint8_t ack;
	
	i2cStart();
	
	i2cWriteByte(addr << 1);
	i2cWriteByte(cmd);
	ack = i2cWriteByte(writeVal);

	i2cStop();

	return ack;
}

uint8_t readByte(uint8_t addr, uint8_t cmd, uint8_t* data)
{
	uint8_t ack = 1;
	*data = 0x00;
	
	i2cStart();
	
	ack &= i2cWriteByte(addr << 1);
	ack &= i2cWriteByte(cmd);

	i2cStart();

	ack &= i2cWriteByte((addr << 1) | 0x01);
	*data = i2cReadByte(0);
	i2cStop();
	return ack;
}
