IowaScaledEngineering/ckt-dingdong/(commit log)

2020-08-06 Initial checkin
    [ckt-dingdong.sch]
2020-08-06 Fixed title block text
    [ckt-dingdong.sch]
2020-08-06 Labeled terminal block
    [ckt-dingdong.sch]
2020-08-07 Added reset RC, trigger cap, power LED.
    [ckt-dingdong.sch]
2020-08-07 Added "almost" Qwiic connector
    [ckt-dingdong.sch]
2020-08-12 1st rev of PCB
    [ckt-dingdong.pcb]
2020-08-15 PCB design
    [ckt-dingdong.pcb, ckt-dingdong.sch]
2020-08-20 Updated refdes
    [ckt-dingdong.pcb, ckt-dingdong.sch]
2020-08-20 Panelized version
    [ckt-dingdong-panel.pcb]
2020-08-20 Sent to fab 8/19
    [ckt-dingdong-panel.bottom.gbr, ckt-dingdong-panel.bottommask.gbr, ckt-dingdong-panel.bottompaste.gbr, ckt-dingdong-panel.bottomsilk.gbr, ckt-dingdong-panel.fab.gbr, ckt-dingdong-panel.outline.gbr, ckt-dingdong-panel.top.gbr, ckt-dingdong-panel.topmask.gbr]
2020-09-11 Changed R2 to 10k. Moved R1 from reset pull-up to input R. Added C7 to reset line.
    [ckt-dingdong.sch]
2020-09-11 Changed "ocr0a" variable to "pitch"
2020-09-12 v1.1 edits
    [ckt-dingdong.pcb]
2020-09-13 v1.1 panelized version
    [ckt-dingdong-panel.pcb]
2020-09-15 Sent to fab 9/13/2020
    [ckt-dingdong-panel.bottom.gbr, ckt-dingdong-panel.bottommask.gbr, ckt-dingdong-panel.bottompaste.gbr, ckt-dingdong-panel.bottomsilk.gbr, ckt-dingdong-panel.fab.gbr, ckt-dingdong-panel.outline.gbr, ckt-dingdong-panel.top.gbr, ckt-dingdong-panel.topmask.gbr]
2021-02-06 Increased text size and added print settings
2021-02-10 Initial cut of dingdong with a SPI flash on board
    [ckt-dingdong.pcb, ckt-dingdong.sch]
2021-02-10 Misc. layout tweaks and cleanup
    [ckt-dingdong.pcb]
2021-02-22 Update silk
    [ckt-dingdong.pcb]
2021-02-22 Update to ckt-dingdong v2.0
    [ckt-dingdong.pcb]
2021-02-22 pg SPI
    [ckt-dingdong.bottom.gbr, ckt-dingdong.bottommask.gbr, ckt-dingdong.bottompaste.gbr, ckt-dingdong.bottomsilk.gbr, ckt-dingdong.fab.gbr, ckt-dingdong.outline.gbr, ckt-dingdong.top.gbr, ckt-dingdong.topmask.gbr]
2021-03-16 Updated print settings. Added WRS label.
2021-05-24 Initial placement
    [dingdong-demo.pcb]
2021-05-31 Demo circuit wired
    [dingdong-demo.pcb, dingdong-demo.sch]
2021-05-31 Enlarged switch pads on bottom
    [dingdong-demo.pcb, dingdong-demo.sch]
2021-05-31 Moved all components to bottom
    [dingdong-demo.pcb]
2021-05-31 Cleaned up LVS. Removed metal around small cutout.
    [dingdong-demo.pcb]
2021-06-24 Sent to fab Jun '21
    [dingdong-demo.bottom.gbr, dingdong-demo.bottommask.gbr, dingdong-demo.bottompaste(mod).gbr, dingdong-demo.bottompaste.gbr, dingdong-demo.bottomsilk.gbr, dingdong-demo.fab.gbr, dingdong-demo.outline.gbr, dingdong-demo.top.gbr]
2021-07-11 Standoffs for demo panel
2021-10-14 Updated printer preferences
2021-12-14 Refactored where audio lives Redid how the audio buffer works to eliminate a lot of CPU Made SPI much faster by changing away from how tinySPI did clocking
2021-12-14 There we go - reads ISPL tables correctly
    [main.c, spiflash.c]
2021-12-14 Add millis timer to sound ISR Add ability to sense input line
2021-12-17 Add the spi flash programmer sketch/python I've been using
2021-12-22 Start of ISPL assembler
2021-12-22 Fix issue with popping things off the stack - was grabbing the empty space under the stack pointer, not the first valid value
    [audio.c, test-vm.c]
2021-12-23 Fix issue with U4 SPI flash footprint Add decoupling local to SPI and micro
    [ckt-dingdong.pcb, ckt-dingdong.sch]
2021-12-31 EE generator for demo boards (short delay)
    [generateEE-demo.py]
2021-12-31 Removed 3.3V warning
2021-12-31 Add prototype for squealer
2022-02-27 Squealer with a bunch of samples and 0.2-1.5s delay
2022-02-27 Update the test vm debugger to help find problems and print stack contents
    [test-vm.c]
2022-04-25 Add SPI flash programming board based on FT232H breakout
    [spiflash-prog.pcb, spiflash-prog.sch]
2022-05-12 Taller standoffs for demo boards
2022-05-12 Added P&P compatible PCB array.
    [ckt-dingdong-array.pcb]
2022-05-15 Removed paste from fiducials
    [ckt-dingdong-array.pcb]
2022-05-15 Sent to fab 5/14/2022
    [ckt-dingdong-array.bottom.gbr, ckt-dingdong-array.bottommask.gbr, ckt-dingdong-array.bottompaste.gbr, ckt-dingdong-array.bottomsilk.gbr, ckt-dingdong-array.fab.gbr, ckt-dingdong-array.outline.gbr, ckt-dingdong-array.top.gbr, ckt-dingdong-array.topmask.gbr]
2022-07-20 Hum files and updated label files
    [bell.dwg]
2022-08-13 Wiring diagrams
2022-09-09 Added ckt-dingdong-spk board
    [ckt-dingdong-spk.kicad_pcb, ckt-dingdong-spk.kicad_sch]
2022-10-13 Changed soldermask spacing to 3mil
    [ckt-dingdong-spk.kicad_pcb]
2022-10-13 Array of boards
    [ckt-dingdong-spk-array.kicad_pcb]
2022-10-16 Added array board
    [ckt-dingdong-spk-array.kicad_pcb]
2022-10-16 PG files for speaker board
    [ckt-dingdong-spk-array-NPTH.drl, ckt-dingdong-spk-array.drl, ckt-dingdong-spk-array.gbl, ckt-dingdong-spk-array.gbo, ckt-dingdong-spk-array.gbp, ckt-dingdong-spk-array.gbr, ckt-dingdong-spk-array.gbs, ckt-dingdong-spk-array.gm1]
2023-03-07 Changed to SM04B connector
    [ckt-dingdong-spk.kicad_pcb, ckt-dingdong-spk.kicad_sch]
2023-03-16 Updated array with v2 board
    [ckt-dingdong-spk-array.kicad_pcb]
2023-03-17 Changed to horizontal array and removed half the tabs
    [ckt-dingdong-spk-array.kicad_pcb]
2023-03-17 Changed to 10x array
    [ckt-dingdong-spk-array.kicad_pcb]
2023-03-25 Sent to fab March 2023
    [ckt-dingdong-spk-array-NPTH.drl, ckt-dingdong-spk-array.drl, ckt-dingdong-spk-array.gbl, ckt-dingdong-spk-array.gbo, ckt-dingdong-spk-array.gbp, ckt-dingdong-spk-array.gbr, ckt-dingdong-spk-array.gbs, ckt-dingdong-spk-array.gm1]
2023-06-02 Changed to 5x panel
    [ckt-dingdong-spk-array.kicad_pcb]
2023-06-28 Re-panelized to 5x. Sent to fab June 2023.
    [ckt-dingdong-spk-array-NPTH.drl, ckt-dingdong-spk-array.drl, ckt-dingdong-spk-array.gbl, ckt-dingdong-spk-array.gbo, ckt-dingdong-spk-array.gbp, ckt-dingdong-spk-array.gbr, ckt-dingdong-spk-array.gbs, ckt-dingdong-spk-array.gm1]
2023-07-05 Added DC only note and updated printer settings
2023-09-05 Initial flash version
    [ckt-dingdong-flash.kicad_pcb, ckt-dingdong-flash.kicad_sch]
2023-09-06 Improved routing. Re-wired '861 and programming header for better layout.
    [ckt-dingdong-flash.kicad_pcb, ckt-dingdong-flash.kicad_sch]
2023-09-06 More updates
    [ckt-dingdong-flash.kicad_pcb, ckt-dingdong-flash.kicad_sch]
2023-09-06 Text changes
    [ckt-dingdong-flash.kicad_pcb]
2023-09-06 Moved reset RC, added pullup to /CS, tied flash /WP and /RESET to 3.3V
    [ckt-dingdong-flash.kicad_pcb, ckt-dingdong-flash.kicad_sch]
2023-09-06 Minor adjustments
    [ckt-dingdong-flash.kicad_pcb]
2023-09-08 Small adjustments
    [ckt-dingdong-flash.kicad_pcb]
2023-09-08 Initial checkin for programming board
    [ckt-dingdong-prog.kicad_pcb, ckt-dingdong-prog.kicad_sch]
2023-09-13 Programming board PCB complete
    [ckt-dingdong-prog.kicad_pcb, ckt-dingdong-prog.kicad_sch]
2023-09-13 Added pin 1 markers
    [ckt-dingdong-prog.kicad_pcb]
2023-09-17 Fixed DRC
    [ckt-dingdong-flash.kicad_pcb]
2023-09-17 Fixed DRCs
    [ckt-dingdong-flash.kicad_pcb]
2023-09-17 Fixed more DRCs
    [ckt-dingdong-flash.kicad_pcb]
2023-09-18 Updated SOT89 footprint to match AP7381 recommendations
    [ckt-dingdong-flash.kicad_pcb, ckt-dingdong-flash.kicad_sch]
2023-09-18 Fixed SOT89 footprint
    [ckt-dingdong-flash.kicad_pcb]
2023-09-18 Angled SOT89 footprint
    [ckt-dingdong-flash.kicad_pcb]
2023-09-21 Sent to fab Sep 2023
    [ckt-dingdong-flash-NPTH.drl, ckt-dingdong-flash.drl, ckt-dingdong-flash.gbl, ckt-dingdong-flash.gbo, ckt-dingdong-flash.gbp, ckt-dingdong-flash.gbr, ckt-dingdong-flash.gbs, ckt-dingdong-flash.gm1]
2023-10-01 Put back the latest real versions of pcb and sch since the initial version of the spiflash dinging isn't ever going forward
    [ckt-dingdong.pcb, ckt-dingdong.sch]
2023-10-02 Intiial pass on getting it to compile for new hardware - probably doesn't work, but closer
    [audio.c, main.c, spiflash.c, spiflash.h]
2023-10-03 Various fixes to get closer to working - audio modulator works now, as does SPI
    [audio.c, spiflash.c]
2023-11-01 Fixed programming header
    [ckt-dingdong-prog.kicad_sch]
2023-11-02 prog v1.1 fab files
    [ckt-dingdong-prog-NPTH.drl, ckt-dingdong-prog.drl, ckt-dingdong-prog.gbl, ckt-dingdong-prog.gbo, ckt-dingdong-prog.gbp, ckt-dingdong-prog.gbr, ckt-dingdong-prog.gbs, ckt-dingdong-prog.gm1]
2023-11-02 Panelized board
    [ckt-dingdong-flash-array.kicad_pcb]
2023-11-02 Removed silkscreen link on SM04B-SRSS that collided with tab mousebites
    [ckt-dingdong-flash-array.kicad_pcb]
2023-11-02 Panelized version for fab
    [ckt-dingdong-flash-array-NPTH.drl, ckt-dingdong-flash-array.drl, ckt-dingdong-flash-array.gbl, ckt-dingdong-flash-array.gbo, ckt-dingdong-flash-array.gbp, ckt-dingdong-flash-array.gbr, ckt-dingdong-flash-array.gbs, ckt-dingdong-flash-array.gm1]
2023-11-19 Start of a bootloader that will re-burn the attiny85 from flash memory if a valid image is found
    [spiflash.c, spiflash.h]
2023-11-19 Update scrunchy to just take attiny85 hex files, not ISPL assembly
2023-11-30 Change to 1.8V undervoltage
2023-12-01 Fix issue with sbp-outhouse being triggered the wrong way
    [main.c]
2023-12-10 Update programmer to fix SCK / MISO reversal, now v1.2
    [ckt-dingdong-prog.kicad_pcb, ckt-dingdong-prog.kicad_sch]
2023-12-10 Add programmer v1.2
    [ckt-dingdong-prog-NPTH.drl, ckt-dingdong-prog.drl, ckt-dingdong-prog.gbl, ckt-dingdong-prog.gbo, ckt-dingdong-prog.gbp, ckt-dingdong-prog.gbr, ckt-dingdong-prog.gbs, ckt-dingdong-prog.gm1]
2024-01-21 Updated panelization
    [ckt-dingdong-spk-array.kicad_pcb]
2024-01-21 Update the sbp-outhouse to set the BOD to 1.8V as well. In theory this shouldn't matter because the bootloader should be burning the fuses, but when directly burning / testing project firmware, might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
2024-02-13 Sent to fab
    [ckt-dingdong-spk-array-NPTH.drl, ckt-dingdong-spk-array.drl, ckt-dingdong-spk-array.gbl, ckt-dingdong-spk-array.gbo, ckt-dingdong-spk-array.gbp, ckt-dingdong-spk-array.gbr, ckt-dingdong-spk-array.gbs, ckt-dingdong-spk-array.gm1]
2024-06-03 Fading code (doesn't work at 32kHz)
    [audio.c, audio.h, main.c]
2024-06-15 Fix issue where millis wasn't being handled safely between the ISR and main code
    [audio.c, audio.h, main.c]
2025-01-20 Removed labels
    [bell.dwg]
