IowaScaledEngineering/ckt-dingdong/(notices)

Notices in the files:
kicad/ckt-dingdong-flash/ckt-dingdong-flash-array.kicad_pcb:
©2023
CC BY-SA
kicad/ckt-dingdong-spk/ckt-dingdong-spk.kicad_pcb:
©2023 CC BY-SA
